rogerclarkmelbourne/STM32_Pill_Boards/BluepillF4/BluepillF4_3D_Top.png

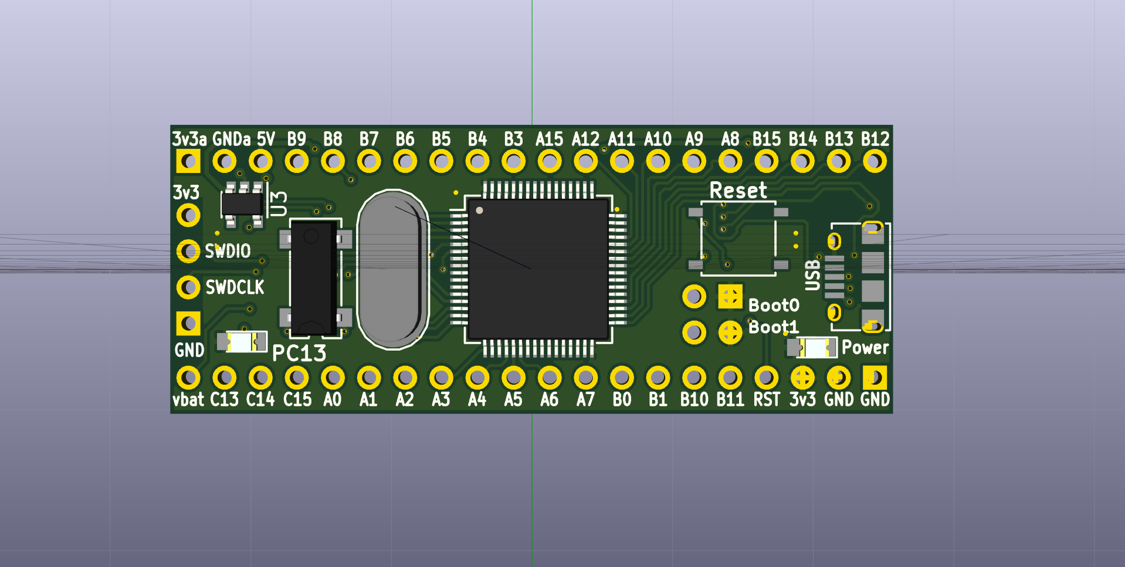
BluepillF4/BluepillF4_3D_Top.png
