rogerclarkmelbourne/STM32_Pill_Boards/BluepillF4/BluepillF4_3D_Bottom.png

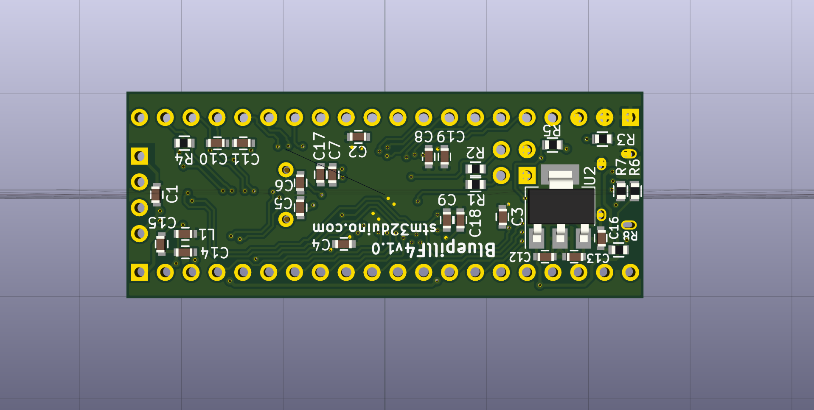
BluepillF4/BluepillF4_3D_Bottom.png
