rogerclarkmelbourne/STM32_Pill_Boards/README.md

# STM32_Pill_Boards

This repo contains a KiCad conversion of the STM32STAMP board and also two new BluePill F4 boards designed by @racemaniac and @Squonk42

My previous attemps have been deleted.
