rogerclarkmelbourne/STM32_Pill_Boards/STM32F4Stamp/README.md

# F405Pill
STM32F405RG development board based on the STM32STAMP board
