rogerclarkmelbourne/STM32_Pill_Boards/Squonk42/KiCAD/3D Models/U02-BFD3111B0-009/U02-BFD3111B0-009 Assembly with Plug.fcstd

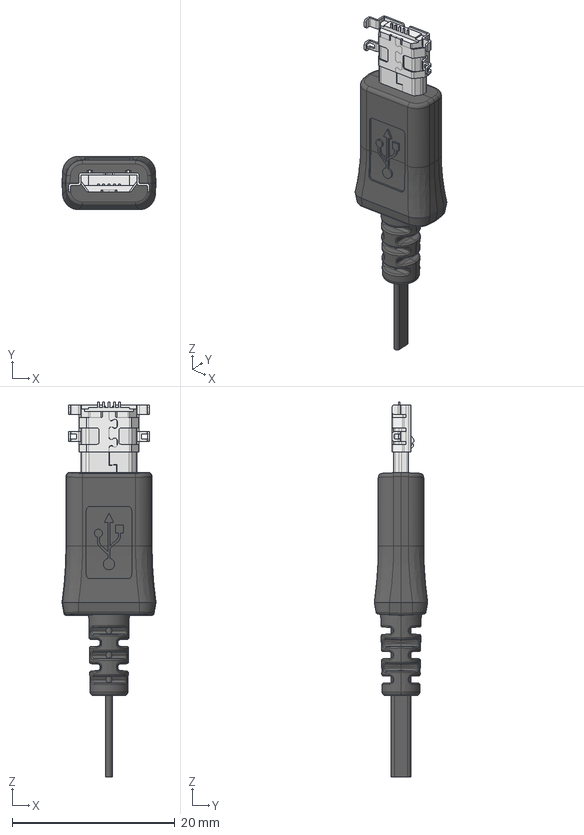
[picture p3: CAD file, 2018-01-29]
Squonk42/KiCAD/3D Models/U02-BFD3111B0-009/U02-BFD3111B0-009 Assembly with Plug.fcstd
11.6 x 6.57 x 46.2 mm
Micro_USB_Plug_Molding_¹w³]
Micro_USB_Plug_cable_¹w³]
Micro_USB_Plug_Connector_¹w³]
Micro_USB_Plug_Connector_¹w³]001
Micro_USB_Plug_Connector_¹w³]002
Micro_USB_Plug_Connector_¹w³]003
U02_BFD3111B0_009_Assembly_01
