rogerclarkmelbourne/STM32_Pill_Boards/Squonk42/KiCAD/3D Models/1616 RGB LED/1616 RGB LED Assembly.fcstd

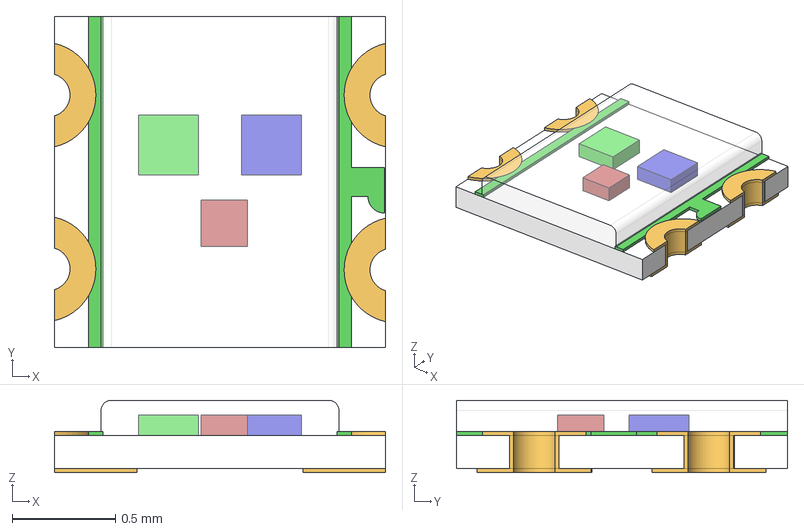
[picture p4: CAD file, 2018-01-02]
Squonk42/KiCAD/3D Models/1616 RGB LED/1616 RGB LED Assembly.fcstd
1.60 x 1.60 x 0.35 mm
_616_RGB_LED_Body_01
_616_RGB_LED_Pad_01
_616_RGB_LED_Pad_002
_616_RGB_LED_Pad_003
_616_RGB_LED_Pad_004
_616_RGB_LED_Lens_01
_616_RGB_LED_Blue_01
_616_RGB_LED_Green_01
_616_RGB_LED_Red_01
_616_RGB_LED_Anode_01
_616_RGB_LED_Cathode_01
