rogerclarkmelbourne/STM32_Pill_Boards/Squonk42/KiCAD/3D Models/MicroSD Card/MicroSD Card Assembly.fcstd

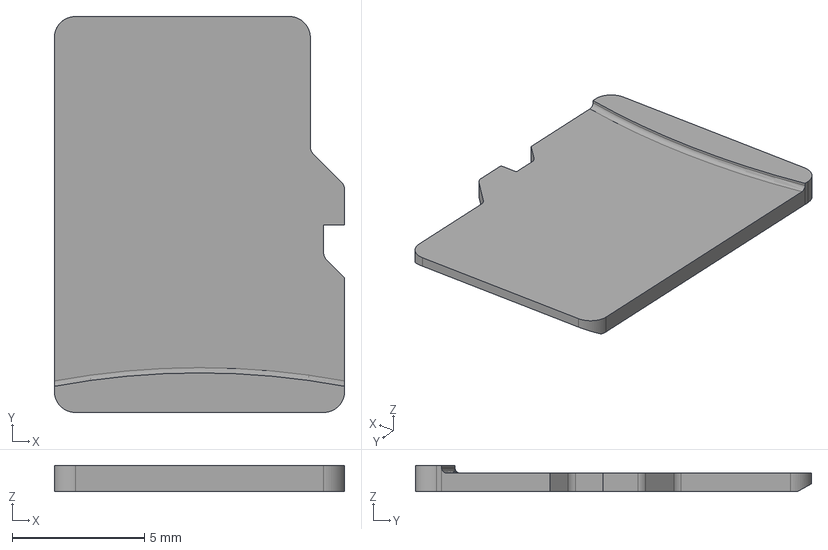
[picture p5: CAD file, 2018-01-02]
Squonk42/KiCAD/3D Models/MicroSD Card/MicroSD Card Assembly.fcstd
11.0 x 15.0 x 1.00 mm
Pin 1
Pin 2
Pin 3
Pin 5
Pin 7
Pin 8
Pin 4
Pin 6
