rogerclarkmelbourne/STM32_Pill_Boards/Squonk42/KiCAD/3D Models/FC-12M/FC-12M Assembly.fcstd

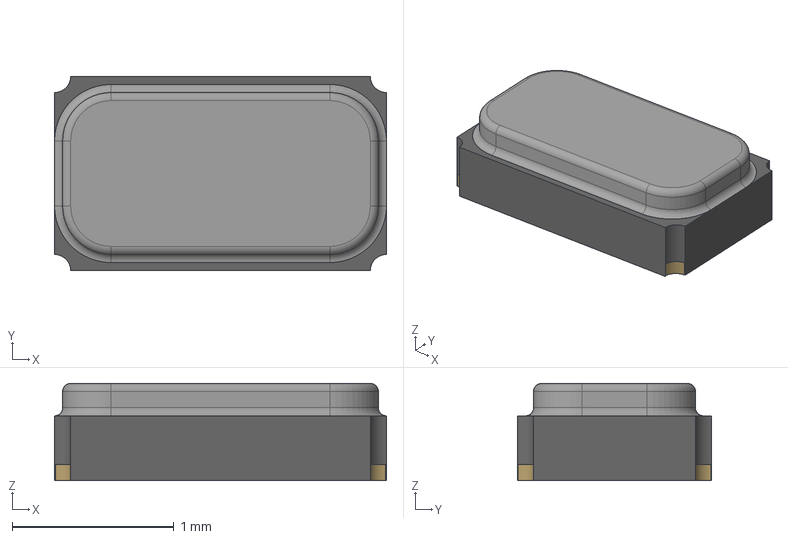
[picture p6: CAD file, 2018-01-02]
Squonk42/KiCAD/3D Models/FC-12M/FC-12M Assembly.fcstd
2.05 x 1.20 x 0.6 mm
FC_12M_Body_01
FC_12M_PAD_01
FC_12M_PAD_1_01
FC_12M_PAD_2_01
FC_12M_Cover_01
