rogerclarkmelbourne/STM32_Pill_Boards/Squonk42/KiCAD/3D Models/U02-BFD3111B0-009/U02-BFD3111B0-009 Assembly.fcstd

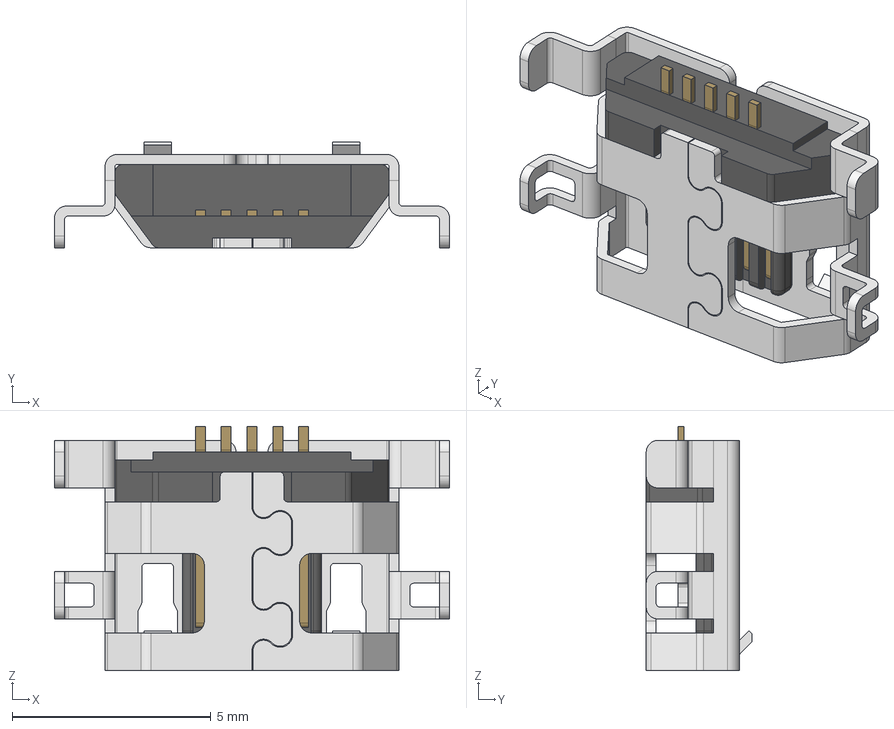
[picture p7: CAD file, 2018-01-02]
Squonk42/KiCAD/3D Models/U02-BFD3111B0-009/U02-BFD3111B0-009 Assembly.fcstd
9.95 x 2.66 x 6.15 mm
U02_BFD3111B0_009_Shell_01
U02_BFD3111B0_009_Body_01
U02_BFD3111B0_009_Pin_01
U02_BFD3111B0_009_Pin_002
U02_BFD3111B0_009_Pin_003
U02_BFD3111B0_009_Pin_004
U02_BFD3111B0_009_Pin_005
