rogerclarkmelbourne/STM32_Pill_Boards/Squonk42/KiCAD/3D Models/MR07C-06200/MR07C-06200 Assembly.fcstd

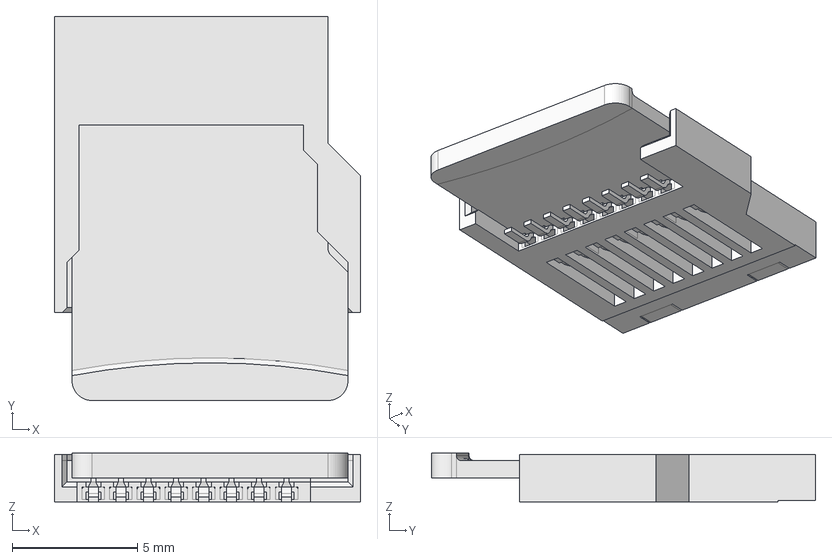
[picture p8: CAD file, 2018-01-02]
Squonk42/KiCAD/3D Models/MR07C-06200/MR07C-06200 Assembly.fcstd
12.2 x 15.3 x 1.95 mm
