rogerclarkmelbourne/STM32_Pill_Boards/Squonk42/KiCAD/3D Models/1616 RGB LED/1616 RGB LED Anode.fcstd

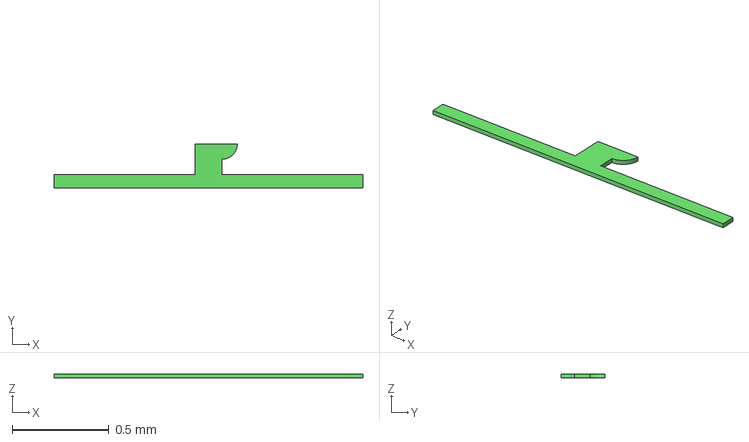
[picture p9: CAD file, 2018-01-02]
Squonk42/KiCAD/3D Models/1616 RGB LED/1616 RGB LED Anode.fcstd
1.60 x 0.23 x 0.02 mm
