rogerclarkmelbourne/STM32_Pill_Boards/Squonk42/KiCAD/3D Models/FC-12M/FC-12M Body.fcstd

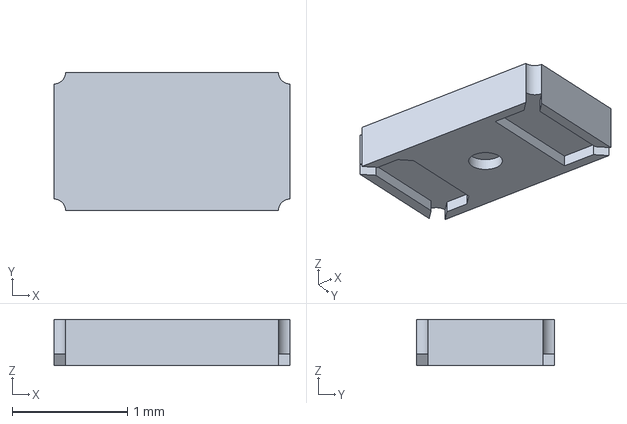
[picture p10: CAD file, 2018-01-02]
Squonk42/KiCAD/3D Models/FC-12M/FC-12M Body.fcstd
2.05 x 1.20 x 0.4 mm
