rogerclarkmelbourne/STM32_Pill_Boards/Squonk42/KiCAD/3D Models/MicroSD Card/MicroSD Card Body.fcstd

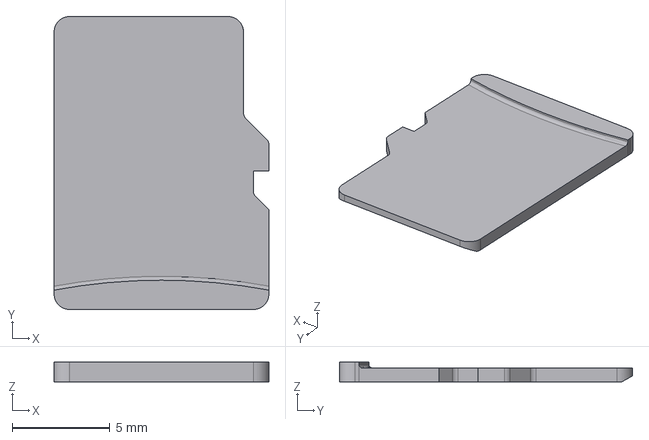
[picture p11: CAD file, 2018-01-02]
Squonk42/KiCAD/3D Models/MicroSD Card/MicroSD Card Body.fcstd
11.0 x 15.0 x 1.00 mm
