rogerclarkmelbourne/STM32_Pill_Boards/Squonk42/KiCAD/3D Models/1616 RGB LED/1616 RGB LED Red.fcstd

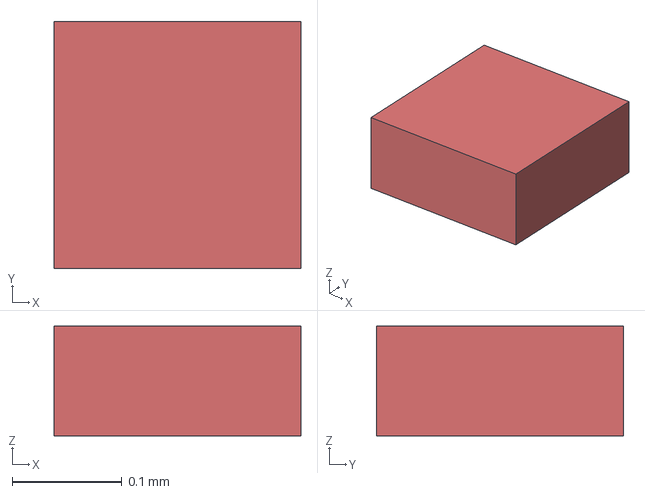
[picture p12: CAD file, 2018-01-02]
Squonk42/KiCAD/3D Models/1616 RGB LED/1616 RGB LED Red.fcstd
0.225 x 0.225 x 0.1 mm
