rogerclarkmelbourne/STM32_Pill_Boards/Squonk42/KiCAD/3D Models/FC-12M/FC-12M PAD.fcstd

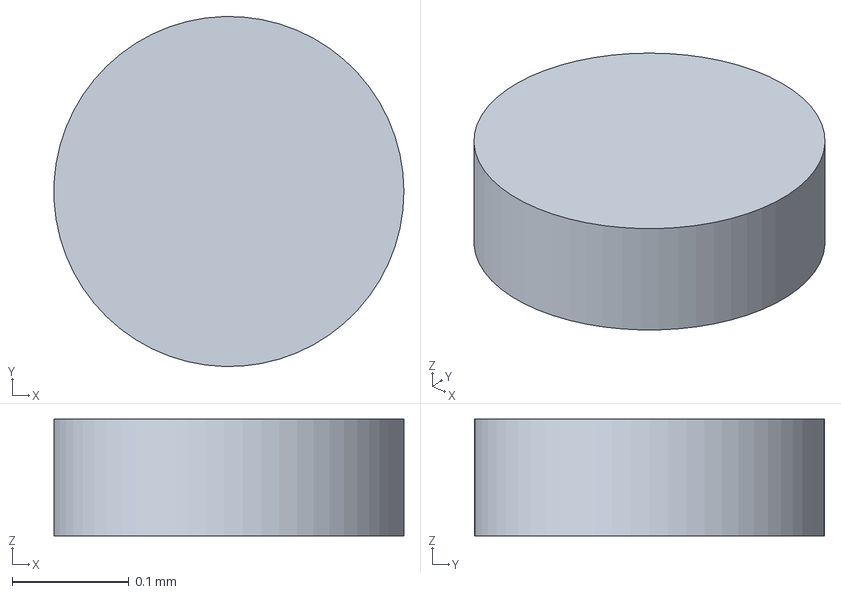
[picture p13: CAD file, 2018-01-02]
Squonk42/KiCAD/3D Models/FC-12M/FC-12M PAD.fcstd
0.3 x 0.3 x 0.1 mm
