rogerclarkmelbourne/STM32_Pill_Boards/Squonk42/KiCAD/3D Models/MicroSD Card/MicroSD Card Long Pin.fcstd

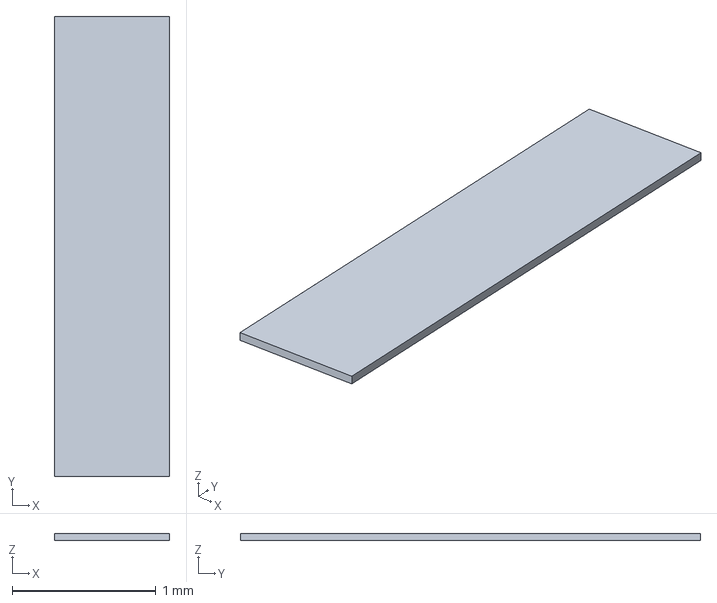
[picture p14: CAD file, 2018-01-02]
Squonk42/KiCAD/3D Models/MicroSD Card/MicroSD Card Long Pin.fcstd
0.8 x 3.20 x 0.05 mm
