rogerclarkmelbourne/STM32_Pill_Boards/Squonk42/KiCAD/3D Models/MR07C-06200/MR07C-06200 Pin.fcstd

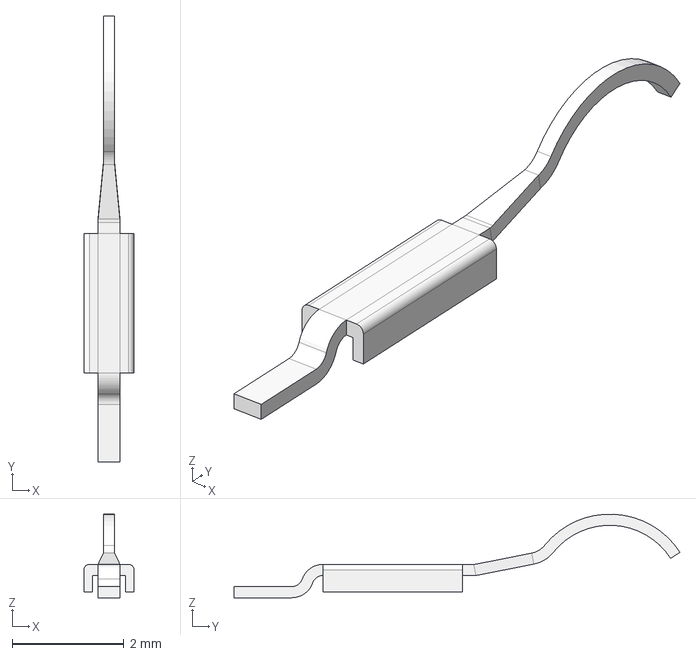
[picture p15: CAD file, 2018-01-02]
Squonk42/KiCAD/3D Models/MR07C-06200/MR07C-06200 Pin.fcstd
0.9 x 8.00 x 1.50 mm
