rogerclarkmelbourne/STM32_Pill_Boards/Squonk42/KiCAD/3D Models/FC-12M/FC-12M PAD 1.fcstd

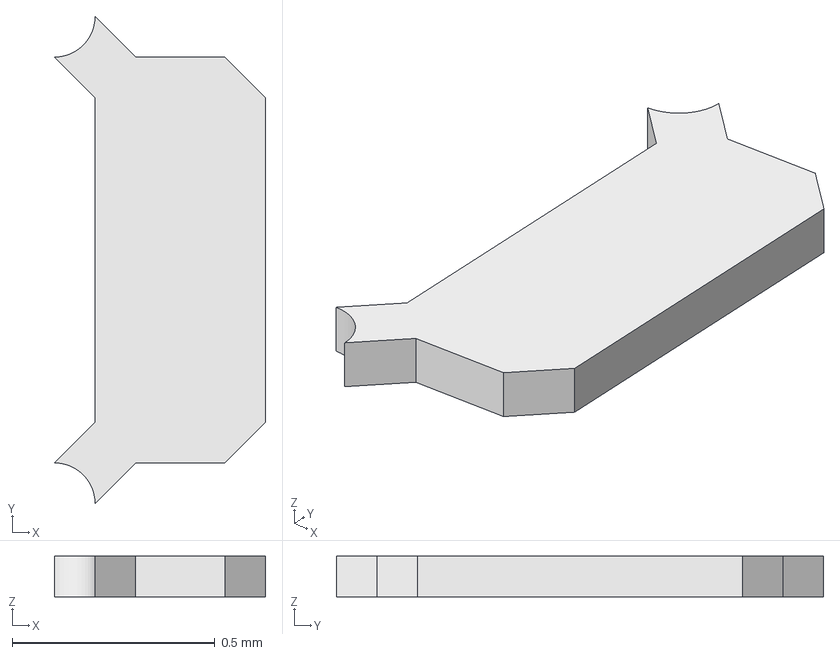
[picture p16: CAD file, 2018-01-02]
Squonk42/KiCAD/3D Models/FC-12M/FC-12M PAD 1.fcstd
0.52 x 1.20 x 0.1 mm
