rogerclarkmelbourne/STM32_Pill_Boards/Squonk42/KiCAD/3D Models/MR07C-06200/MR07C-06200 Ground Pin.fcstd

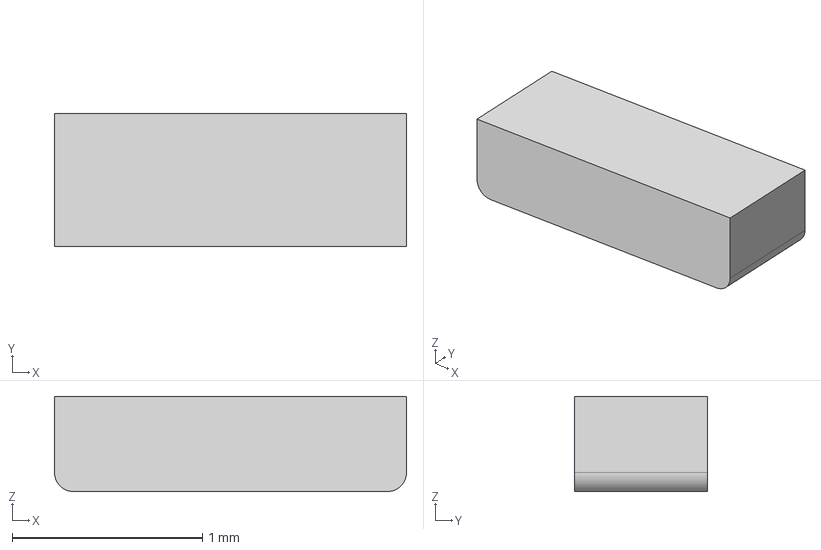
[picture p17: CAD file, 2018-01-02]
Squonk42/KiCAD/3D Models/MR07C-06200/MR07C-06200 Ground Pin.fcstd
1.85 x 0.7 x 0.5 mm
