rogerclarkmelbourne/STM32_Pill_Boards/Squonk42/KiCAD/3D Models/U02-BFD3111B0-009/U02-BFD3111B0-009 Body.fcstd

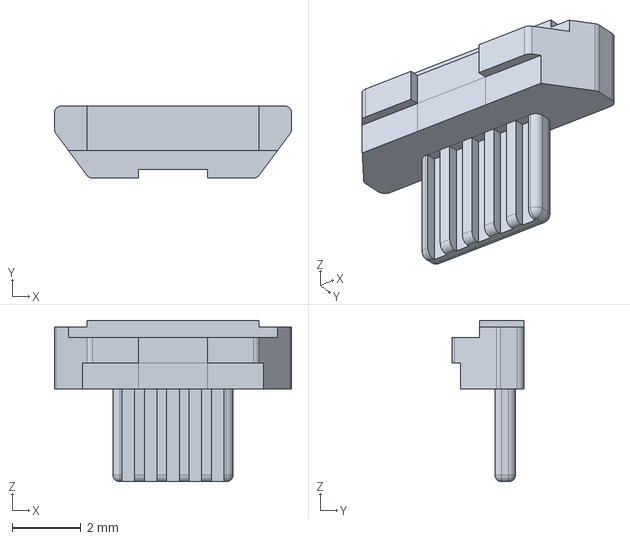
[picture p18: CAD file, 2018-01-02]
Squonk42/KiCAD/3D Models/U02-BFD3111B0-009/U02-BFD3111B0-009 Body.fcstd
6.90 x 2.10 x 4.70 mm
