rogerclarkmelbourne/STM32_Pill_Boards/Squonk42/KiCAD/3D Models/1616 RGB LED/1616 RGB LED Pad.fcstd

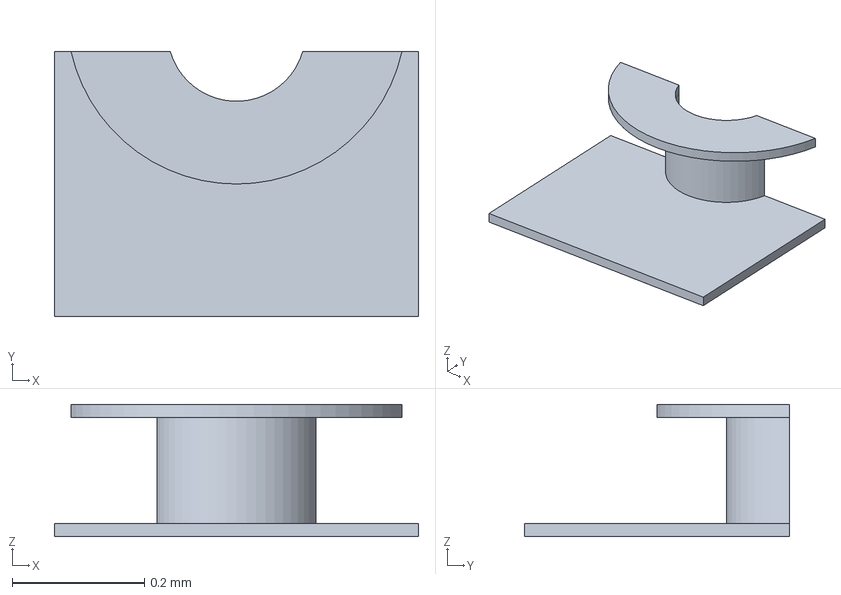
[picture p19: CAD file, 2018-01-02]
Squonk42/KiCAD/3D Models/1616 RGB LED/1616 RGB LED Pad.fcstd
0.55 x 0.4 x 0.2 mm
