rogerclarkmelbourne/STM32_Pill_Boards/Squonk42/KiCAD/3D Models/MicroSD Card/MicroSD Card Short Pin.fcstd

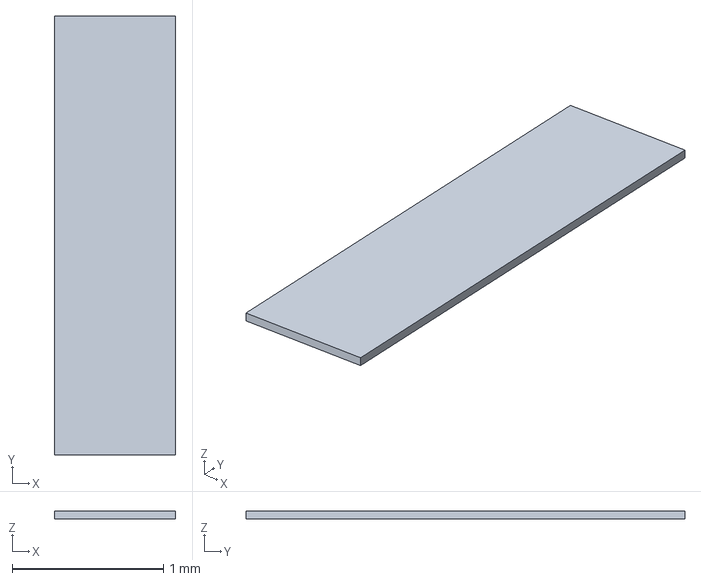
[picture p20: CAD file, 2018-01-02]
Squonk42/KiCAD/3D Models/MicroSD Card/MicroSD Card Short Pin.fcstd
0.8 x 2.90 x 0.05 mm
