rogerclarkmelbourne/STM32_Pill_Boards/Squonk42/KiCAD/3D Models/MR07C-06200/MR07C-06200 Body.fcstd

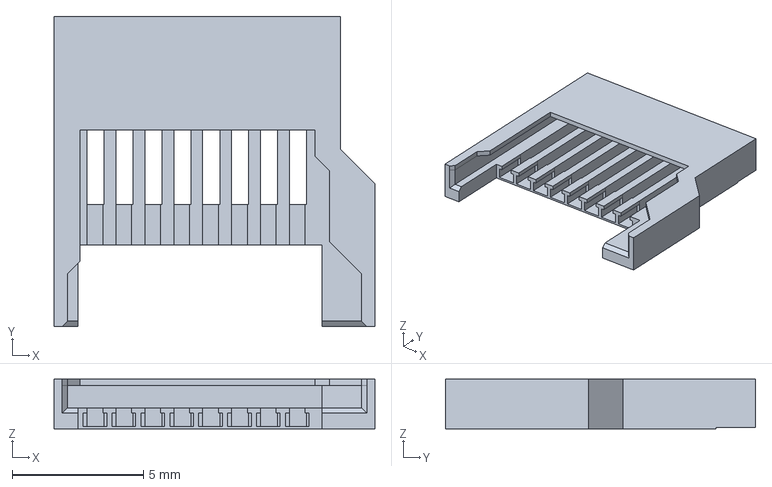
[picture p21: CAD file, 2018-01-02]
Squonk42/KiCAD/3D Models/MR07C-06200/MR07C-06200 Body.fcstd
12.2 x 11.8 x 1.90 mm
