rogerclarkmelbourne/STM32_Pill_Boards/Squonk42/KiCAD/3D Models/1616 RGB LED/1616 RGB LED Body.fcstd

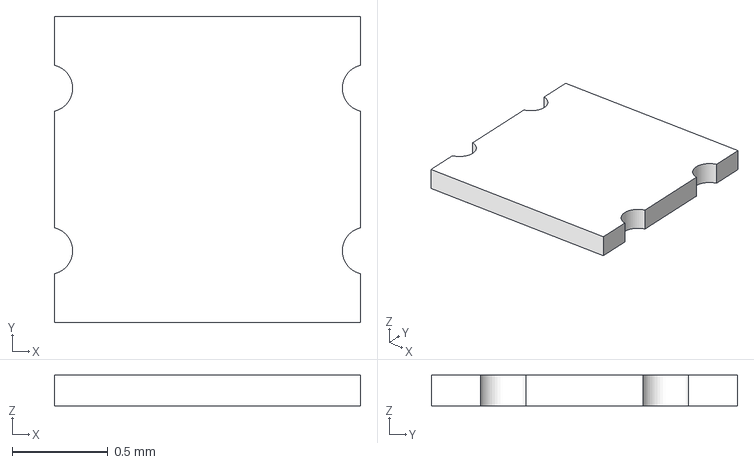
[picture p22: CAD file, 2018-01-02]
Squonk42/KiCAD/3D Models/1616 RGB LED/1616 RGB LED Body.fcstd
1.60 x 1.60 x 0.16 mm
