rogerclarkmelbourne/STM32_Pill_Boards/Squonk42/KiCAD/3D Models/FC-12M/FC-12M Cover.fcstd

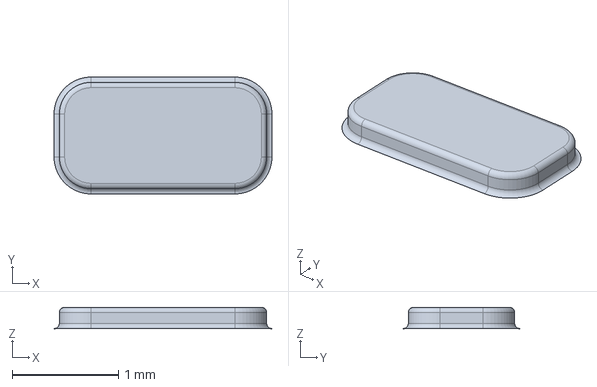
[picture p23: CAD file, 2018-01-02]
Squonk42/KiCAD/3D Models/FC-12M/FC-12M Cover.fcstd
2.05 x 1.10 x 0.2 mm
