rogerclarkmelbourne/STM32_Pill_Boards/Squonk42/KiCAD/3D Models/U02-BFD3111B0-009/U02-BFD3111B0-009 Pin.fcstd

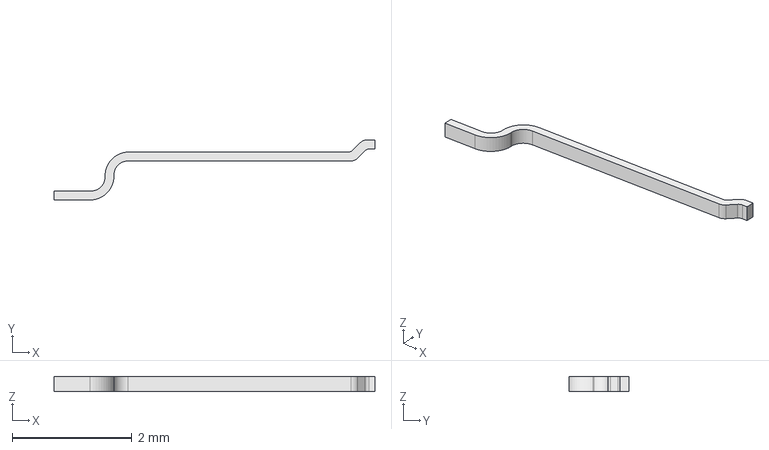
[picture p24: CAD file, 2018-01-02]
Squonk42/KiCAD/3D Models/U02-BFD3111B0-009/U02-BFD3111B0-009 Pin.fcstd
5.35 x 1.00 x 0.25 mm
