rogerclarkmelbourne/STM32_Pill_Boards/Squonk42/KiCAD/3D Models/U02-BFD3111B0-009/U02-BFD3111B0-009 Shell.fcstd

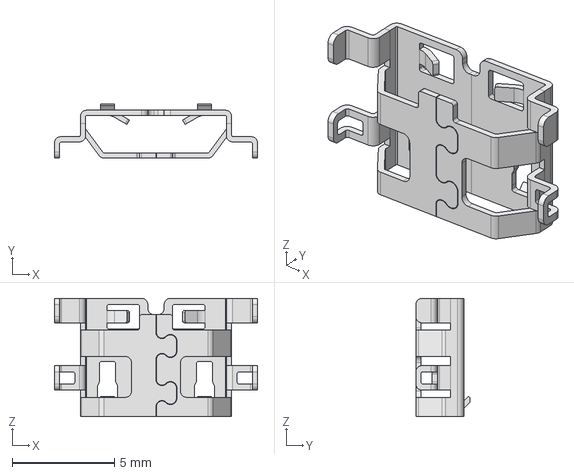
[picture p26: CAD file, 2018-01-02]
Squonk42/KiCAD/3D Models/U02-BFD3111B0-009/U02-BFD3111B0-009 Shell.fcstd
9.95 x 2.66 x 5.80 mm
