rogerclarkmelbourne/STM32_Pill_Boards/(list of files, cad)

Other CAD files:
Squonk42/KiCAD/3D Models/MR07C-06200/MR07C-06200 with SDCard.fcstd
Squonk42/KiCAD/3D Models/U02-BFD3111B0-009/Micro_USB_Plug.fcstd
Squonk42/KiCAD/3D Models/FC-12M/FC-12M PAD 2.fcstd
Squonk42/KiCAD/3D Models/1616 RGB LED/1616 RGB LED Blue.fcstd
