rogerclarkmelbourne/STM32_Pill_Boards/(threads)

Thread 7 (2021-04-22):

Can I remove this repo?

rogerclarkmelbourne, 2021-04-22:
@Squonk42

Do you have a copy of the files, or have them hosted elsewher on Github ?

I am not active with the STM32 at the moment, and I am cleaning my Github account to remove redundant repo's, so I would like to remove this repo

Thanks

Roger

Michel-FK, 2021-04-22:
Hi Roger,

I have a copy of the repo here: https://github.com/Squonk42/STM32_Pill_Boards

But it is generally a bad idea to remove repos that are referenced from outside, since there is no way to redirect them.

Cheers,
Michel

rogerclarkmelbourne, 2021-04-22:
OK.

No worries

In that case I will not delete it

Thanks

Roger
