rogerclarkmelbourne/STM32_Pill_Boards/Squonk42/EagleCAD/PDF/BluePillF4.pdf

BOOT0/ | RESET

# USER

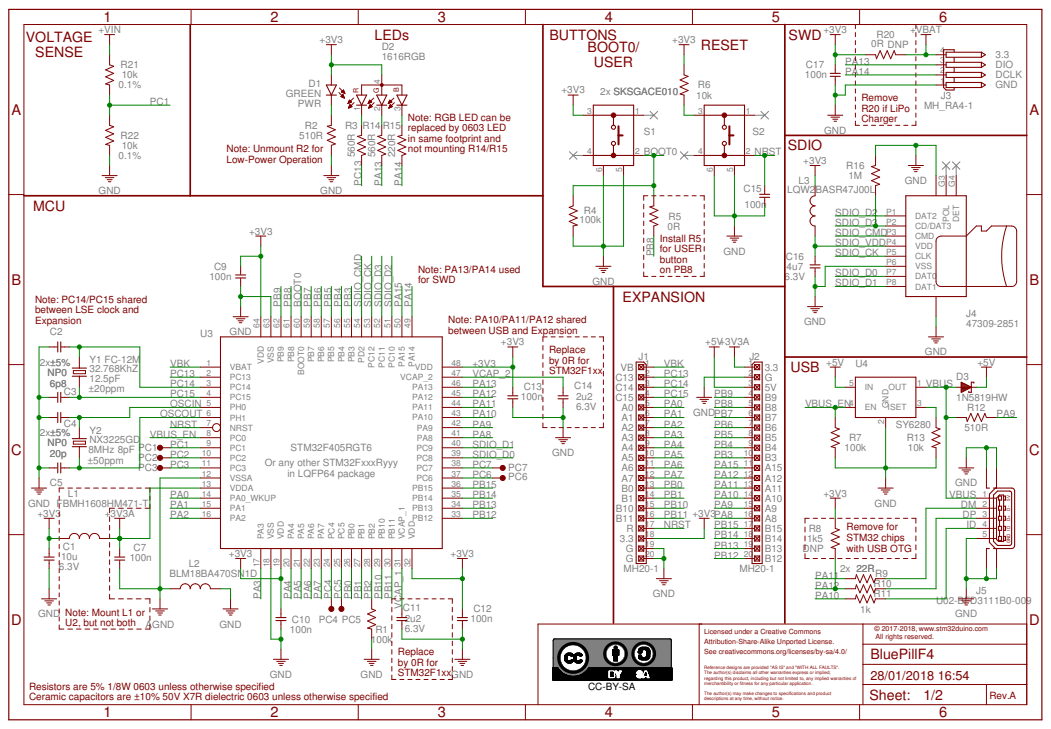
[picture p29: page 1]

+VIN 10k | LEDs +3V3 | BUTTONS +3V3 R6 +3V3 2x on PB8 | +3V3 +VBAT 100nGND

Remove R20 if LiPo Charger

Note: RGB LED can be
replaced by 0603 LED

between USB and Expansion

Remove for STM32 chips with USB OTG

Note: Mount L1 or U2, but not both
GND

Licensed under a Creative Commons Attribution-Share-Alike Unported License. See creativecommons.org/licenses/by-sa/4.0/ Reference designs are provided "AS IS" and "WITH ALL FAULTS". regarding this product, including but not limited to, any implied warranties of The author(s) may make changes to specifications and product The author(s) disclaims all other warranties express or implied, merchantibility or fitness for any particular application. descriptions at any time, without notice.

A

A

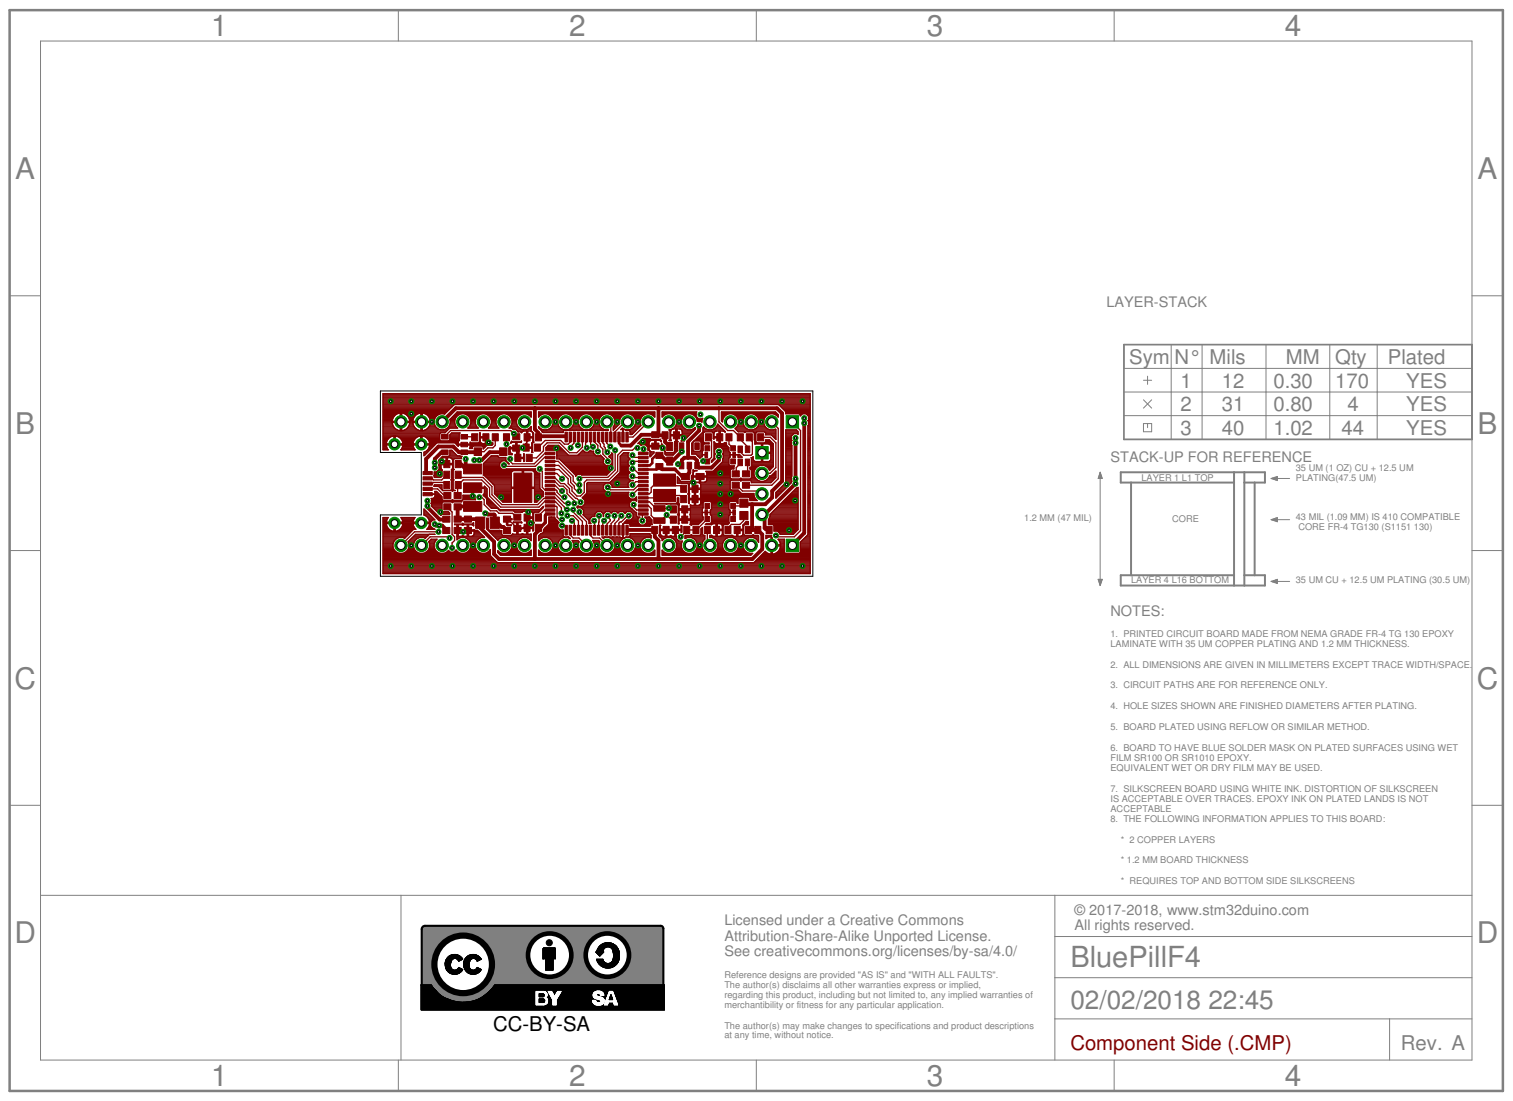
[picture p30: page 2]
LAYER 1 L1 TOP; LAYER 4 L16 BOTTOM; CORE; Rev. A; 1.2 MM (47 MIL); LAYER-STACK; Sym N° Mils; MM Qty Plated; YES

43 MIL (1.09 MM) IS 410 COMPATIBLE CORE FR-4 TG130 (S1151 130) STACK-UP FOR REFERENCE

PLATING(47.5 UM)

35 UM CU + 12.5 UM PLATING (30.5 UM)

NOTES: 2. ALL DIMENSIONS ARE GIVEN IN MILLIMETERS EXCEPT TRACE WIDTH/SPACE. 3. CIRCUIT PATHS ARE FOR REFERENCE ONLY.

1. PRINTED CIRCUIT BOARD MADE FROM NEMA GRADE FR-4 TG 130 EPOXY
LAMINATE WITH 35 UM COPPER PLATING AND 1.2 MM THICKNESS.

4. HOLE SIZES SHOWN ARE FINISHED DIAMETERS AFTER PLATING. 5. BOARD PLATED USING REFLOW OR SIMILAR METHOD. 6. BOARD TO HAVE BLUE SOLDER MASK ON PLATED SURFACES USING WET

FILM SR100 OR SR1010 EPOXY. EQUIVALENT WET OR DRY FILM MAY BE USED. 8. THE FOLLOWING INFORMATION APPLIES TO THIS BOARD: 7. SILKSCREEN BOARD USING WHITE INK. DISTORTION OF SILKSCREEN

IS ACCEPTABLE OVER TRACES. EPOXY INK ON PLATED LANDS IS NOT ACCEPTABLE

* 2 COPPER LAYERS
* 1.2 MM BOARD THICKNESS
* REQUIRES TOP AND BOTTOM SIDE SILKSCREENS
BluePillF4
Component Side (.CMP)

All rights reserved. www.stm32duino.com

Licensed under a Creative Commons Attribution-Share-Alike Unported License. See creativecommons.org/licenses/by-sa/4.0/ Reference designs are provided "AS IS" and "WITH ALL FAULTS". The author(s) disclaims all other warranties express or implied, regarding this product, including but not limited to, any implied warranties of merchantibility or fitness for any particular application. The author(s) may make changes to specifications and product descriptions at any time, without notice.

A

A

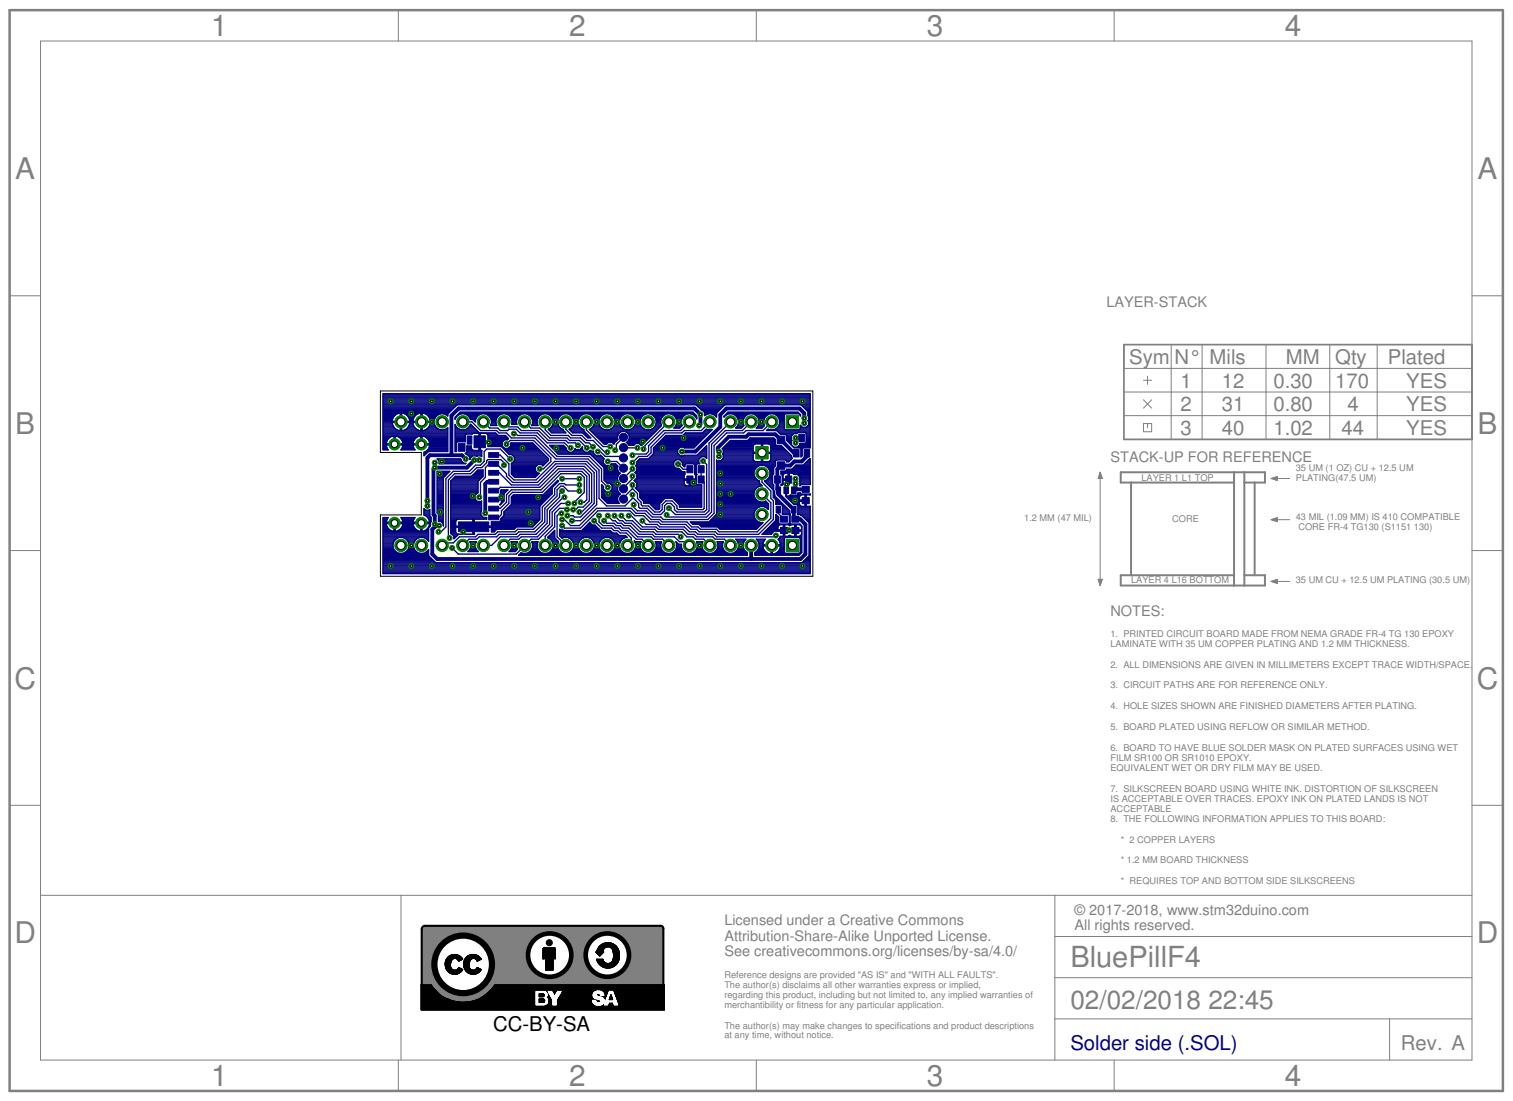
[picture p31: page 3]
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

PLATING(47.5 UM)

35 UM CU + 12.5 UM PLATING (30.5 UM)

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

1. PRINTED CIRCUIT BOARD MADE FROM NEMA GRADE FR-4 TG 130 EPOXY
LAMINATE WITH 35 UM COPPER PLATING AND 1.2 MM THICKNESS.

4. HOLE SIZES SHOWN ARE FINISHED DIAMETERS AFTER PLATING. 5. BOARD PLATED USING REFLOW OR SIMILAR METHOD. 6. BOARD TO HAVE BLUE SOLDER MASK ON PLATED SURFACES USING WET

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

IS ACCEPTABLE OVER TRACES. EPOXY INK ON PLATED LANDS IS NOT ACCEPTABLE

* 2 COPPER LAYERS
* 1.2 MM BOARD THICKNESS
* REQUIRES TOP AND BOTTOM SIDE SILKSCREENS
BluePillF4
Solder side (.SOL)

All rights reserved. www.stm32duino.com

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

A

A

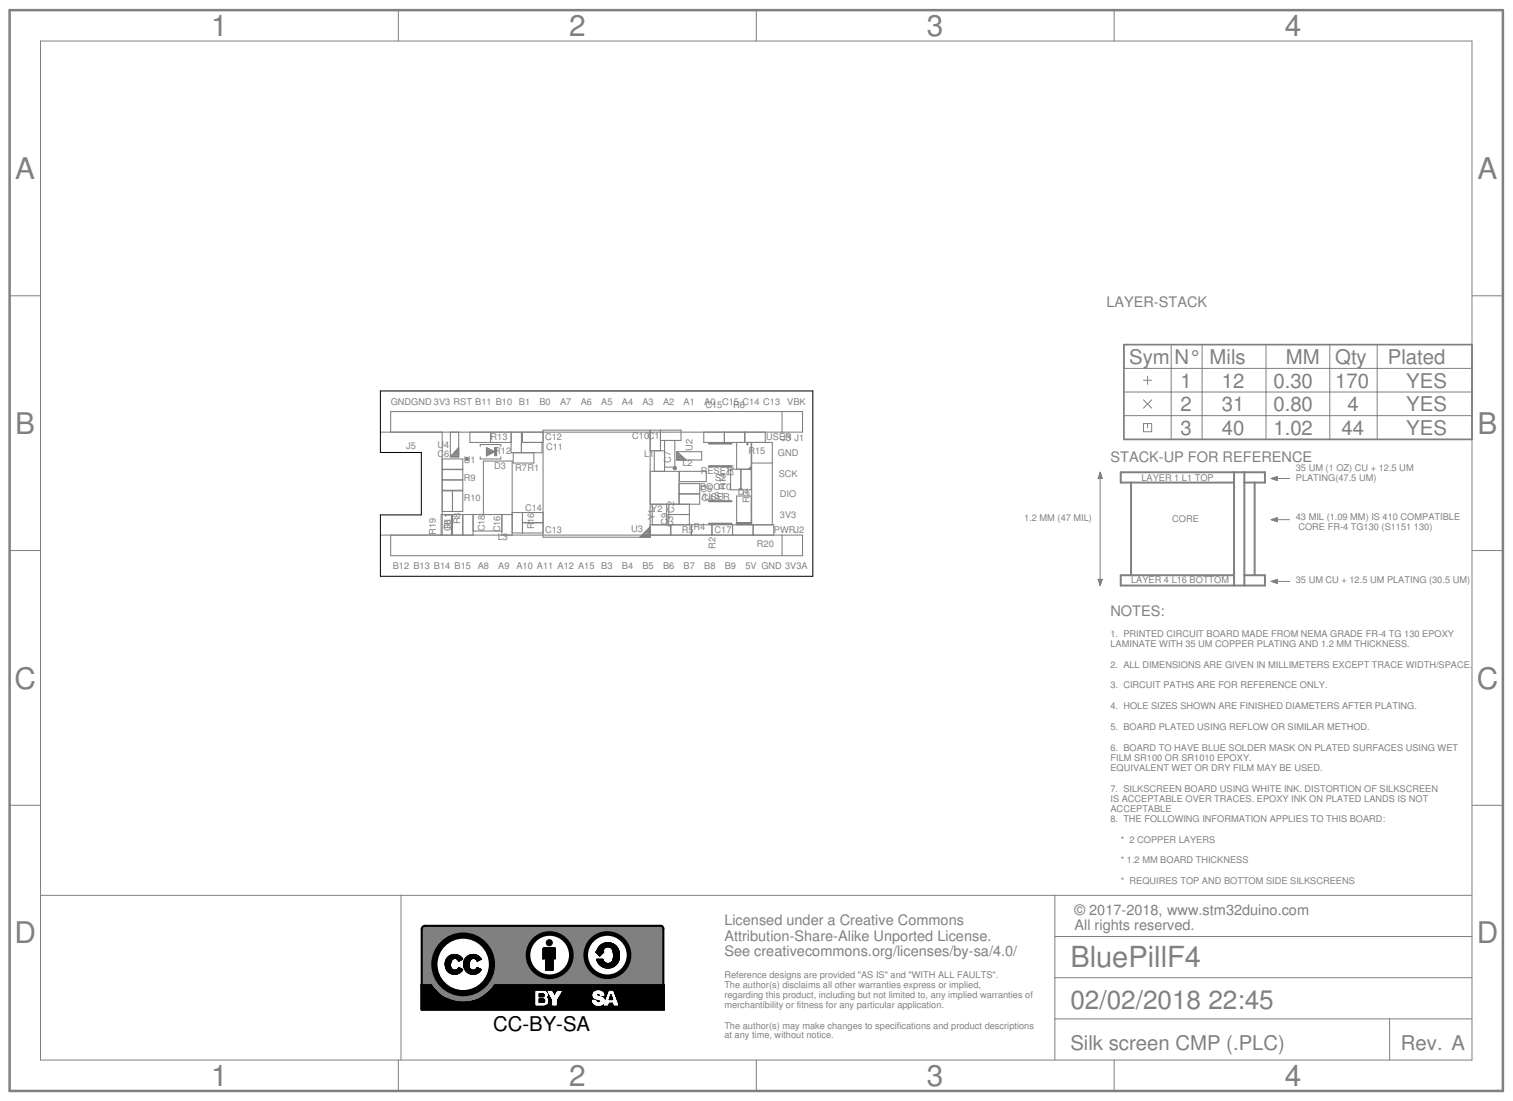
[picture p32: page 4]

Sym N° | | Mils | MM | Qty | Plated
1 | 12 | 0.30 | 170 | YES

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

PLATING(47.5 UM)

L3 R¹⁹

35 UM CU + 12.5 UM PLATING (30.5 UM)

1. PRINTED CIRCUIT BOARD MADE FROM NEMA GRADE FR-4 TG 130 EPOXY
LAMINATE WITH 35 UM COPPER PLATING AND 1.2 MM THICKNESS.

4. HOLE SIZES SHOWN ARE FINISHED DIAMETERS AFTER PLATING. 5. BOARD PLATED USING REFLOW OR SIMILAR METHOD. 6. BOARD TO HAVE BLUE SOLDER MASK ON PLATED SURFACES USING WET

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

IS ACCEPTABLE OVER TRACES. EPOXY INK ON PLATED LANDS IS NOT ACCEPTABLE

* 2 COPPER LAYERS
* 1.2 MM BOARD THICKNESS
* REQUIRES TOP AND BOTTOM SIDE SILKSCREENS
BluePillF4
Silk screen CMP (.PLC)

All rights reserved. www.stm32duino.com

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

A

A

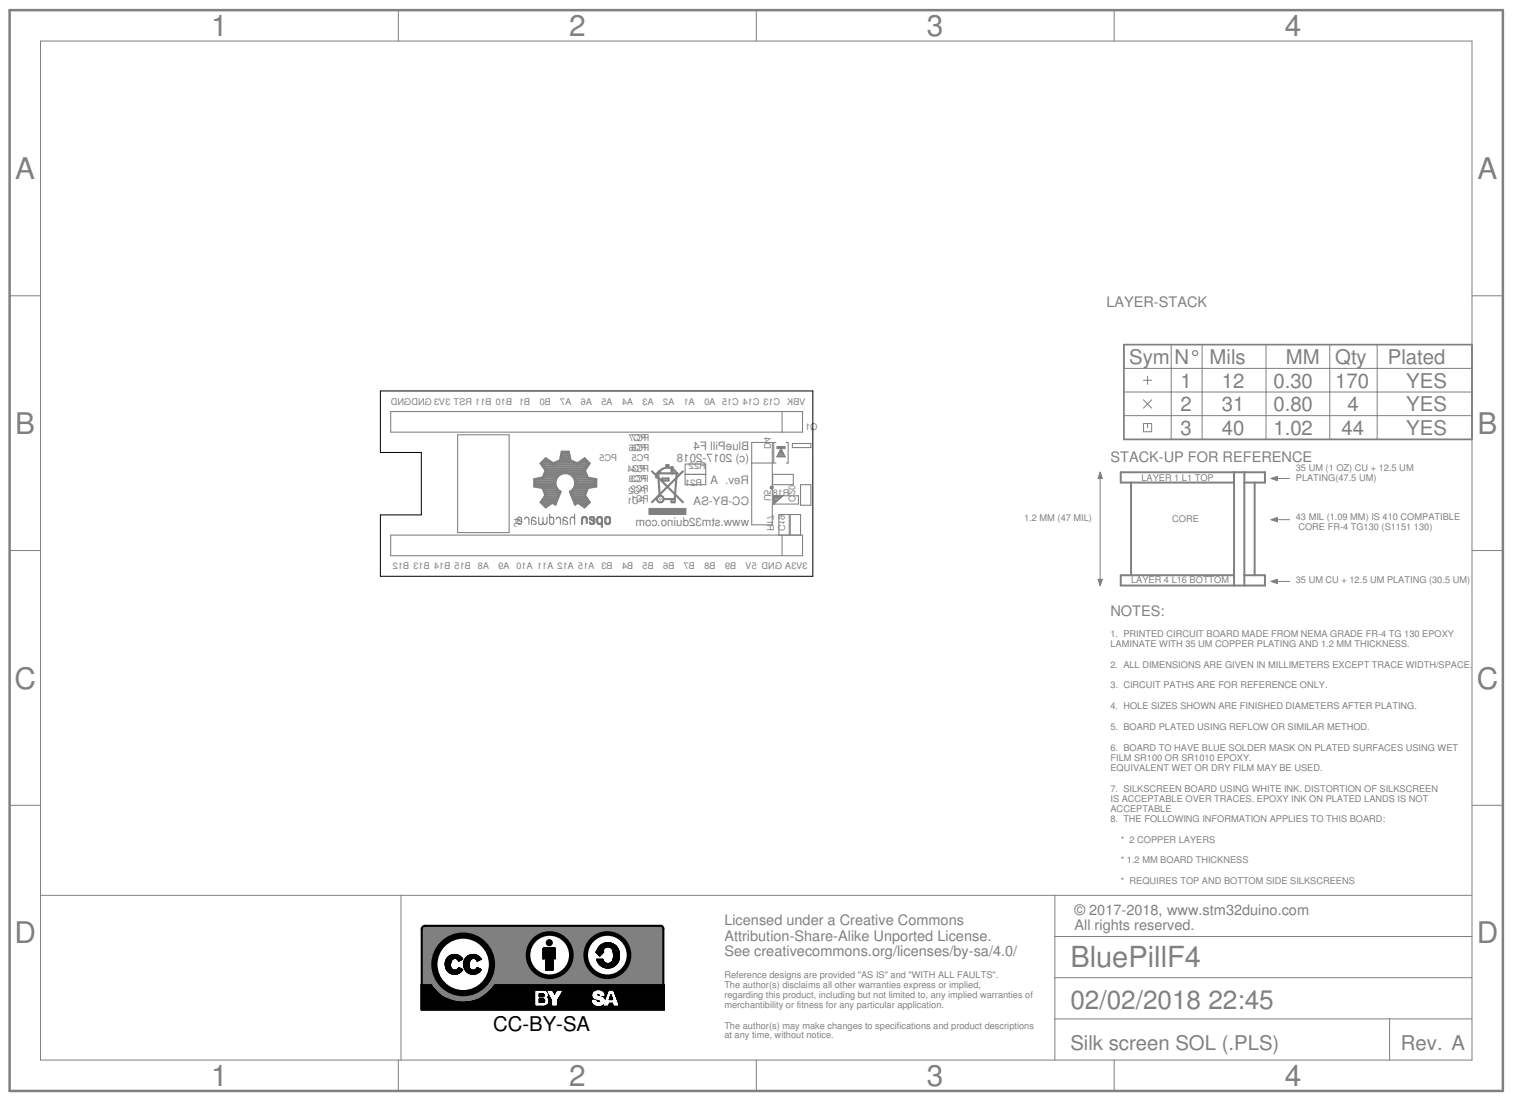
[picture p33: page 5]

Sym N° | | Mils | MM | Qty | Plated
1 | 12 | 0.30 | 170 | YES
2 | 31 | 0.80 | 4 | YES
3 | 40 | 1.02 | 44 | YES

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

PLATING(47.5 UM)

35 UM CU + 12.5 UM PLATING (30.5 UM)

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

1. PRINTED CIRCUIT BOARD MADE FROM NEMA GRADE FR-4 TG 130 EPOXY
LAMINATE WITH 35 UM COPPER PLATING AND 1.2 MM THICKNESS.

4. HOLE SIZES SHOWN ARE FINISHED DIAMETERS AFTER PLATING. 5. BOARD PLATED USING REFLOW OR SIMILAR METHOD. 6. BOARD TO HAVE BLUE SOLDER MASK ON PLATED SURFACES USING WET

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

IS ACCEPTABLE OVER TRACES. EPOXY INK ON PLATED LANDS IS NOT ACCEPTABLE

* 2 COPPER LAYERS
* 1.2 MM BOARD THICKNESS
* REQUIRES TOP AND BOTTOM SIDE SILKSCREENS
BluePillF4
Silk screen SOL (.PLS)

All rights reserved. www.stm32duino.com

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

A

A

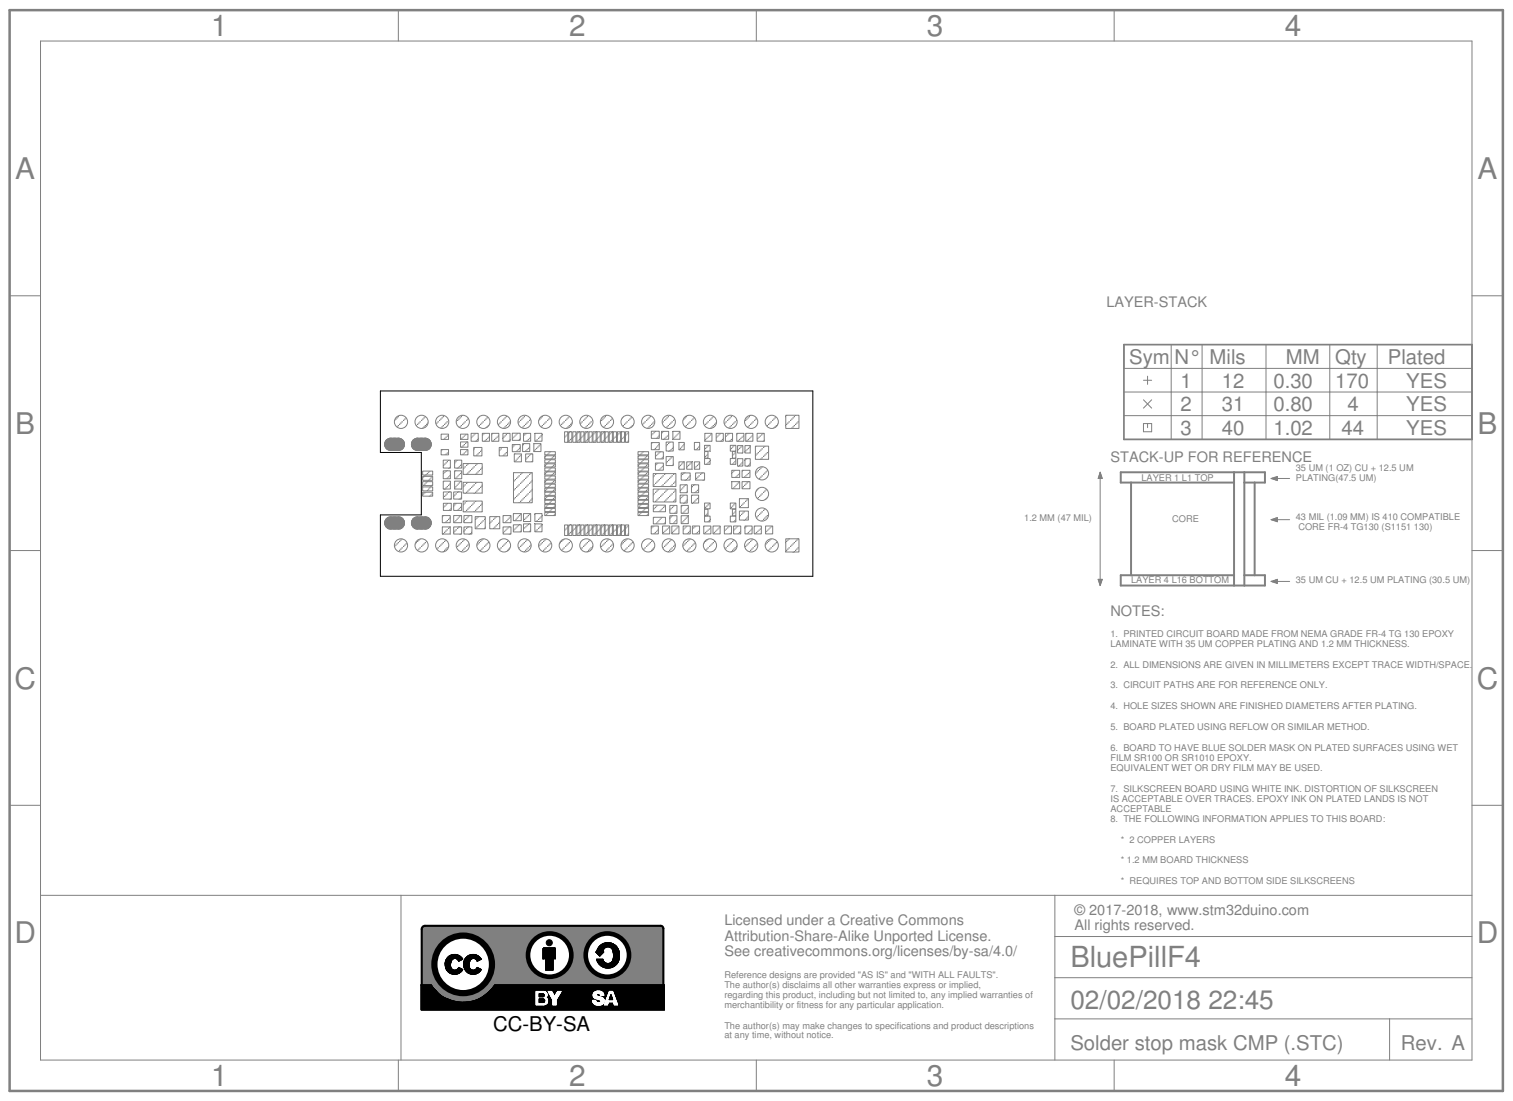
[picture p34: page 6]
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

PLATING(47.5 UM)

35 UM CU + 12.5 UM PLATING (30.5 UM)

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

1. PRINTED CIRCUIT BOARD MADE FROM NEMA GRADE FR-4 TG 130 EPOXY
LAMINATE WITH 35 UM COPPER PLATING AND 1.2 MM THICKNESS.

4. HOLE SIZES SHOWN ARE FINISHED DIAMETERS AFTER PLATING. 5. BOARD PLATED USING REFLOW OR SIMILAR METHOD. 6. BOARD TO HAVE BLUE SOLDER MASK ON PLATED SURFACES USING WET

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

IS ACCEPTABLE OVER TRACES. EPOXY INK ON PLATED LANDS IS NOT ACCEPTABLE

* 2 COPPER LAYERS
* 1.2 MM BOARD THICKNESS
* REQUIRES TOP AND BOTTOM SIDE SILKSCREENS
BluePillF4
Solder stop mask CMP (.STC)

All rights reserved. www.stm32duino.com

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

A

A

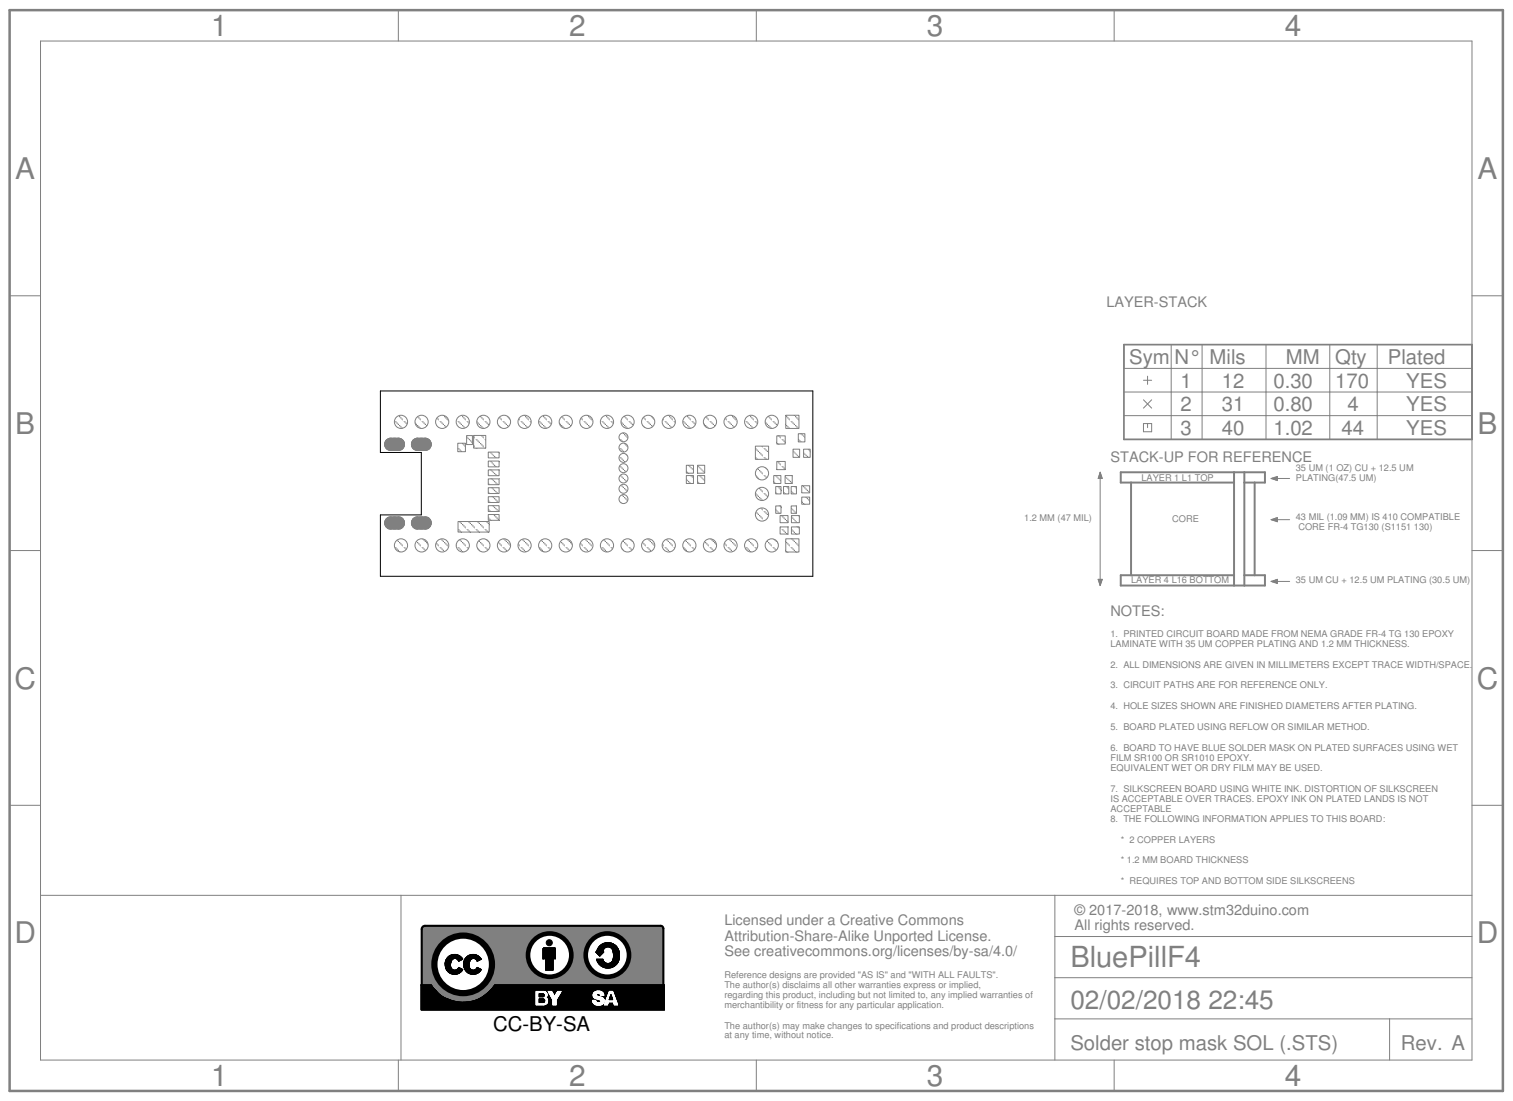
[picture p35: page 7]
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

PLATING(47.5 UM)

35 UM CU + 12.5 UM PLATING (30.5 UM)

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

1. PRINTED CIRCUIT BOARD MADE FROM NEMA GRADE FR-4 TG 130 EPOXY
LAMINATE WITH 35 UM COPPER PLATING AND 1.2 MM THICKNESS.

4. HOLE SIZES SHOWN ARE FINISHED DIAMETERS AFTER PLATING. 5. BOARD PLATED USING REFLOW OR SIMILAR METHOD. 6. BOARD TO HAVE BLUE SOLDER MASK ON PLATED SURFACES USING WET

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

IS ACCEPTABLE OVER TRACES. EPOXY INK ON PLATED LANDS IS NOT ACCEPTABLE

* 2 COPPER LAYERS
* 1.2 MM BOARD THICKNESS
* REQUIRES TOP AND BOTTOM SIDE SILKSCREENS
BluePillF4
Solder stop mask SOL (.STS)

All rights reserved. www.stm32duino.com

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

A

A

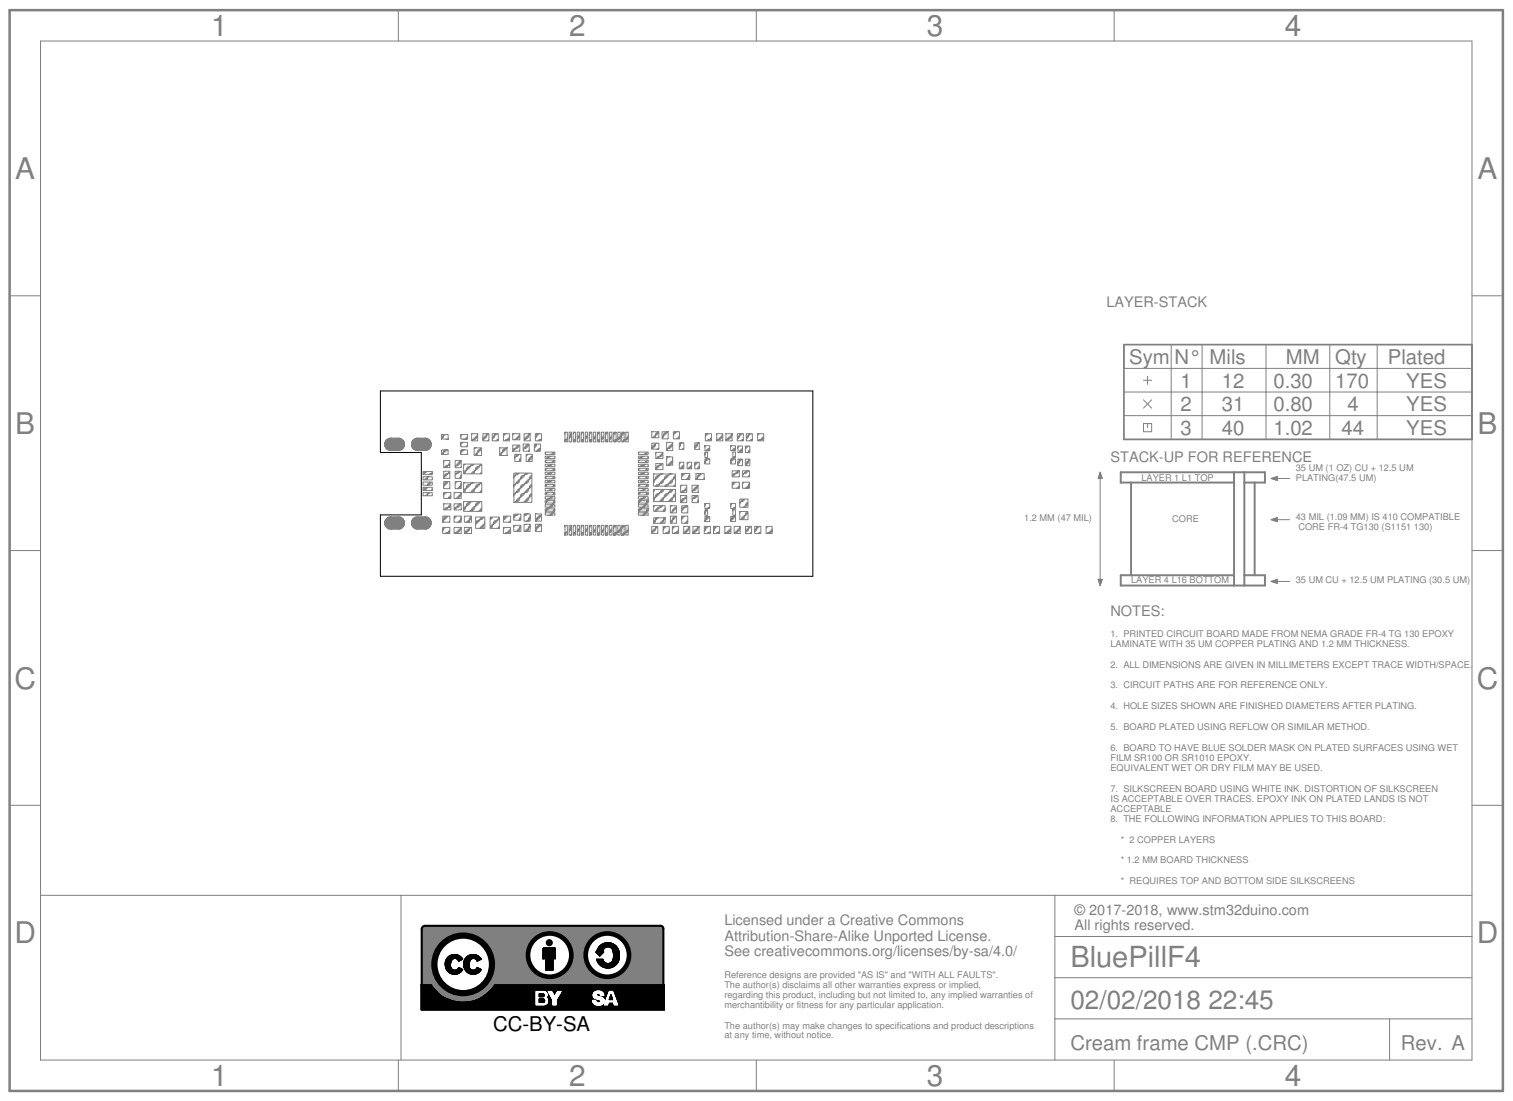
[picture p36: page 8]
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

PLATING(47.5 UM)

35 UM CU + 12.5 UM PLATING (30.5 UM)

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

1. PRINTED CIRCUIT BOARD MADE FROM NEMA GRADE FR-4 TG 130 EPOXY
LAMINATE WITH 35 UM COPPER PLATING AND 1.2 MM THICKNESS.

4. HOLE SIZES SHOWN ARE FINISHED DIAMETERS AFTER PLATING. 5. BOARD PLATED USING REFLOW OR SIMILAR METHOD. 6. BOARD TO HAVE BLUE SOLDER MASK ON PLATED SURFACES USING WET

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

IS ACCEPTABLE OVER TRACES. EPOXY INK ON PLATED LANDS IS NOT ACCEPTABLE

* 2 COPPER LAYERS
* 1.2 MM BOARD THICKNESS
* REQUIRES TOP AND BOTTOM SIDE SILKSCREENS
BluePillF4
Cream frame CMP (.CRC)

All rights reserved. www.stm32duino.com

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

A

A

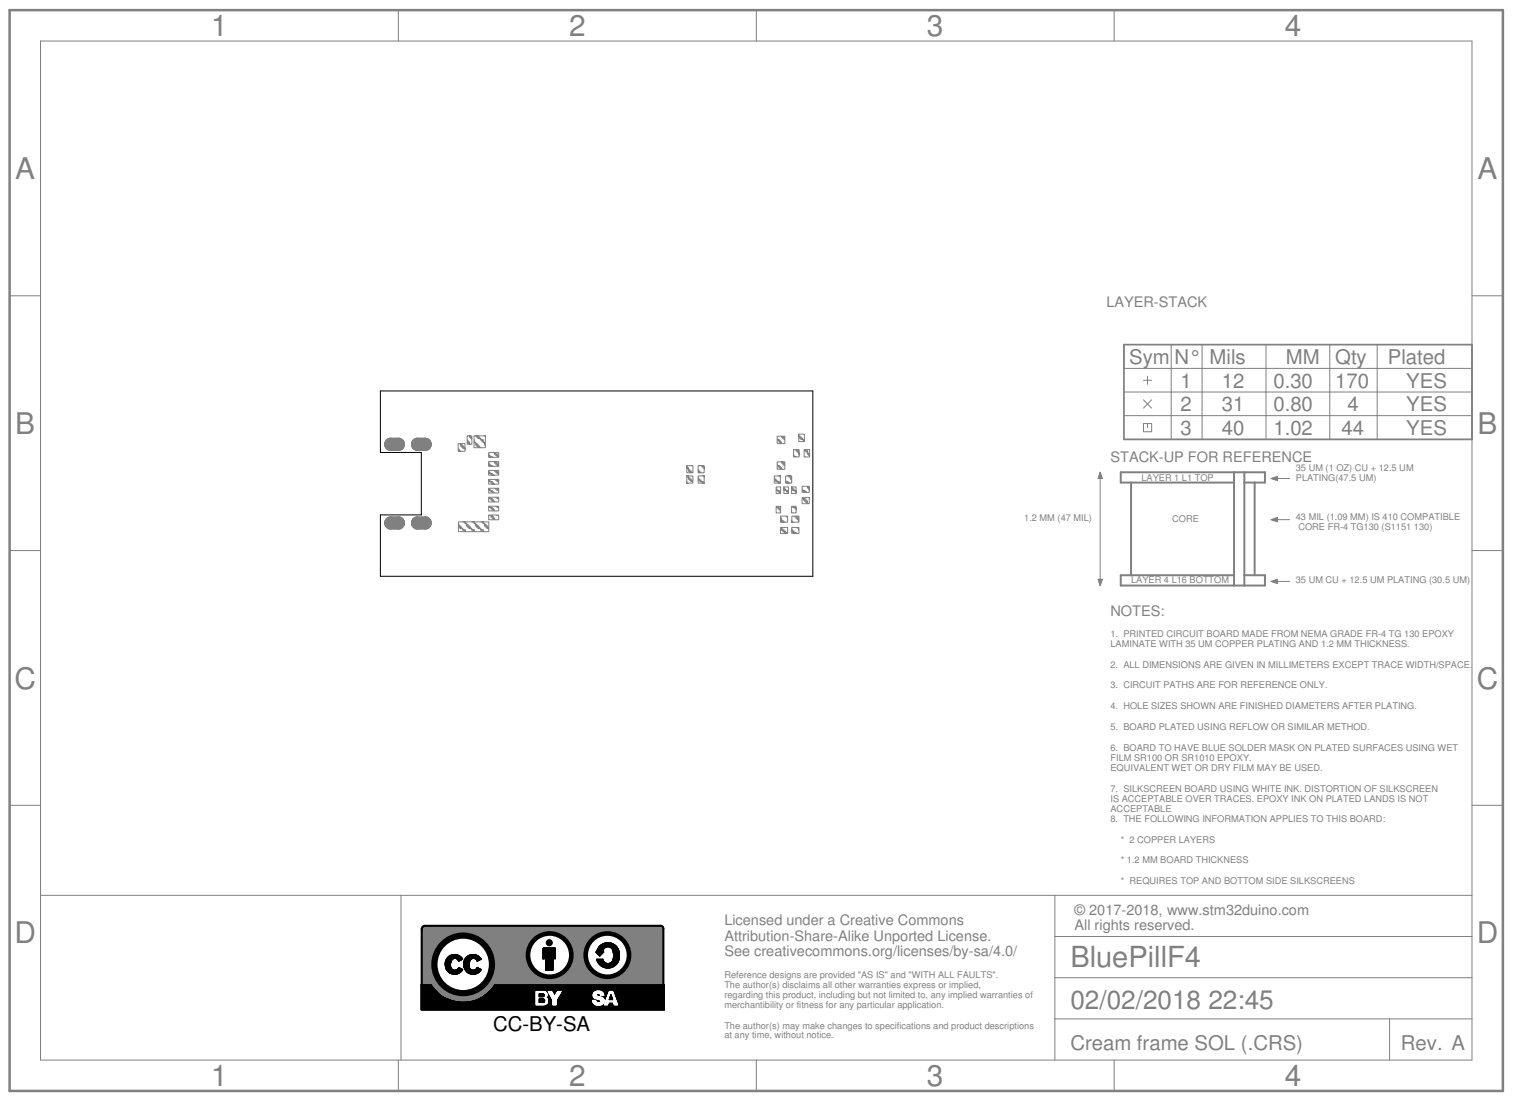
[picture p37: page 9]
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

PLATING(47.5 UM)

35 UM CU + 12.5 UM PLATING (30.5 UM)

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

1. PRINTED CIRCUIT BOARD MADE FROM NEMA GRADE FR-4 TG 130 EPOXY
LAMINATE WITH 35 UM COPPER PLATING AND 1.2 MM THICKNESS.

4. HOLE SIZES SHOWN ARE FINISHED DIAMETERS AFTER PLATING. 5. BOARD PLATED USING REFLOW OR SIMILAR METHOD. 6. BOARD TO HAVE BLUE SOLDER MASK ON PLATED SURFACES USING WET

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

IS ACCEPTABLE OVER TRACES. EPOXY INK ON PLATED LANDS IS NOT ACCEPTABLE

* 2 COPPER LAYERS
* 1.2 MM BOARD THICKNESS
* REQUIRES TOP AND BOTTOM SIDE SILKSCREENS
BluePillF4
Cream frame SOL (.CRS)

All rights reserved. www.stm32duino.com

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

A

A

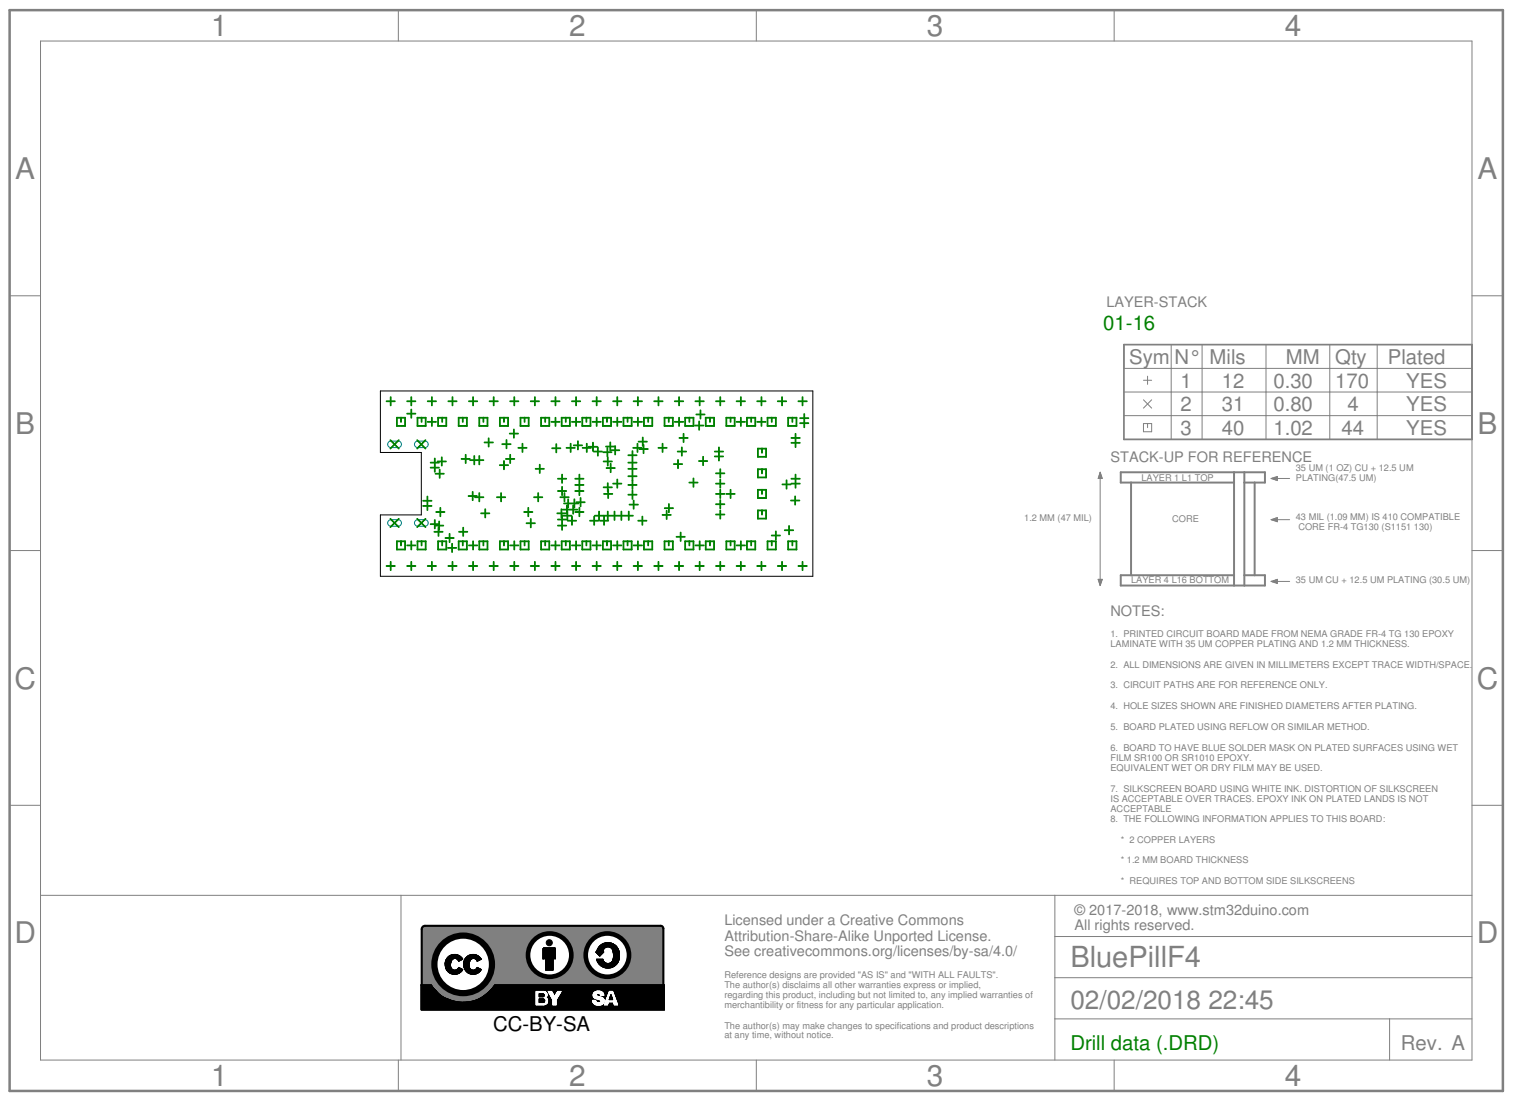
[picture p38: page 10]
LAYER 1 L1 TOP; LAYER 4 L16 BOTTOM; CORE; Rev. A; 1.2 MM (47 MIL); LAYER-STACK 01-16

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

PLATING(47.5 UM)

35 UM CU + 12.5 UM PLATING (30.5 UM)

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

1. PRINTED CIRCUIT BOARD MADE FROM NEMA GRADE FR-4 TG 130 EPOXY
LAMINATE WITH 35 UM COPPER PLATING AND 1.2 MM THICKNESS.

4. HOLE SIZES SHOWN ARE FINISHED DIAMETERS AFTER PLATING. 5. BOARD PLATED USING REFLOW OR SIMILAR METHOD. 6. BOARD TO HAVE BLUE SOLDER MASK ON PLATED SURFACES USING WET

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

IS ACCEPTABLE OVER TRACES. EPOXY INK ON PLATED LANDS IS NOT ACCEPTABLE

* 2 COPPER LAYERS
* 1.2 MM BOARD THICKNESS
* REQUIRES TOP AND BOTTOM SIDE SILKSCREENS
BluePillF4
Drill data (.DRD)

All rights reserved. www.stm32duino.com

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

A

A

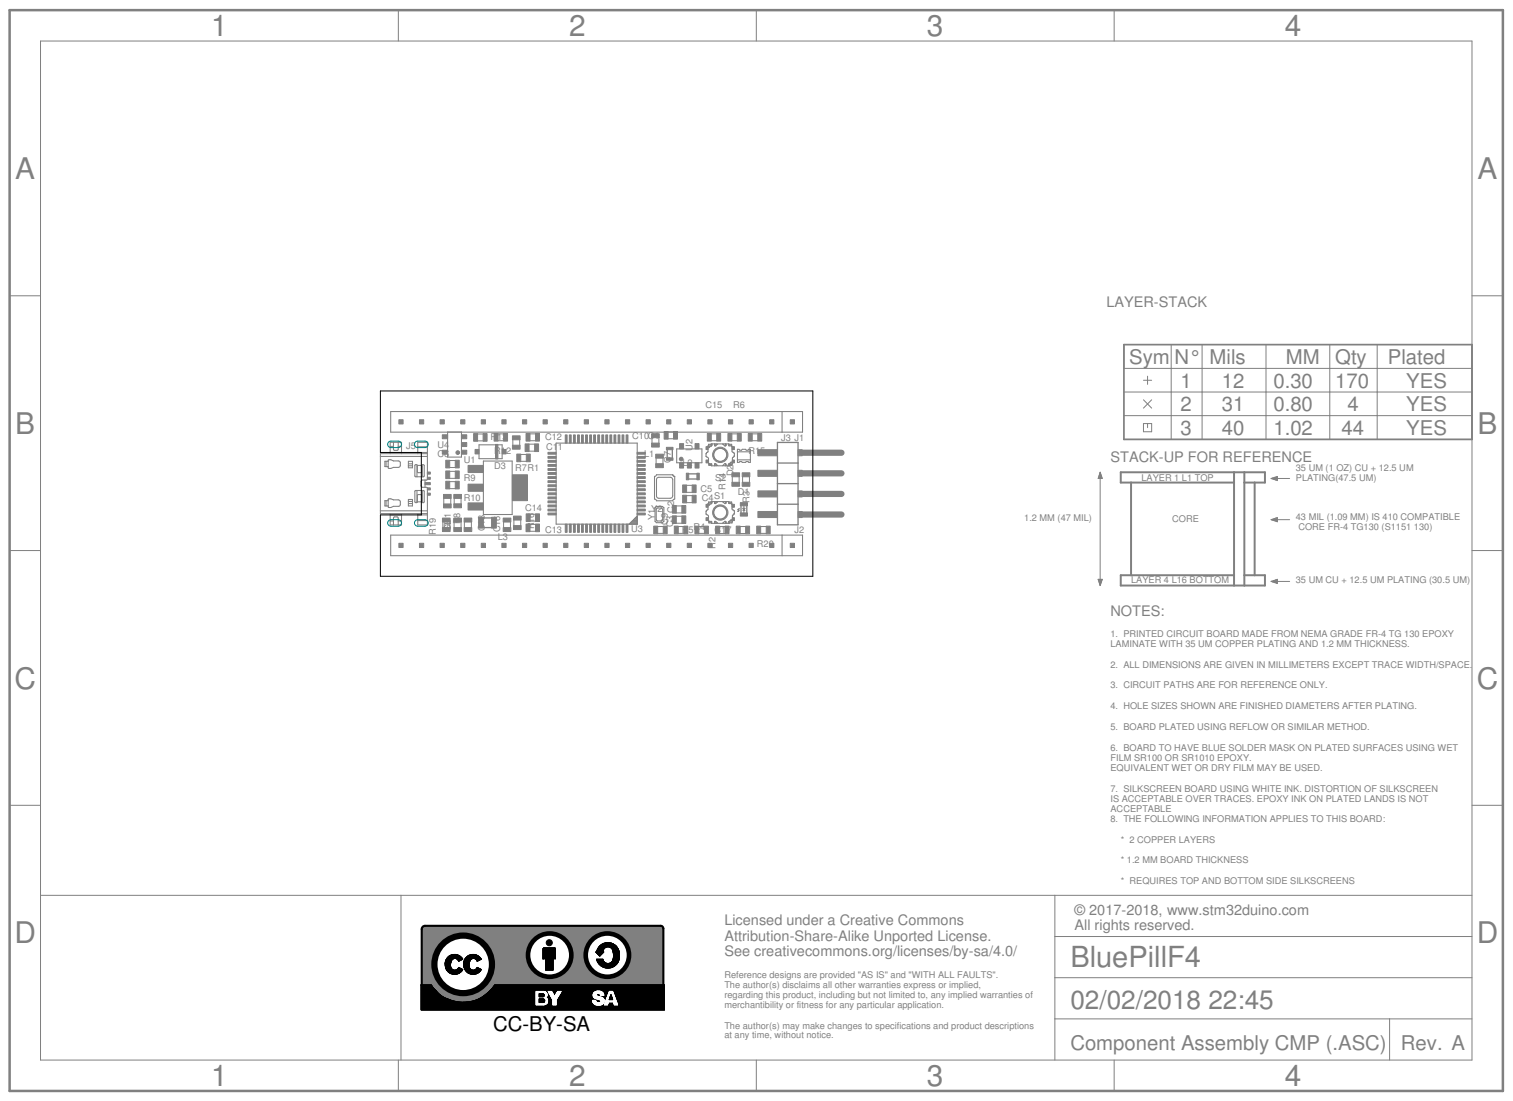
[picture p39: page 11]
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

PLATING(47.5 UM)

35 UM CU + 12.5 UM PLATING (30.5 UM)

1. PRINTED CIRCUIT BOARD MADE FROM NEMA GRADE FR-4 TG 130 EPOXY
LAMINATE WITH 35 UM COPPER PLATING AND 1.2 MM THICKNESS.

4. HOLE SIZES SHOWN ARE FINISHED DIAMETERS AFTER PLATING. 5. BOARD PLATED USING REFLOW OR SIMILAR METHOD. 6. BOARD TO HAVE BLUE SOLDER MASK ON PLATED SURFACES USING WET

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

IS ACCEPTABLE OVER TRACES. EPOXY INK ON PLATED LANDS IS NOT ACCEPTABLE

* 2 COPPER LAYERS
* 1.2 MM BOARD THICKNESS
* REQUIRES TOP AND BOTTOM SIDE SILKSCREENS
BluePillF4
Component Assembly CMP (.ASC)

All rights reserved. www.stm32duino.com

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

A

A

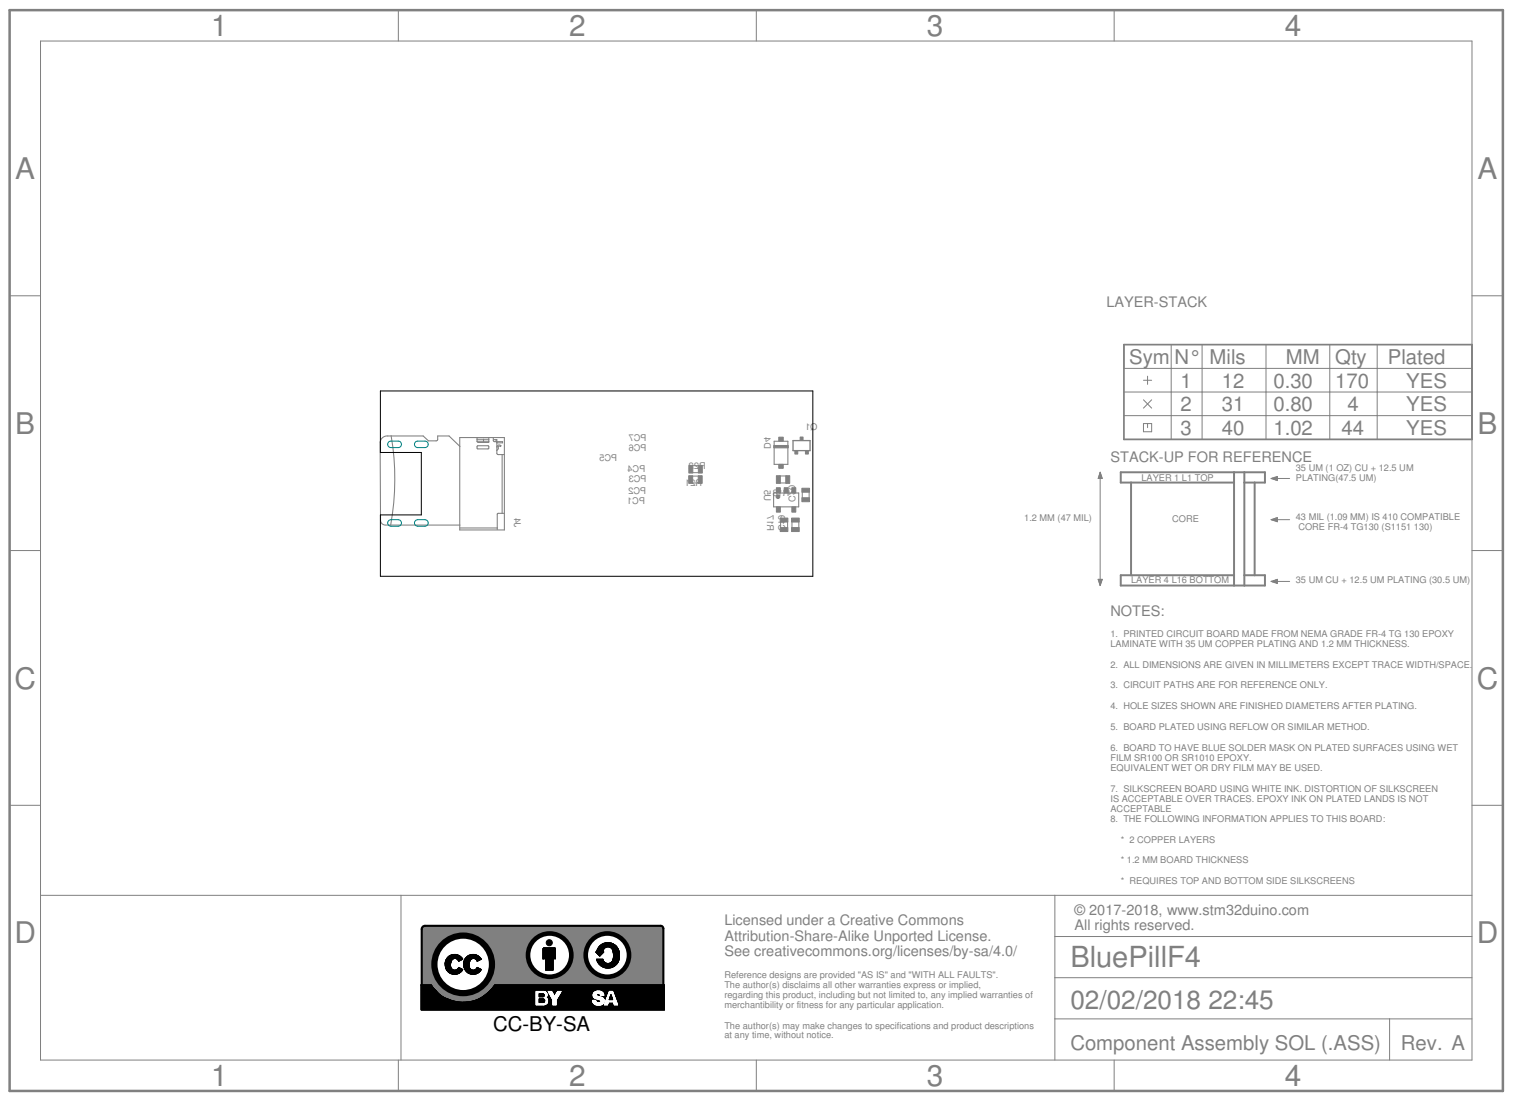
[picture p40: page 12]
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

PLATING(47.5 UM)

35 UM CU + 12.5 UM PLATING (30.5 UM)

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

1. PRINTED CIRCUIT BOARD MADE FROM NEMA GRADE FR-4 TG 130 EPOXY
LAMINATE WITH 35 UM COPPER PLATING AND 1.2 MM THICKNESS.

4. HOLE SIZES SHOWN ARE FINISHED DIAMETERS AFTER PLATING. 5. BOARD PLATED USING REFLOW OR SIMILAR METHOD. 6. BOARD TO HAVE BLUE SOLDER MASK ON PLATED SURFACES USING WET

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

IS ACCEPTABLE OVER TRACES. EPOXY INK ON PLATED LANDS IS NOT ACCEPTABLE

* 2 COPPER LAYERS
* 1.2 MM BOARD THICKNESS
* REQUIRES TOP AND BOTTOM SIDE SILKSCREENS
BluePillF4
Component Assembly SOL (.ASS)

All rights reserved. www.stm32duino.com

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

A

A

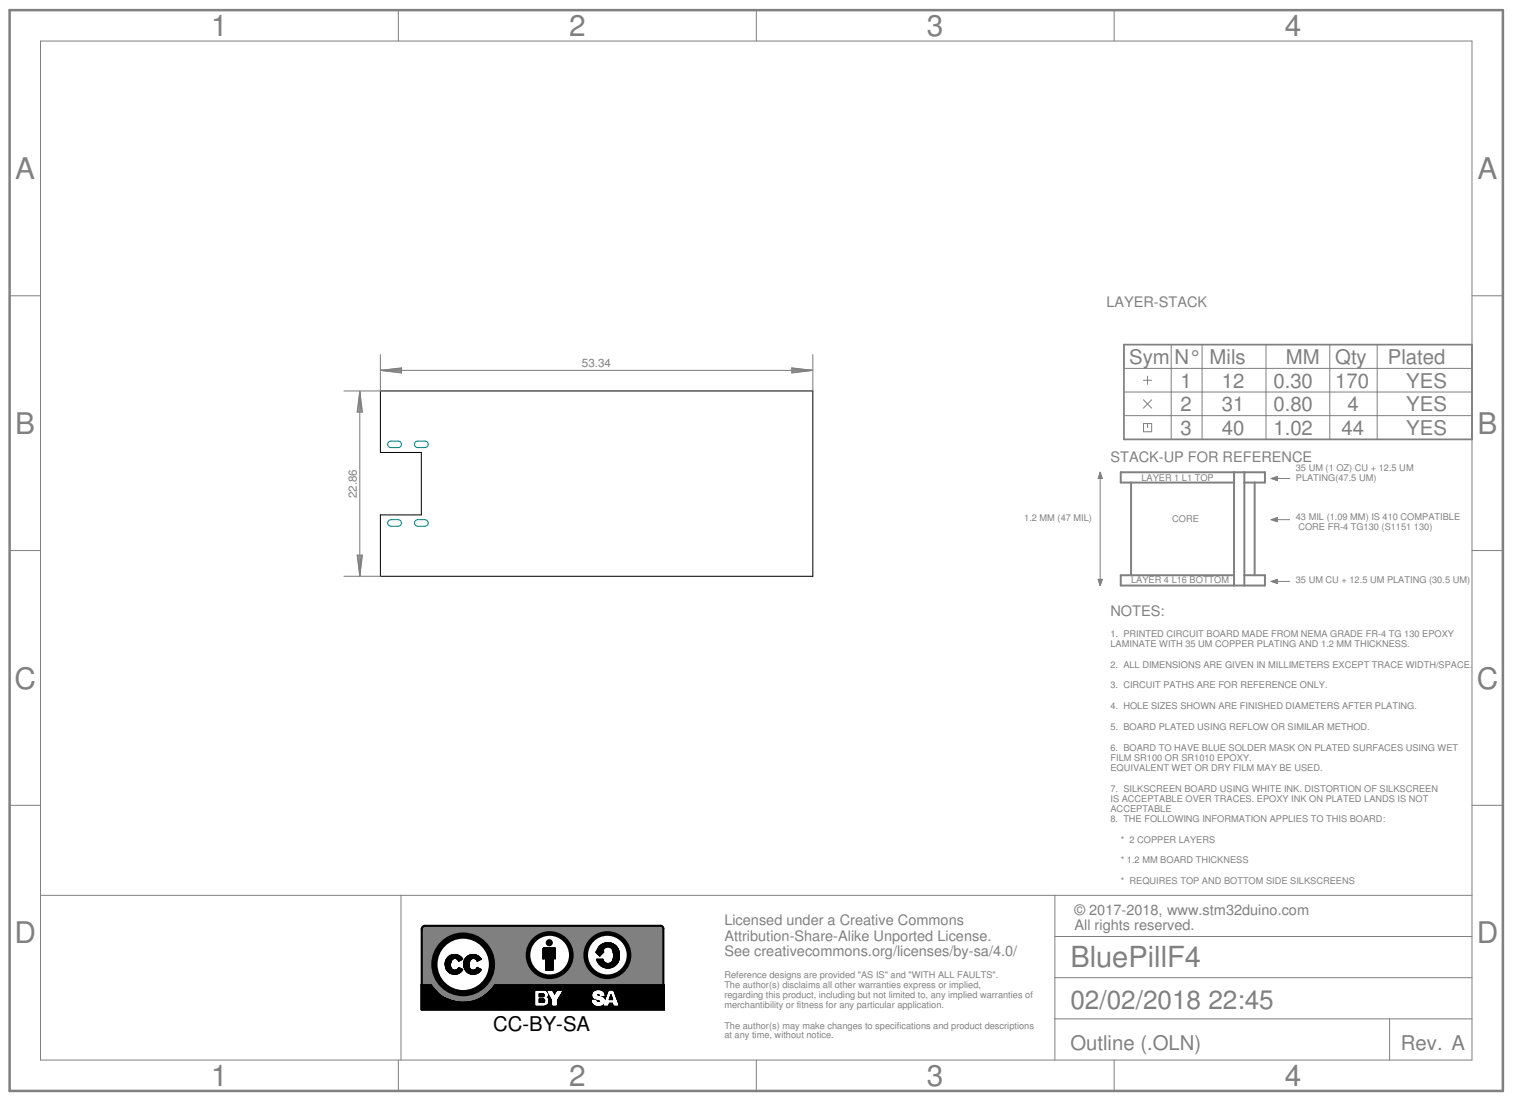
[picture p41: page 13]
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

PLATING(47.5 UM)

35 UM CU + 12.5 UM PLATING (30.5 UM)

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

1. PRINTED CIRCUIT BOARD MADE FROM NEMA GRADE FR-4 TG 130 EPOXY
LAMINATE WITH 35 UM COPPER PLATING AND 1.2 MM THICKNESS.

4. HOLE SIZES SHOWN ARE FINISHED DIAMETERS AFTER PLATING. 5. BOARD PLATED USING REFLOW OR SIMILAR METHOD. 6. BOARD TO HAVE BLUE SOLDER MASK ON PLATED SURFACES USING WET

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

IS ACCEPTABLE OVER TRACES. EPOXY INK ON PLATED LANDS IS NOT ACCEPTABLE

* 2 COPPER LAYERS
* 1.2 MM BOARD THICKNESS
* REQUIRES TOP AND BOTTOM SIDE SILKSCREENS
BluePillF4
Outline (.OLN)

All rights reserved. www.stm32duino.com

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

A

A

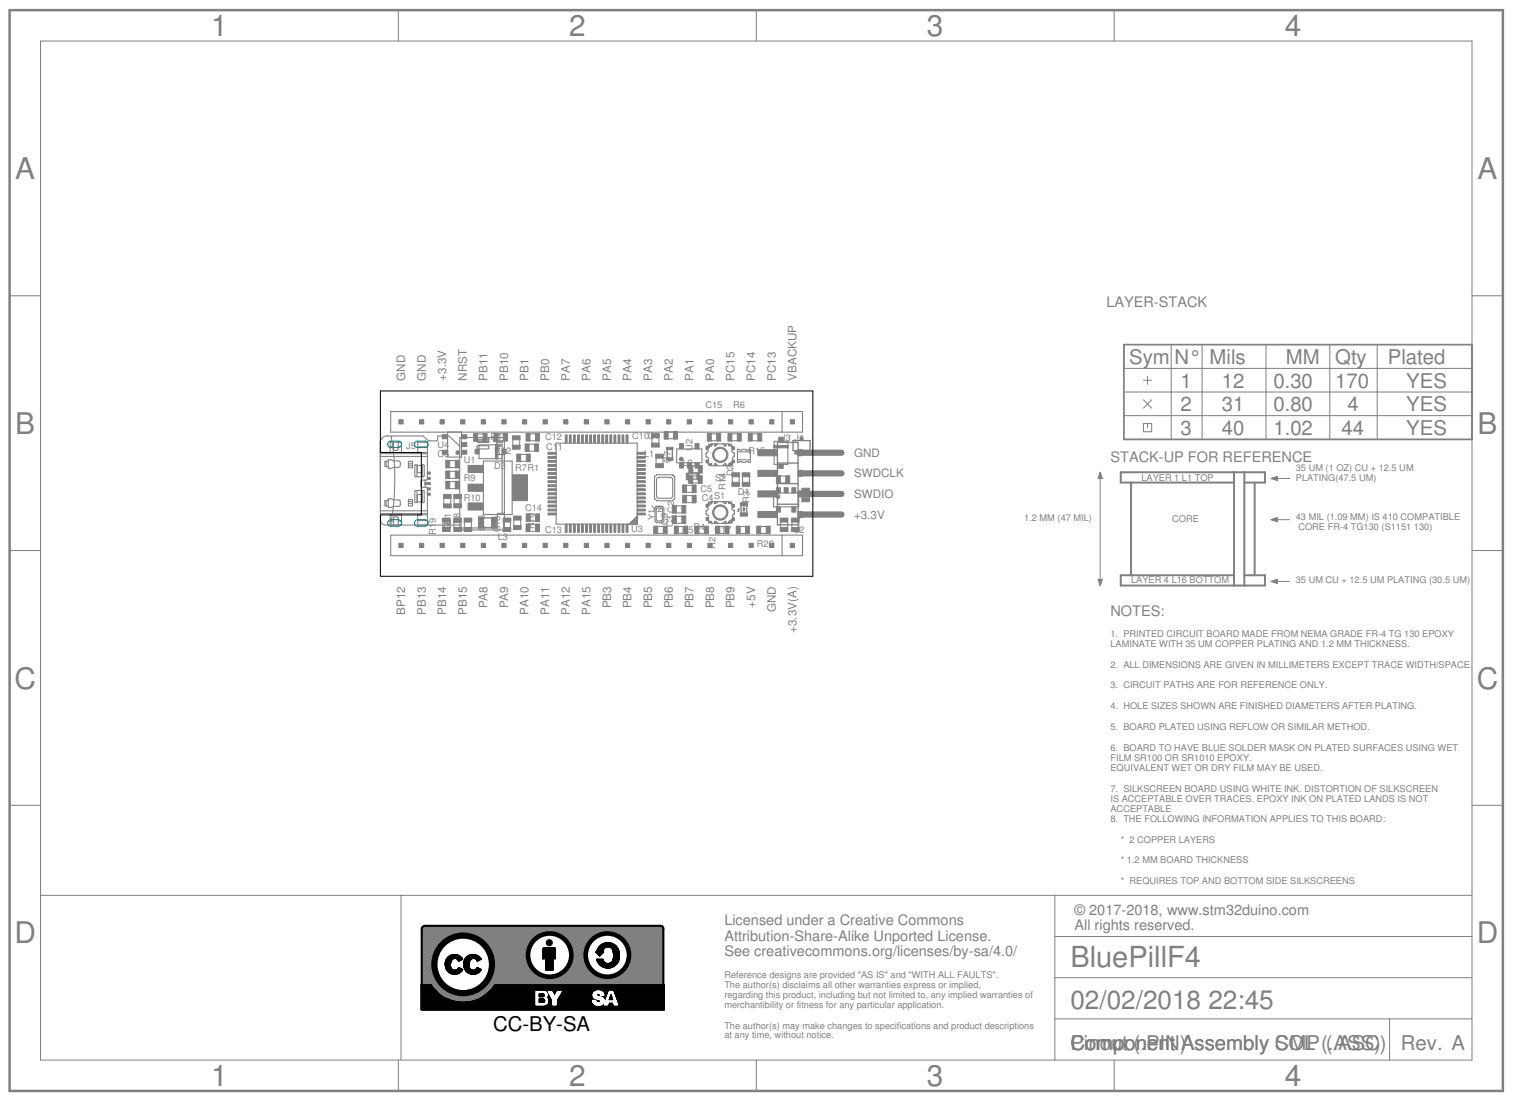
[picture p42: page 14]
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

PLATING(47.5 UM)

35 UM CU + 12.5 UM PLATING (30.5 UM)

1. PRINTED CIRCUIT BOARD MADE FROM NEMA GRADE FR-4 TG 130 EPOXY
LAMINATE WITH 35 UM COPPER PLATING AND 1.2 MM THICKNESS.

4. HOLE SIZES SHOWN ARE FINISHED DIAMETERS AFTER PLATING. 5. BOARD PLATED USING REFLOW OR SIMILAR METHOD. 6. BOARD TO HAVE BLUE SOLDER MASK ON PLATED SURFACES USING WET

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

IS ACCEPTABLE OVER TRACES. EPOXY INK ON PLATED LANDS IS NOT ACCEPTABLE

* 2 COPPER LAYERS
* 1.2 MM BOARD THICKNESS
* REQUIRES TOP AND BOTTOM SIDE SILKSCREENS
BluePillF4
Component Assembly SCOMLP((..AASSSC))

All rights reserved. www.stm32duino.com

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
