rogerclarkmelbourne/STM32_Pill_Boards/BluepillF4/BluepillF4_Schematics.pdf

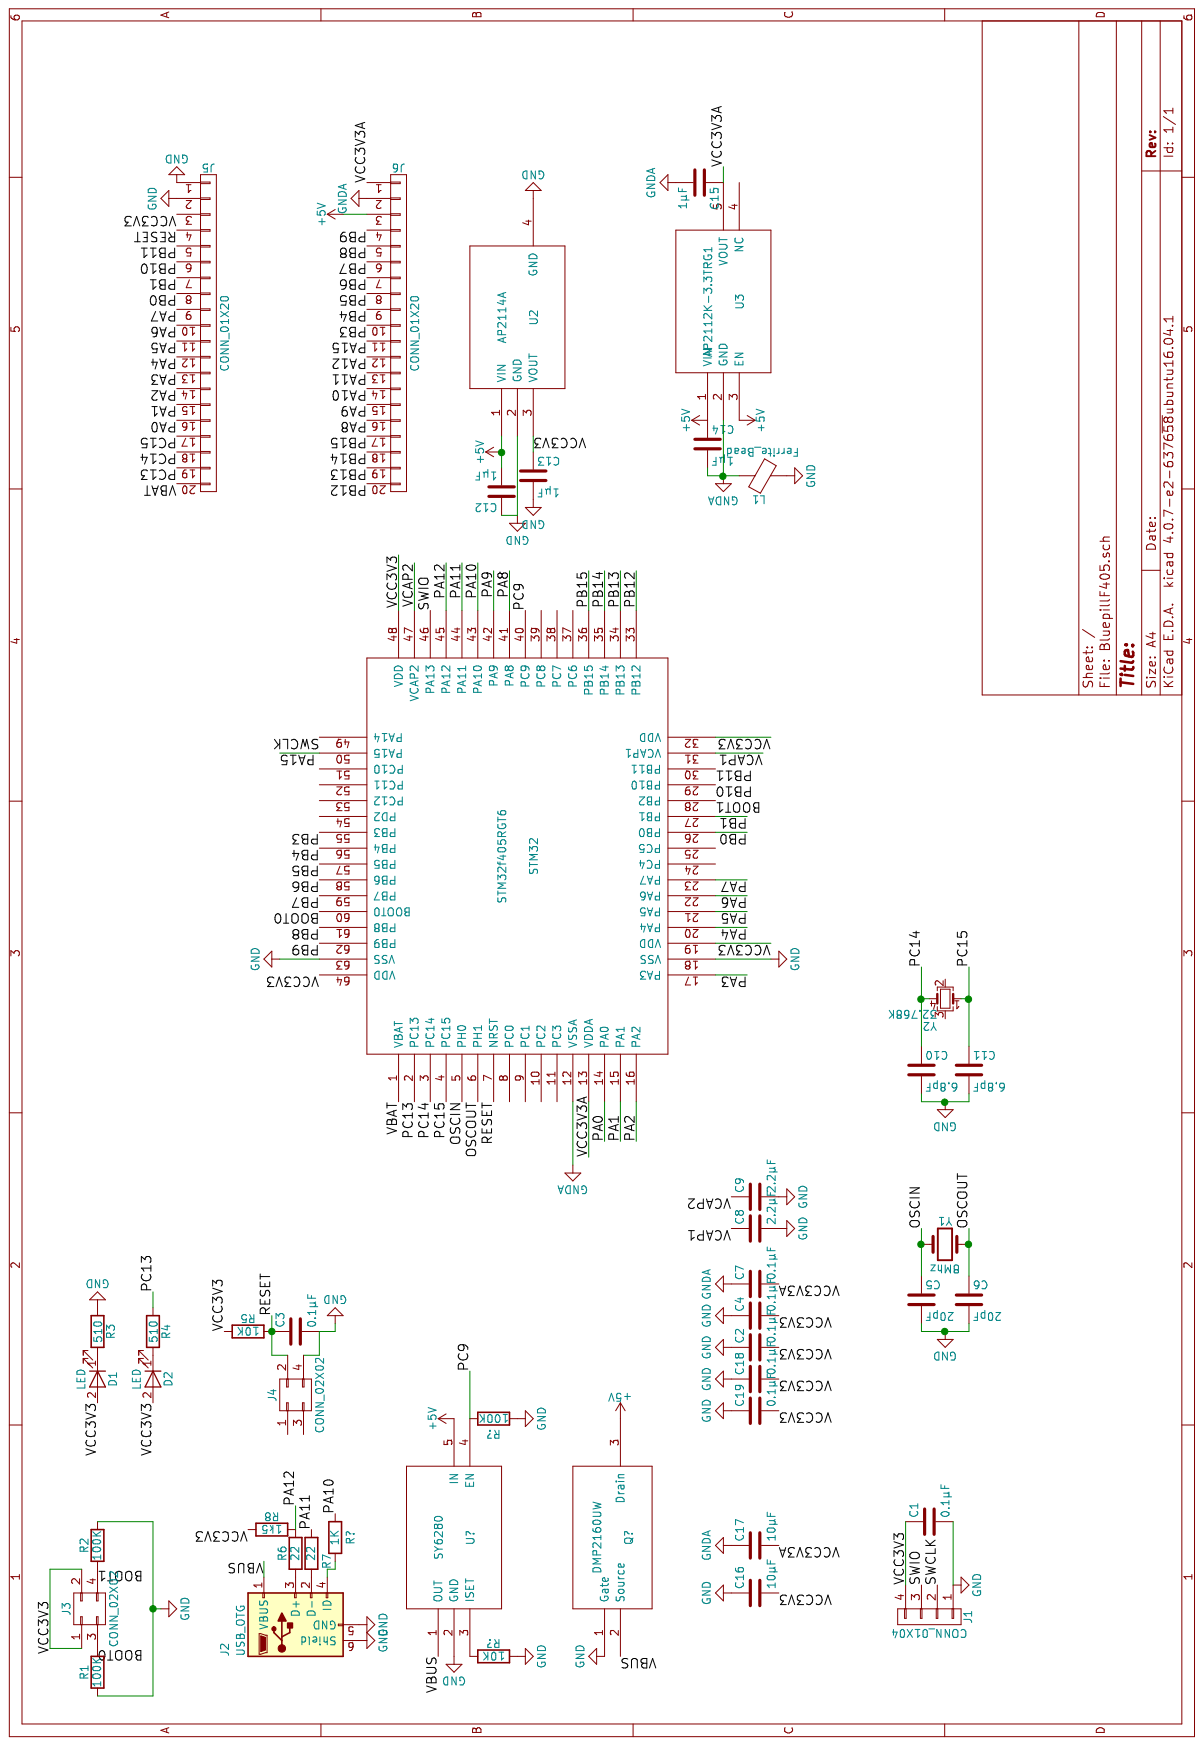
[picture p43: page 1]
