rogerclarkmelbourne/STM32_Pill_Boards/STM32F4Stamp/Print F405Pill-brd.pdf

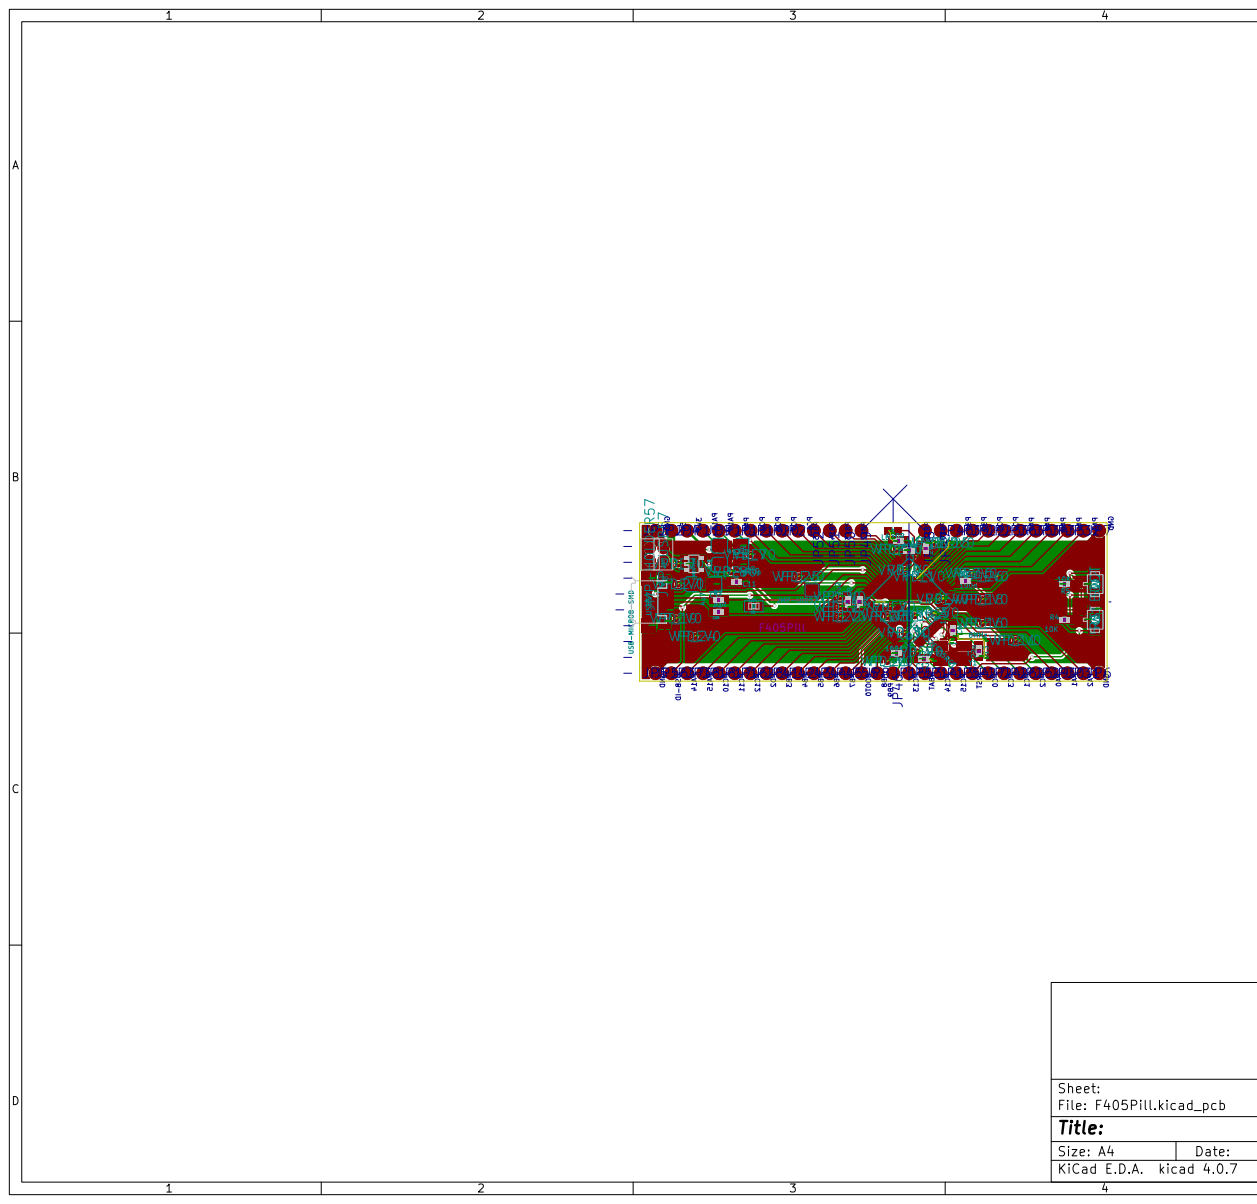
[picture p44: page 1]
