rogerclarkmelbourne/STM32_Pill_Boards/Squonk42/KiCAD/STM32 F4 Assembly Bottom.pdf

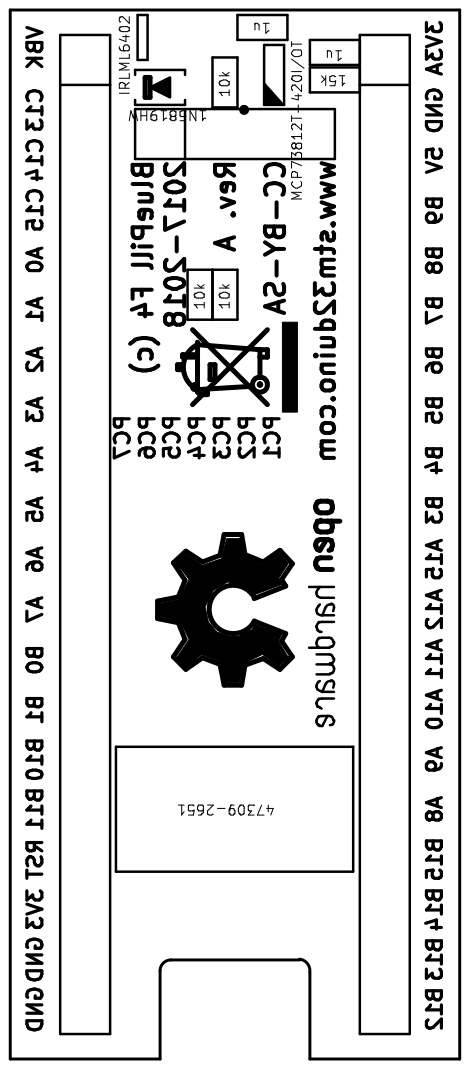
[picture p45: page 1]
