rogerclarkmelbourne/STM32_Pill_Boards/Squonk42/KiCAD/STM32 F4 Assembly Top.pdf

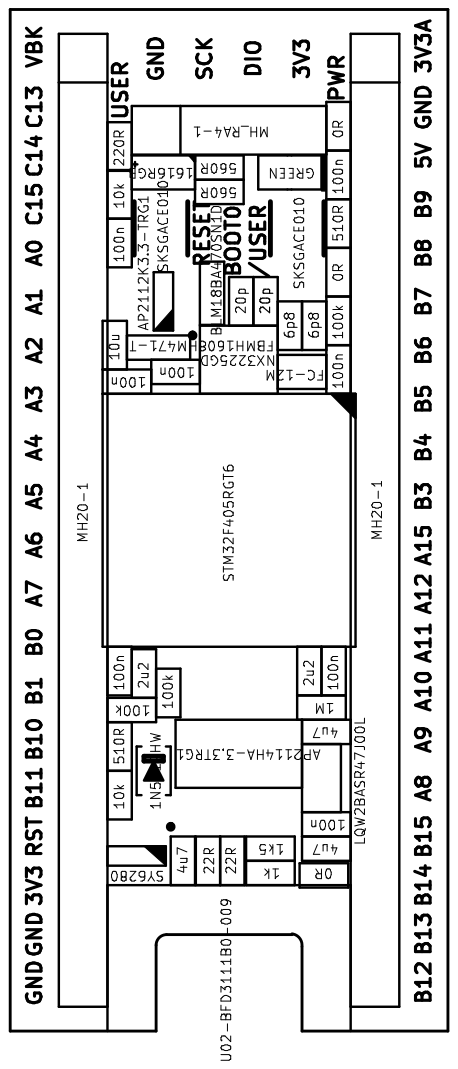
[picture p46: page 1]
