rogerclarkmelbourne/STM32_Pill_Boards/Squonk42/KiCAD/BluePill F4 Schematic.pdf

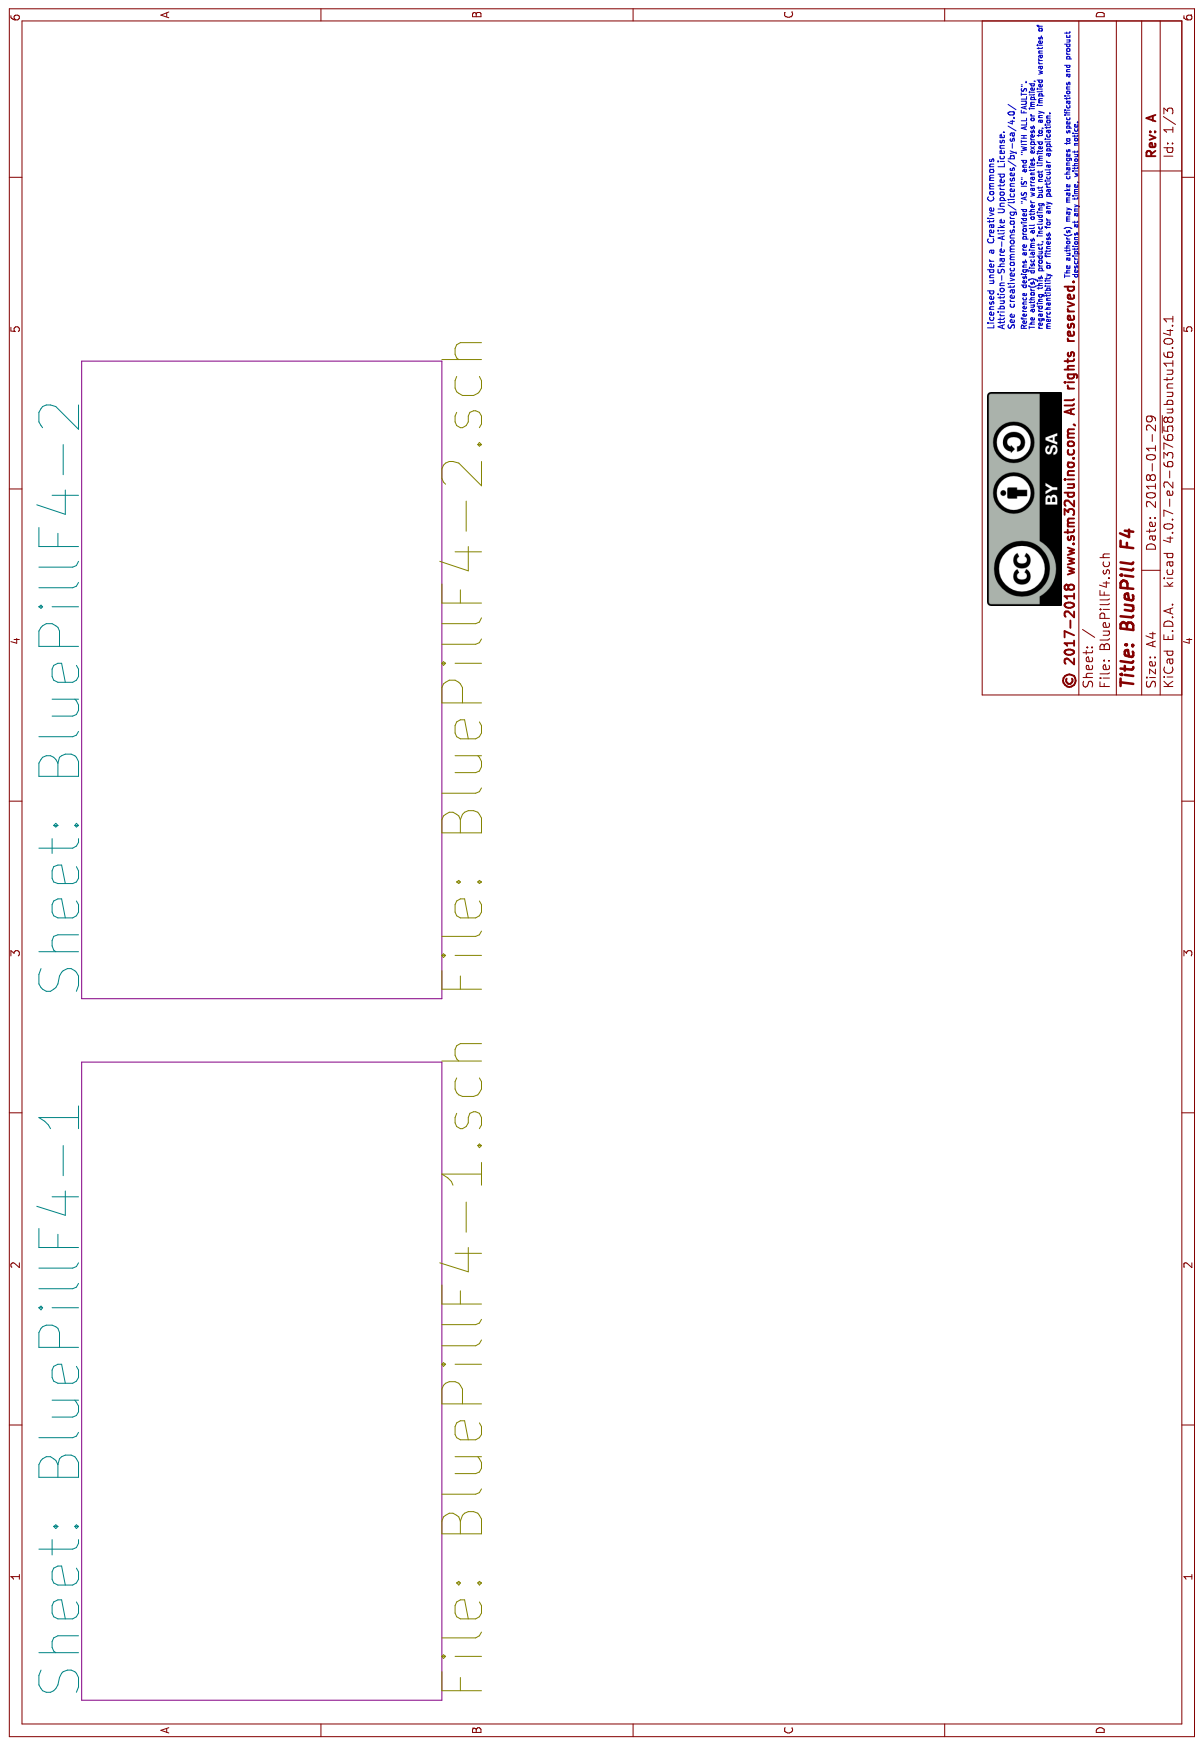
[picture p47: page 1]

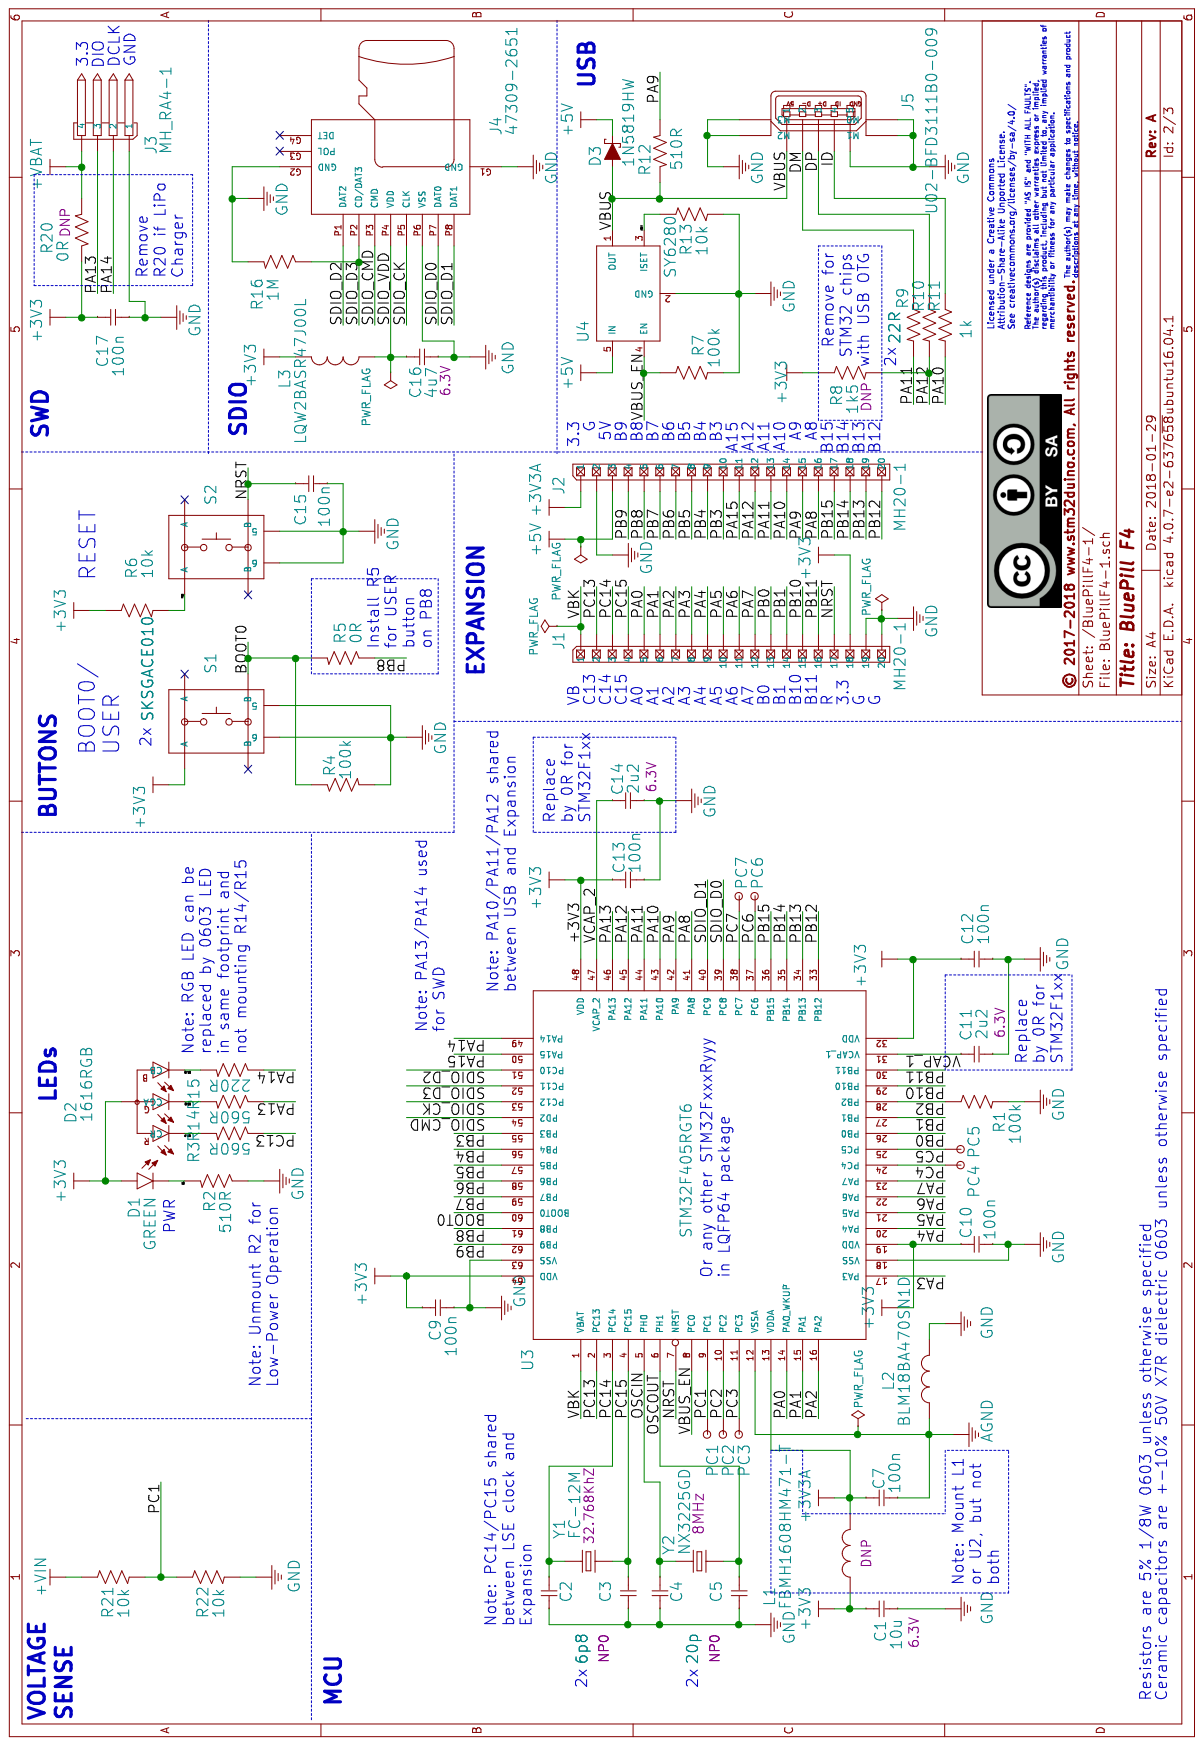
[picture p48: page 2]

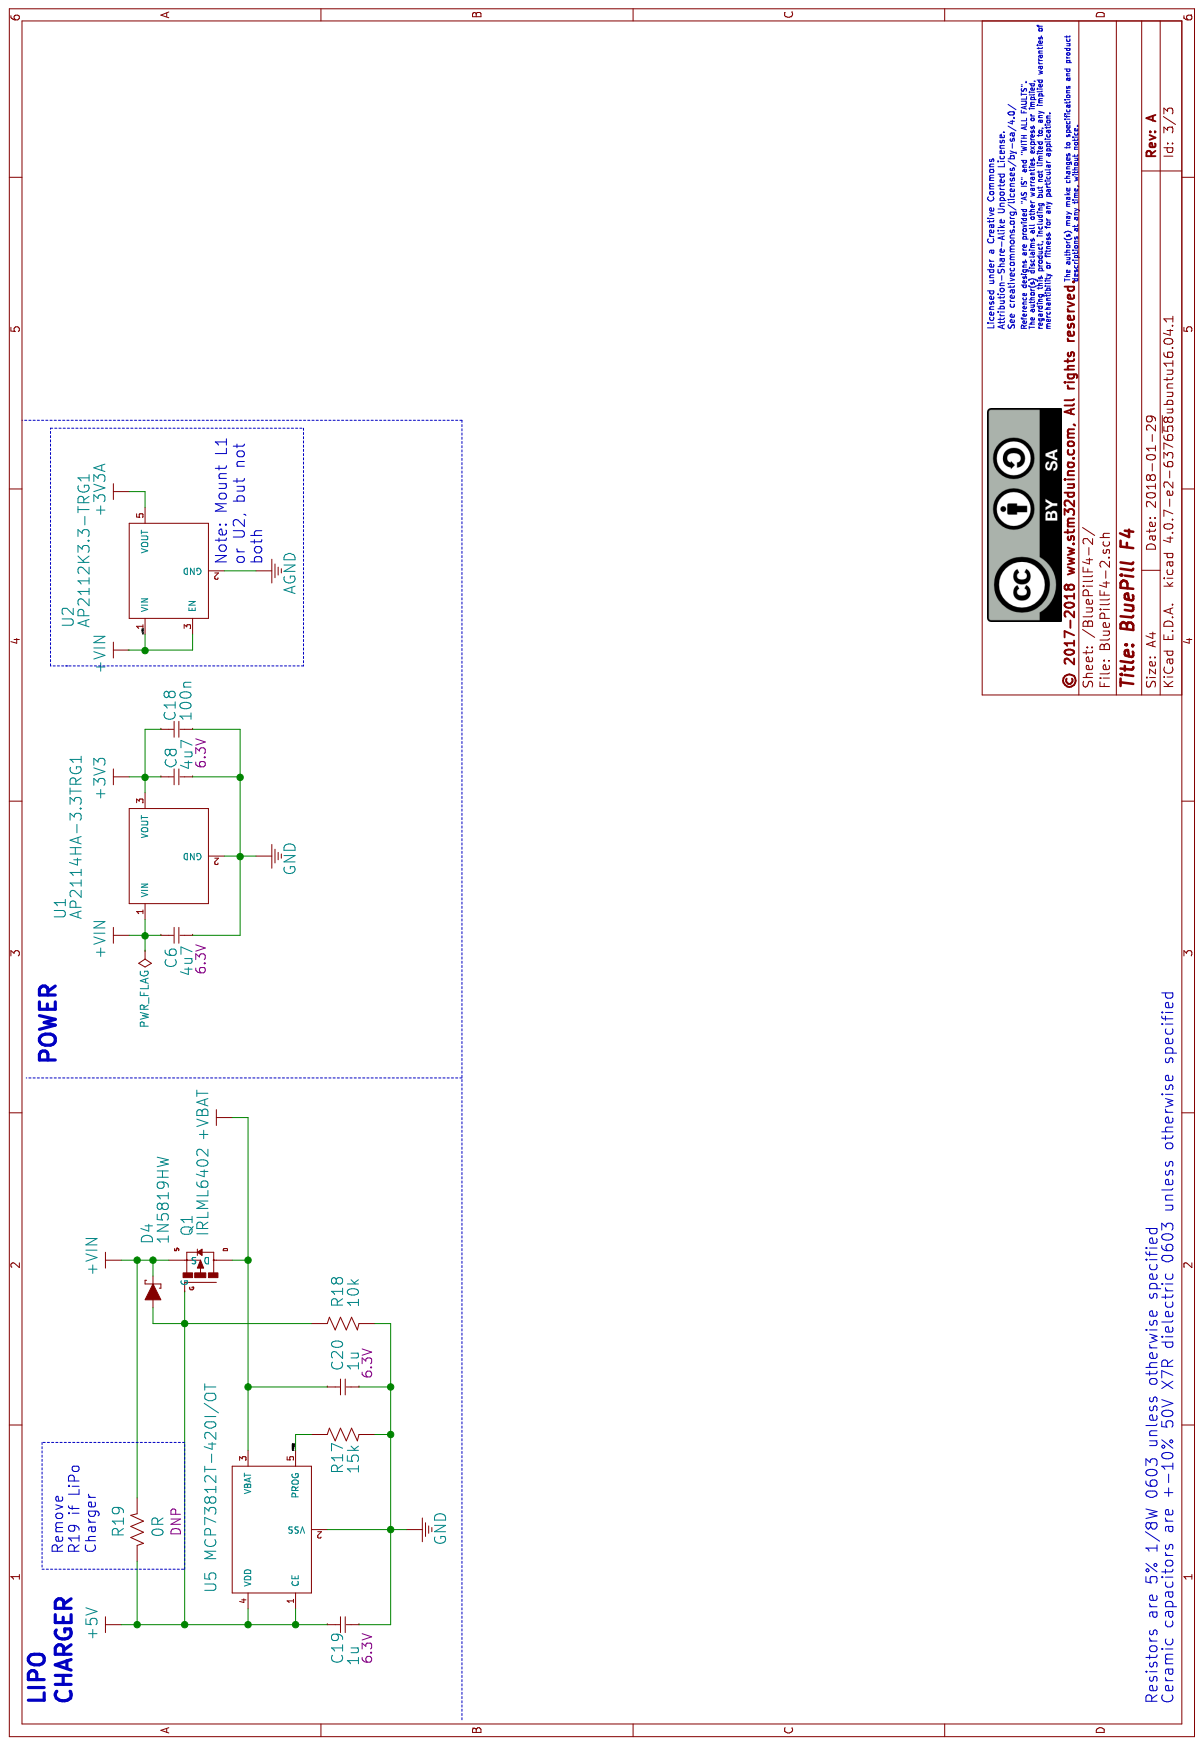
[picture p49: page 3]
