rogerclarkmelbourne/STM32_Pill_Boards/BluepillF4/BluepillF4_PCB_Bottom.pdf

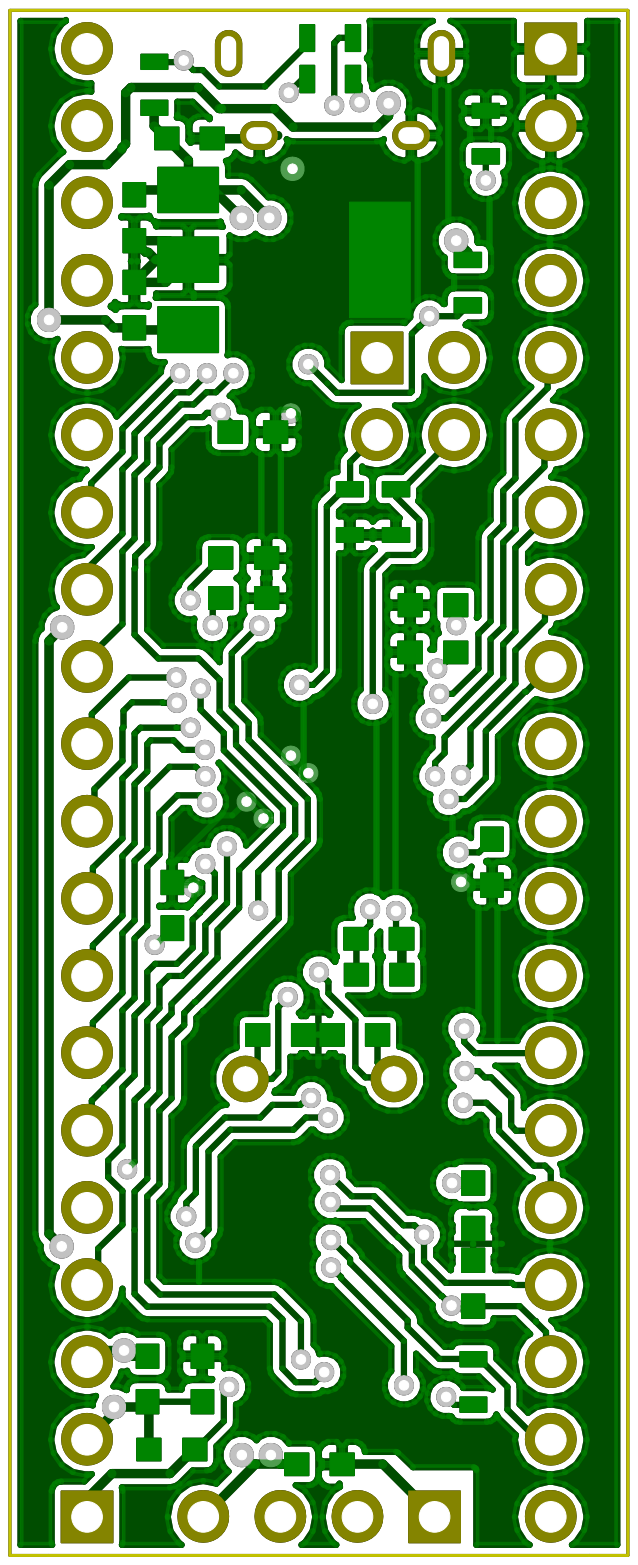
[picture p50: page 1]
