rogerclarkmelbourne/STM32_Pill_Boards/BluepillF4/BluepillF4_PCB_Top.pdf

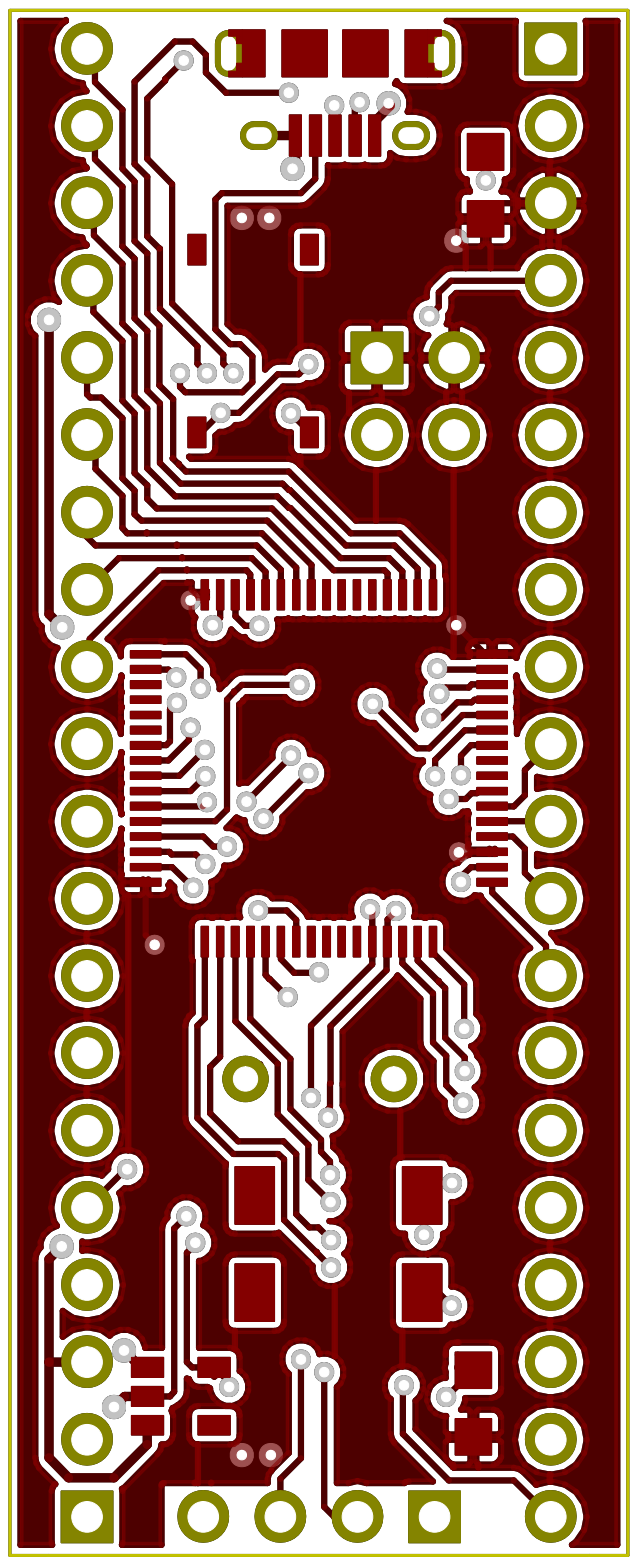
[picture p51: page 1]
