rogerclarkmelbourne/STM32_Pill_Boards/STM32F4Stamp/F405Pill.pdf

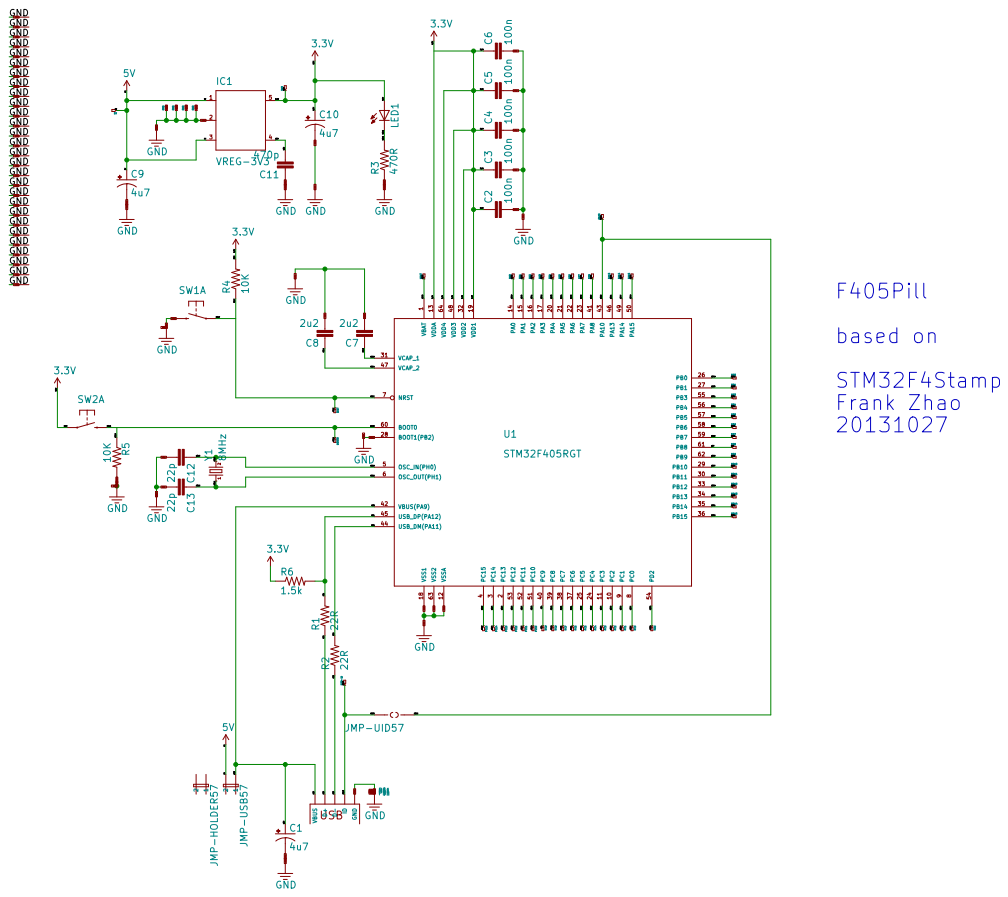
[picture p52: page 1]
