rogerclarkmelbourne/STM32_Pill_Boards/Squonk42/KiCAD/BluePillF4.kicad_pcb

## KiCad design Squonk42/KiCAD/BluePillF4.kicad_pcb (2018-09-01)

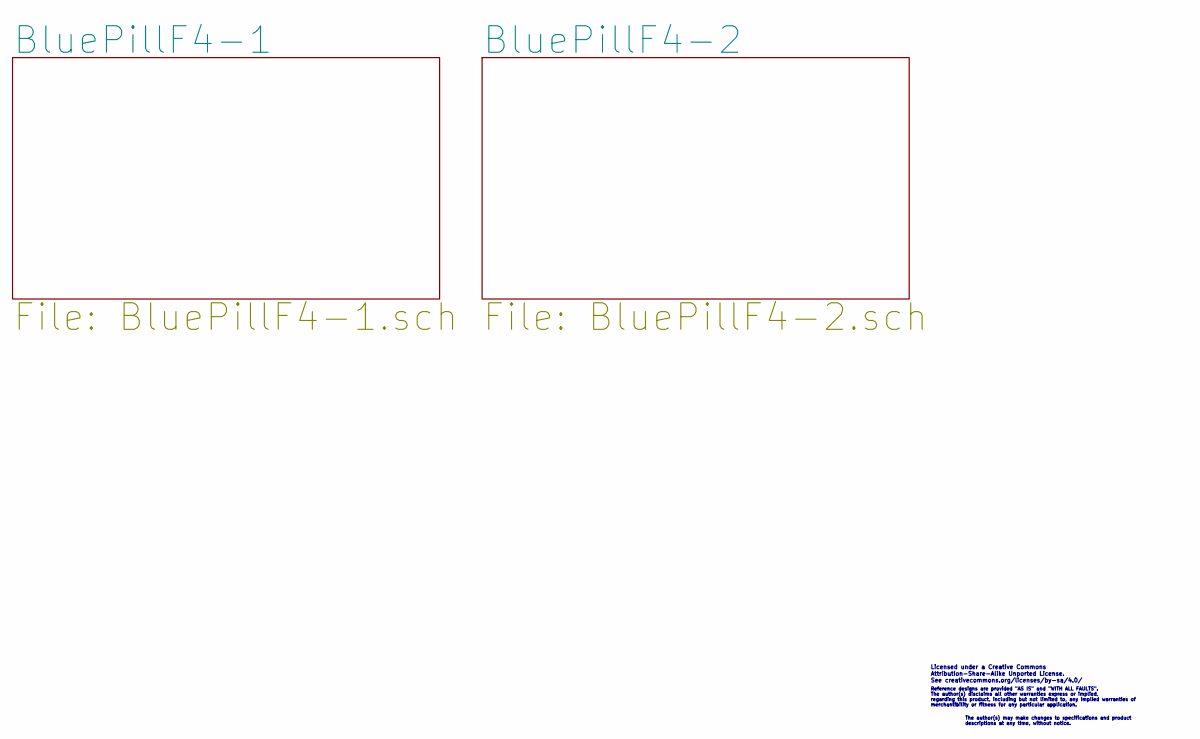
[picture p53: schematic BluePillF4.sch, BluePill F4]

Notes on the sheet:
Licensed under a Creative Commons Attribution-Share-Alike Unported License. See creativecommons.org/licenses/by-sa/4.0/
Reference designs are provided "AS IS" and "WITH ALL FAULTS".
The author(s) disclaims all other warranties express or implied,
regarding this product, including but not limited to, any implied warranties of
merchantibility or fitness for any particular application.
The author(s) may make changes to specifications and product
descriptions at any time, without notice.

Schematic: BluePillF4-1.sch, BluePill F4

Parts:
C1: 10u; C0603; PARTNO C0603_10u_X7R_10%_CER_6V3
C2, C3: 6p8; C0603; PARTNO C0603_6p8_NP0_5%_CER_50V
C4, C5: 20p; C0603; PARTNO C0603_20p_NP0_5%_CER_50V
C7, C9, C10, C12, C13, C15, C17: 100n; C0603; PARTNO C0603_100n_X7R_10%_CER_50V
C11, C14: 2u2; C0603; PARTNO C0603_2u2_X7R_10%_CER_6V3
C16: 4u7; C0603; PARTNO C0603_4u7_X7R_10%_CER_6V3
D1: GREEN; LED0603; PARTNO LED0603-GREEN
D2: 1616RGB; PARTNO LED1616-RGB
D3: 1N5819HW; SOD-123; PARTNO 1N5819HW
J1, J2: MH20-1; MH20-1-0.1; PARTNO MH20-1-0.1
J3: MH_RA4-1; MH_RA4-1-0.1; PARTNO MH_RA4-1-0.1
J4: 47309-2651; PARTNO 47309-2651
J5: U02-BFD3111B0-009; PARTNO U02-BFD3111B0-009
L1: FBMH1608HM471-T; FB0603; PARTNO FBMH1608HM471-T
L2: BLM18BA470SN1D; FB0603; PARTNO BLM18BA470SN1D
L3: LQW2BASR47J00L; FB0805; PARTNO LQW2BASR47J00L
PC1, PC2, PC3, PC4, PC5, PC6, PC7: TEST_PAD
R1, R4, R7: 100k; R0603; PARTNO R0603_100k_5%_125mW
R2, R12: 510R; R0603; PARTNO R0603_510R_5%_125mW
R3, R14: 560R; R0603; PARTNO R0603_510R_5%_125mW
R5, R20: 0R; R0603; PARTNO R0603_510R_5%_125mW
R8: 1k5; R0603; PARTNO R0603_1k5_5%_125mW
R9, R10: 22R; R0603; PARTNO R0603_22R_5%_125mW
R11: 1k; R0603; PARTNO R0603_1k_5%_125mW
R13: 10k; R0603; PARTNO R0603_10k_5%_125mW
R15: 220R; R0603; PARTNO R0603_510R_5%_125mW
R16: 1M; R0603; PARTNO R0603_1M_5%_125mW
R21, R22: 10k; R0603; PARTNO R0603_10k_1%_125mW
S1, S2: SKSGACE010; PARTNO SKSGACE010
U3: STM32F405RGT6; LQFP64; PARTNO STM32F405RGT6
U4: SY6280; SOT23-5; PARTNO SY6280AAC
Y1: FC-12M; PARTNO FC-12M 32.7680KA-A3
Y2: NX3225GD; CRYSTAL_32X25_2P; PARTNO NX3225GD-8MHZ-STD-CRA-3

Connections:
+3V3: C1.1, C9.2, C10.2, C12.1, C13.1, C17.2, D1.2, D2.4, J1.18, L1.1, L3.2, R8.1, R20.1, S1.3, U3.19 (VDD), U3.32 (VDD), U3.48 (VDD), U3.64 (VDD); also elsewhere on the board
+3V3A: C7.2, J2.1, L1.2, U3.13 (VDDA); also elsewhere on the board
+5V: D3.C, J2.3, U4.5; also elsewhere on the board
+VBAT: J3.4, R20.2; also elsewhere on the board
+VIN: R21.1; also elsewhere on the board
/BluePillF4-1/BOOT0: R4.1, R5.2, S1.2, U3.60 (BOOT0)
/BluePillF4-1/D1: D1.1, R2.2
/BluePillF4-1/D2_B: D2.3, R15.2
/BluePillF4-1/D2_G: D2.2, R14.2
/BluePillF4-1/D2_R: D2.1, R3.2
/BluePillF4-1/DM: J5.2, R9.1
/BluePillF4-1/DP: J5.3, R10.1
/BluePillF4-1/ID: J5.4, R11.1
/BluePillF4-1/ISET: R13.1, U4.3
/BluePillF4-1/NRST: C15.2, J1.17, S2.2, U3.7 (NRST)
/BluePillF4-1/OSCIN: C4.1, U3.5 (PH0), Y2.2
/BluePillF4-1/OSCOUT: C5.1, U3.6 (PH1), Y2.1
/BluePillF4-1/PA0: J1.5, U3.14 (PA0_WKUP)
/BluePillF4-1/PA1: J1.6, U3.15 (PA1)
/BluePillF4-1/PA2: J1.7, U3.16 (PA2)
/BluePillF4-1/PA3: J1.8, U3.17 (PA3)
/BluePillF4-1/PA4: J1.9, U3.20 (PA4)
/BluePillF4-1/PA5: J1.10, U3.21 (PA5)
/BluePillF4-1/PA6: J1.11, U3.22 (PA6)
/BluePillF4-1/PA7: J1.12, U3.23 (PA7)
/BluePillF4-1/PA8: J2.16, U3.41 (PA8)
/BluePillF4-1/PA9: J2.15, R12.2, U3.42 (PA9)
/BluePillF4-1/PA10: J2.14, R11.2, U3.43 (PA10)
/BluePillF4-1/PA11: J2.13, R9.2, U3.44 (PA11)
/BluePillF4-1/PA12: J2.12, R8.2, R10.2, U3.45 (PA12)
/BluePillF4-1/PA13: J3.3, R14.1, U3.46 (PA13)
/BluePillF4-1/PA14: J3.2, R15.1, U3.49 (PA14)
/BluePillF4-1/PA15: J2.11, U3.50 (PA15)
/BluePillF4-1/PB0: J1.13, U3.26 (PB0)
/BluePillF4-1/PB1: J1.14, U3.27 (PB1)
/BluePillF4-1/PB2: R1.1, U3.28 (PB2)
/BluePillF4-1/PB3: J2.10, U3.55 (PB3)
/BluePillF4-1/PB4: J2.9, U3.56 (PB4)
/BluePillF4-1/PB5: J2.8, U3.57 (PB5)
/BluePillF4-1/PB6: J2.7, U3.58 (PB6)
/BluePillF4-1/PB7: J2.6, U3.59 (PB7)
/BluePillF4-1/PB8: J2.5, R5.1, U3.61 (PB8)
/BluePillF4-1/PB9: J2.4, U3.62 (PB9)
/BluePillF4-1/PB10: J1.15, U3.29 (PB10)
/BluePillF4-1/PB11: J1.16, U3.30 (PB11)
/BluePillF4-1/PB12: J2.20, U3.33 (PB12)
/BluePillF4-1/PB13: J2.19, U3.34 (PB13)
/BluePillF4-1/PB14: J2.18, U3.35 (PB14)
/BluePillF4-1/PB15: J2.17, U3.36 (PB15)
/BluePillF4-1/PC1: PC1.1, R21.2, R22.1, U3.9 (PC1)
/BluePillF4-1/PC2: PC2.1, U3.10 (PC2)
/BluePillF4-1/PC3: PC3.1, U3.11 (PC3)
/BluePillF4-1/PC4: PC4.1, U3.24 (PC4)
/BluePillF4-1/PC5: PC5.1, U3.25 (PC5)
/BluePillF4-1/PC6: PC6.1, U3.37 (PC6)
/BluePillF4-1/PC7: PC7.1, U3.38 (PC7)
/BluePillF4-1/PC13: J1.2, R3.1, U3.2 (PC13)
/BluePillF4-1/PC14: C2.1, J1.3, U3.3 (PC14), Y1.1
/BluePillF4-1/PC15: C3.1, J1.4, U3.4 (PC15), Y1.2
/BluePillF4-1/R6: S2.3; also elsewhere on the board
/BluePillF4-1/SDIO_CK: J4.P5 (CLK), U3.53 (PC12)
/BluePillF4-1/SDIO_CMD: J4.P3 (CMD), U3.54 (PD2)
/BluePillF4-1/SDIO_D0: J4.P7 (DAT0), U3.39 (PC8)
/BluePillF4-1/SDIO_D1: J4.P8 (DAT1), U3.40 (PC9)
/BluePillF4-1/SDIO_D2: J4.P1 (DAT2), U3.51 (PC10)
/BluePillF4-1/SDIO_D3: J4.P2 (CD/DAT3), R16.1, U3.52 (PC11)
/BluePillF4-1/SDIO_VDD: C16.2, J4.P4 (VDD), L3.1
/BluePillF4-1/VBK: J1.1, U3.1 (VBAT)
/BluePillF4-1/VBUS: D3.A, J5.1, R12.1, U4.1
/BluePillF4-1/VBUS_EN: R7.1, U3.8 (PC0), U4.4
/BluePillF4-1/VCAP_1: C11.2, U3.31 (VCAP_1)
/BluePillF4-1/VCAP_2: C14.2, U3.47 (VCAP_2)
AGND: C7.1, L2.1, U3.12 (VSSA); also elsewhere on the board

Notes on the sheet:
Reference designs are provided "AS IS" and "WITH ALL FAULTS".
regarding this product, including but not limited to, any implied warranties of
The author(s) may make changes to specifications and product
The author(s) disclaims all other warranties express or implied,
merchantibility or fitness for any particular application.
descriptions at any time, without notice.
Ceramic capacitors are +-10% 50V X7R dielectric 0603 unless otherwise specified
Resistors are 5% 1/8W 0603 unless otherwise specified
Remove for STM32 chips with USB OTG
Replace by 0R for STM32F1xx
RESET
BOOT0/ USER
SWD
USB
LEDs
Install R5 for USER button on PB8
PWR
SDIO
BUTTONS
EXPANSION
MCU
Note: PC14/PC15 shared between LSE clock and Expansion
Note: PA10/PA11/PA12 shared between USB and Expansion
Note: PA13/PA14 used for SWD
DIO
DCLK
3.3
GND
C13
C14
C15
B10
B11
A15
A12
A11
A10
B15
B14
B13
B12
Or any other STM32FxxxRyyy in LQFP64 package
Note: Mount L1 or U2, but not both
Licensed under a Creative Commons Attribution-Share-Alike Unported License. See creativecommons.org/licenses/by-sa/4.0/
Note: RGB LED can be replaced by 0603 LED in same footprint and not mounting R14/R15
Note: Unmount R2 for Low-Power Operation
Remove R20 if LiPo Charger
VOLTAGE SENSE

Schematic: BluePillF4-2.sch, BluePill F4

Parts:
C6, C8: 4u7; C0603; PARTNO C0603_4u7_X7R_10%_CER_6V3
C18: 100n; C0603; PARTNO C0603_100n_X7R_10%_CER_50V
C19, C20: 1u; C0603; PARTNO C0603_1u_X7R_10%_CER_6V3
D4: 1N5819HW; SOD-123; PARTNO 1N5819HW
Q1: IRLML6402; SOT323
R17: 15k; R0603; PARTNO R0603_15k_5%_125mW
R18: 10k; R0603; PARTNO R0603_10k_5%_125mW
R19: 0R; R0603; PARTNO R0603_510R_5%_125mW
U1: AP2114HA-3.3TRG1; SOT223; PARTNO AP2114HA3.3-TRG1
U2: AP2112K3.3-TRG1; SOT23-5; PARTNO AP2112K3.3-TRG1
U5: MCP73812T-420I/OT; SOT23-5

Connections:
+3V3: C8.1, C18.2, U1.3 (VOUT); also elsewhere on the board
+3V3A: U2.5 (VOUT); also elsewhere on the board
+5V: C19.1, D4.A, Q1.1, R18.1, R19.1, U5.1, U5.4; also elsewhere on the board
+VBAT: C20.1, Q1.3, U5.3; also elsewhere on the board
+VIN: C6.1, D4.C, Q1.2, R19.2, U1.1 (VIN), U2.1 (VIN), U2.3 (EN); also elsewhere on the board
/BluePillF4-2/PROG: R17.1, U5.5
AGND: U2.2 (GND); also elsewhere on the board

Notes on the sheet:
Licensed under a Creative Commons Attribution-Share-Alike Unported License. See creativecommons.org/licenses/by-sa/4.0/
Reference designs are provided "AS IS" and "WITH ALL FAULTS".
The author(s) disclaims all other warranties express or implied,
regarding this product, including but not limited to, any implied warranties of
merchantibility or fitness for any particular application.
The author(s) may make changes to specifications and product
descriptions at any time, without notice.
LIPO CHARGER
Resistors are 5% 1/8W 0603 unless otherwise specified
Ceramic capacitors are +-10% 50V X7R dielectric 0603 unless otherwise specified
Remove R19 if LiPo Charger
POWER
Note: Mount L1 or U2, but not both

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
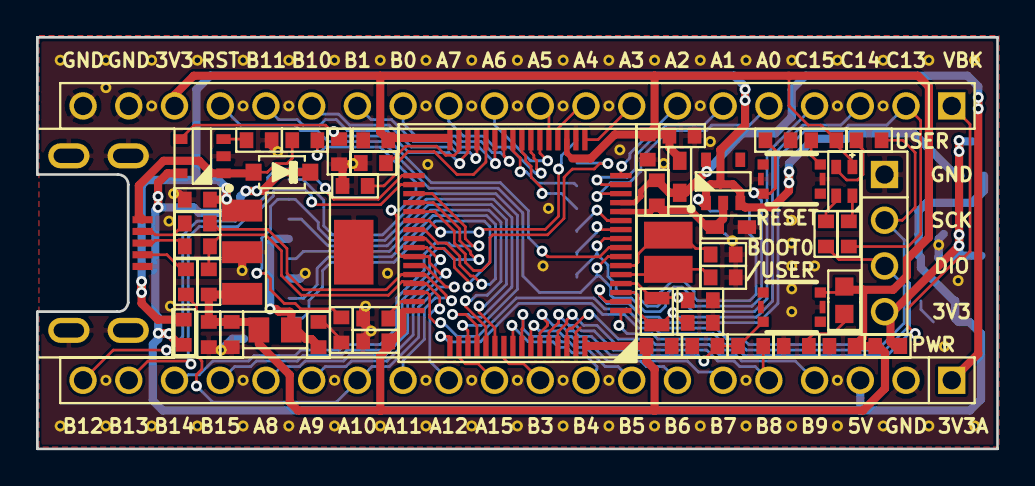
[picture p54: board BluePillF4.kicad_pcb from above]

Board: 2 copper layers, 53.3 x 22.9 mm, 74 parts (0 on the bottom side), 75 nets.

Other parts of the board:
PC0: TEST_PAD
R6: 10k; R0603
U$4: OPEN_HARDWARE_LOGO
U$6: RECYCLE_BIN_LOGO

Their connections:
+3V3: R6.1; also elsewhere on the board
/BluePillF4-1/R6: R6.2; also elsewhere on the board
