rogerclarkmelbourne/STM32_Pill_Boards/BluepillF4/BluepillF405.kicad_pcb

## KiCad design BluepillF4/BluepillF405.kicad_pcb (2017-10-19)

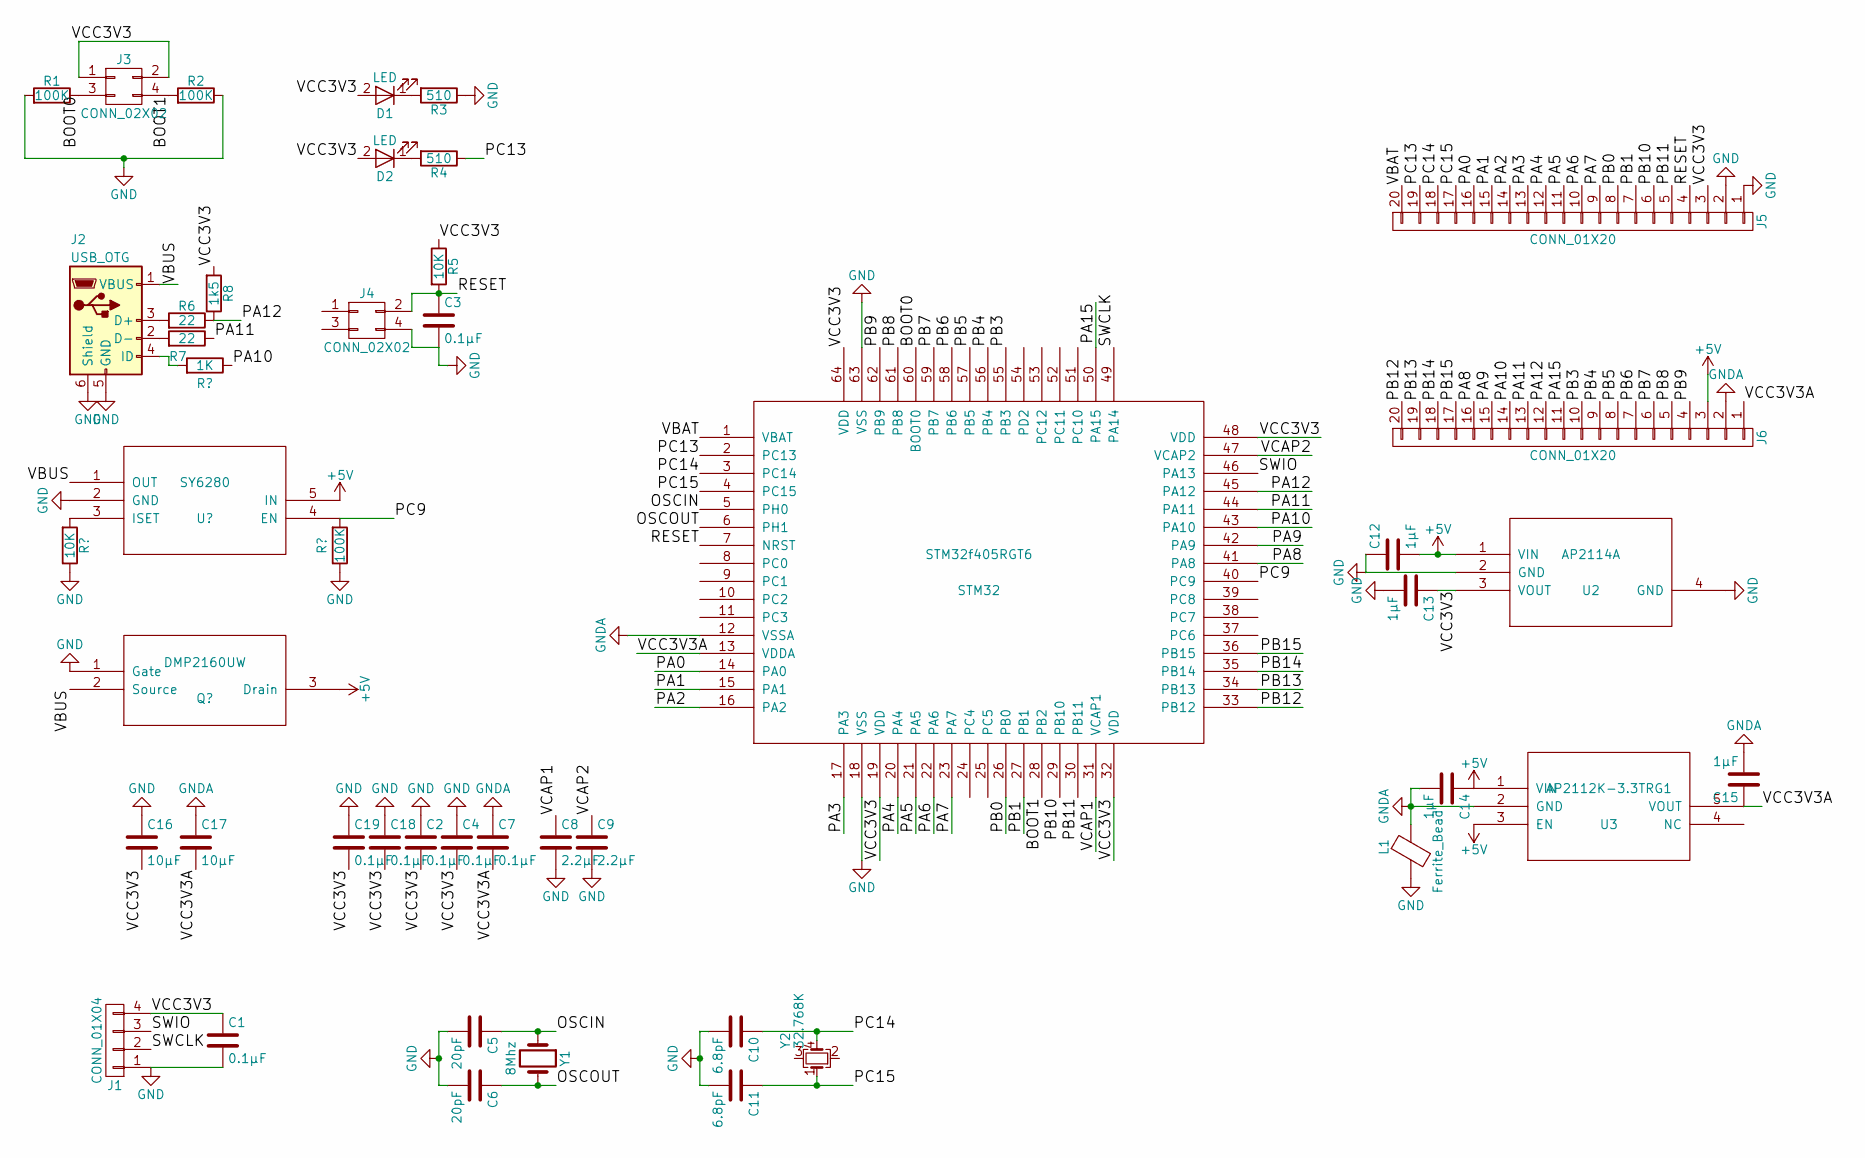
[picture p55: schematic BluepillF405.sch]

Parts:
C1, C2, C3, C4, C7, C18, C19: 0.1µF; C_0603
C5, C6: 20pF; C_0603
C8, C9: 2.2µF; C_0603
C10, C11: 6.8pF; C_0603
C12, C13, C14, C15: 1µF; C_0603
C16, C17: 10µF; C_0603
D1, D2: LED; LED_0805
J1: CONN_01X04; Pin_Header_Straight_1x04_Pitch2.54mm
J2: USB_OTG; USB_Micro 10118194-0001LF
J3: CONN_02X02; Pin_Header_Straight_2x02_Pitch2.54mm
J4: CONN_02X02; RS-187R05
J5, J6: CONN_01X20; Pin_Header_Straight_1x20_Pitch2.54mm
L1: Ferrite_Bead; C_0603
R1, R2: 100K; R_0603
R3, R4: 510; R_0603
R5: 10K; R_0603
R6, R7: 22; R_0603
R8: 1k5; R_0603
STM32: STM32f405RGT6; LQFP-64_10x10mm_Pitch0.5mm
U2: AP2114A; SOT-223
U3: AP2112K-3.3TRG1; SOT-23-5
Y1: 8Mhz; Crystal_HC49-U_Vertical
Y2: 32.768K; Crystal_SMD_SeikoEpson_MC306-4pin_8.0x3.2mm

Connections:
/BOOT0: J3.3, R1.1, STM32.60 (BOOT0)
/BOOT1: J3.4, R2.2, STM32.28 (PB2)
/OSCIN: C5.1, STM32.5 (PH0), Y1.1
/OSCOUT: C6.1, STM32.6 (PH1), Y1.2
/PA0: J5.16, STM32.14 (PA0)
/PA1: J5.15, STM32.15 (PA1)
/PA2: J5.14, STM32.16 (PA2)
/PA3: J5.13, STM32.17 (PA3)
/PA4: J5.12, STM32.20 (PA4)
/PA5: J5.11, STM32.21 (PA5)
/PA6: J5.10, STM32.22 (PA6)
/PA7: J5.9, STM32.23 (PA7)
/PA8: J6.16, STM32.41 (PA8)
/PA9: J6.15, STM32.42 (PA9)
/PA10: J2.4 (ID), J6.14, STM32.43 (PA10)
/PA11: J6.13, R7.1, STM32.44 (PA11)
/PA12: J6.12, R6.1, R8.1, STM32.45 (PA12)
/PA15: J6.11, STM32.50 (PA15)
/PB0: J5.8, STM32.26 (PB0)
/PB1: J5.7, STM32.27 (PB1)
/PB3: J6.10, STM32.55 (PB3)
/PB4: J6.9, STM32.56 (PB4)
/PB5: J6.8, STM32.57 (PB5)
/PB6: J6.7, STM32.58 (PB6)
/PB7: J6.6, STM32.59 (PB7)
/PB8: J6.5, STM32.61 (PB8)
/PB9: J6.4, STM32.62 (PB9)
/PB10: J5.6, STM32.29 (PB10)
/PB11: J5.5, STM32.30 (PB11)
/PB12: J6.20, STM32.33 (PB12)
/PB13: J6.19, STM32.34 (PB13)
/PB14: J6.18, STM32.35 (PB14)
/PB15: J6.17, STM32.36 (PB15)
/PC13: J5.19, R4.1, STM32.2 (PC13)
/PC14: C10.1, J5.18, STM32.3 (PC14), Y2.4
/PC15: C11.1, J5.17, STM32.4 (PC15), Y2.1
/RESET: C3.1, J4.2, J5.4, R5.2, STM32.7 (NRST)
/SWCLK: J1.2, STM32.49 (PA14)
/SWIO: J1.3, STM32.46 (PA13)
/VBAT: J5.20, STM32.1 (VBAT)
/VCAP1: C8.1, STM32.31 (VCAP1)
/VCAP2: C9.1, STM32.47 (VCAP2)
/VCC3V3: C1.1, C2.2, C4.2, C13.1, C16.2, C18.2, C19.2, D1.2 (A), D2.2 (A), J1.4, J3.1, J3.2, J5.3, R5.1, R8.2, STM32.19 (VDD), STM32.32 (VDD), STM32.48 (VDD), STM32.64 (VDD), U2.3 (VOUT)
/VCC3V3A: C7.2, C15.1, C17.2, J6.1, STM32.13 (VDDA), U3.5 (VOUT)
GND: C1.2, C2.1, C3.2, C4.1, C5.2, C6.2, C8.2, C9.2, C10.2, C11.2, C12.1, C13.2, C16.1, C18.1, C19.1, J1.1, J2.5 (GND), J2.6 (Shield), J4.4, J5.1, J5.2, L1.2, R1.2, R2.1, R3.1, STM32.18 (VSS), STM32.63 (VSS), U2.2 (GND), U2.4 (GND)
GNDA: C7.1, C14.2, C15.2, C17.1, J6.2, L1.1, STM32.12 (VSSA), U3.2 (GND)
unnamed: D1.1 (K), R3.2
unnamed: D2.1 (K), R4.2
unnamed: J2.2 (D-), R7.2
unnamed: J2.3 (D+), R6.2

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
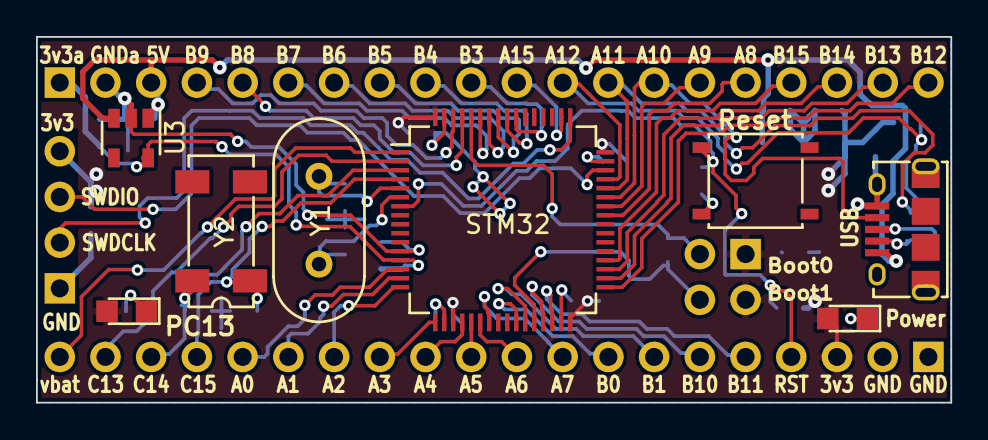
[picture p56: board BluepillF405.kicad_pcb from above]

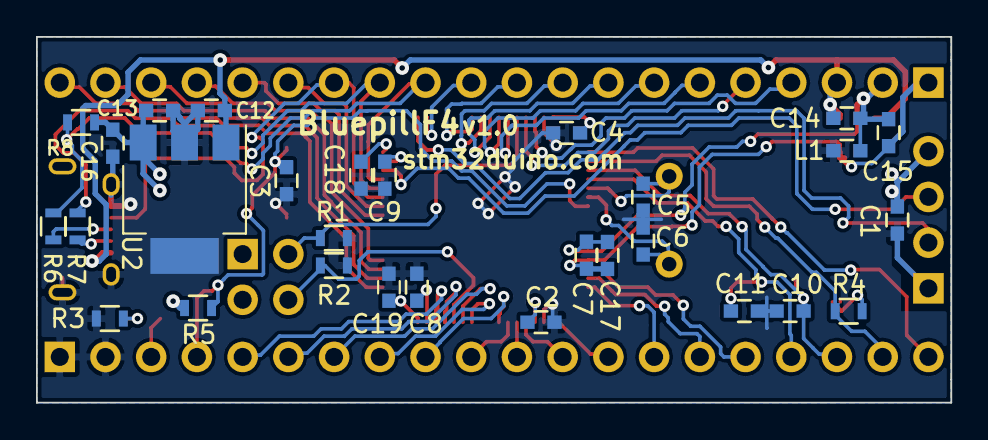
[picture p57: board BluepillF405.kicad_pcb from below]

Board: 2 copper layers, 50.8 x 20.3 mm, 41 parts (29 on the bottom side), 51 nets.
