rogerclarkmelbourne/STM32_Pill_Boards/STM32F4Stamp/modified_eagle_files/F405Pill.brd

## EAGLE design STM32F4Stamp/modified_eagle_files/F405Pill.brd (2017-09-29)

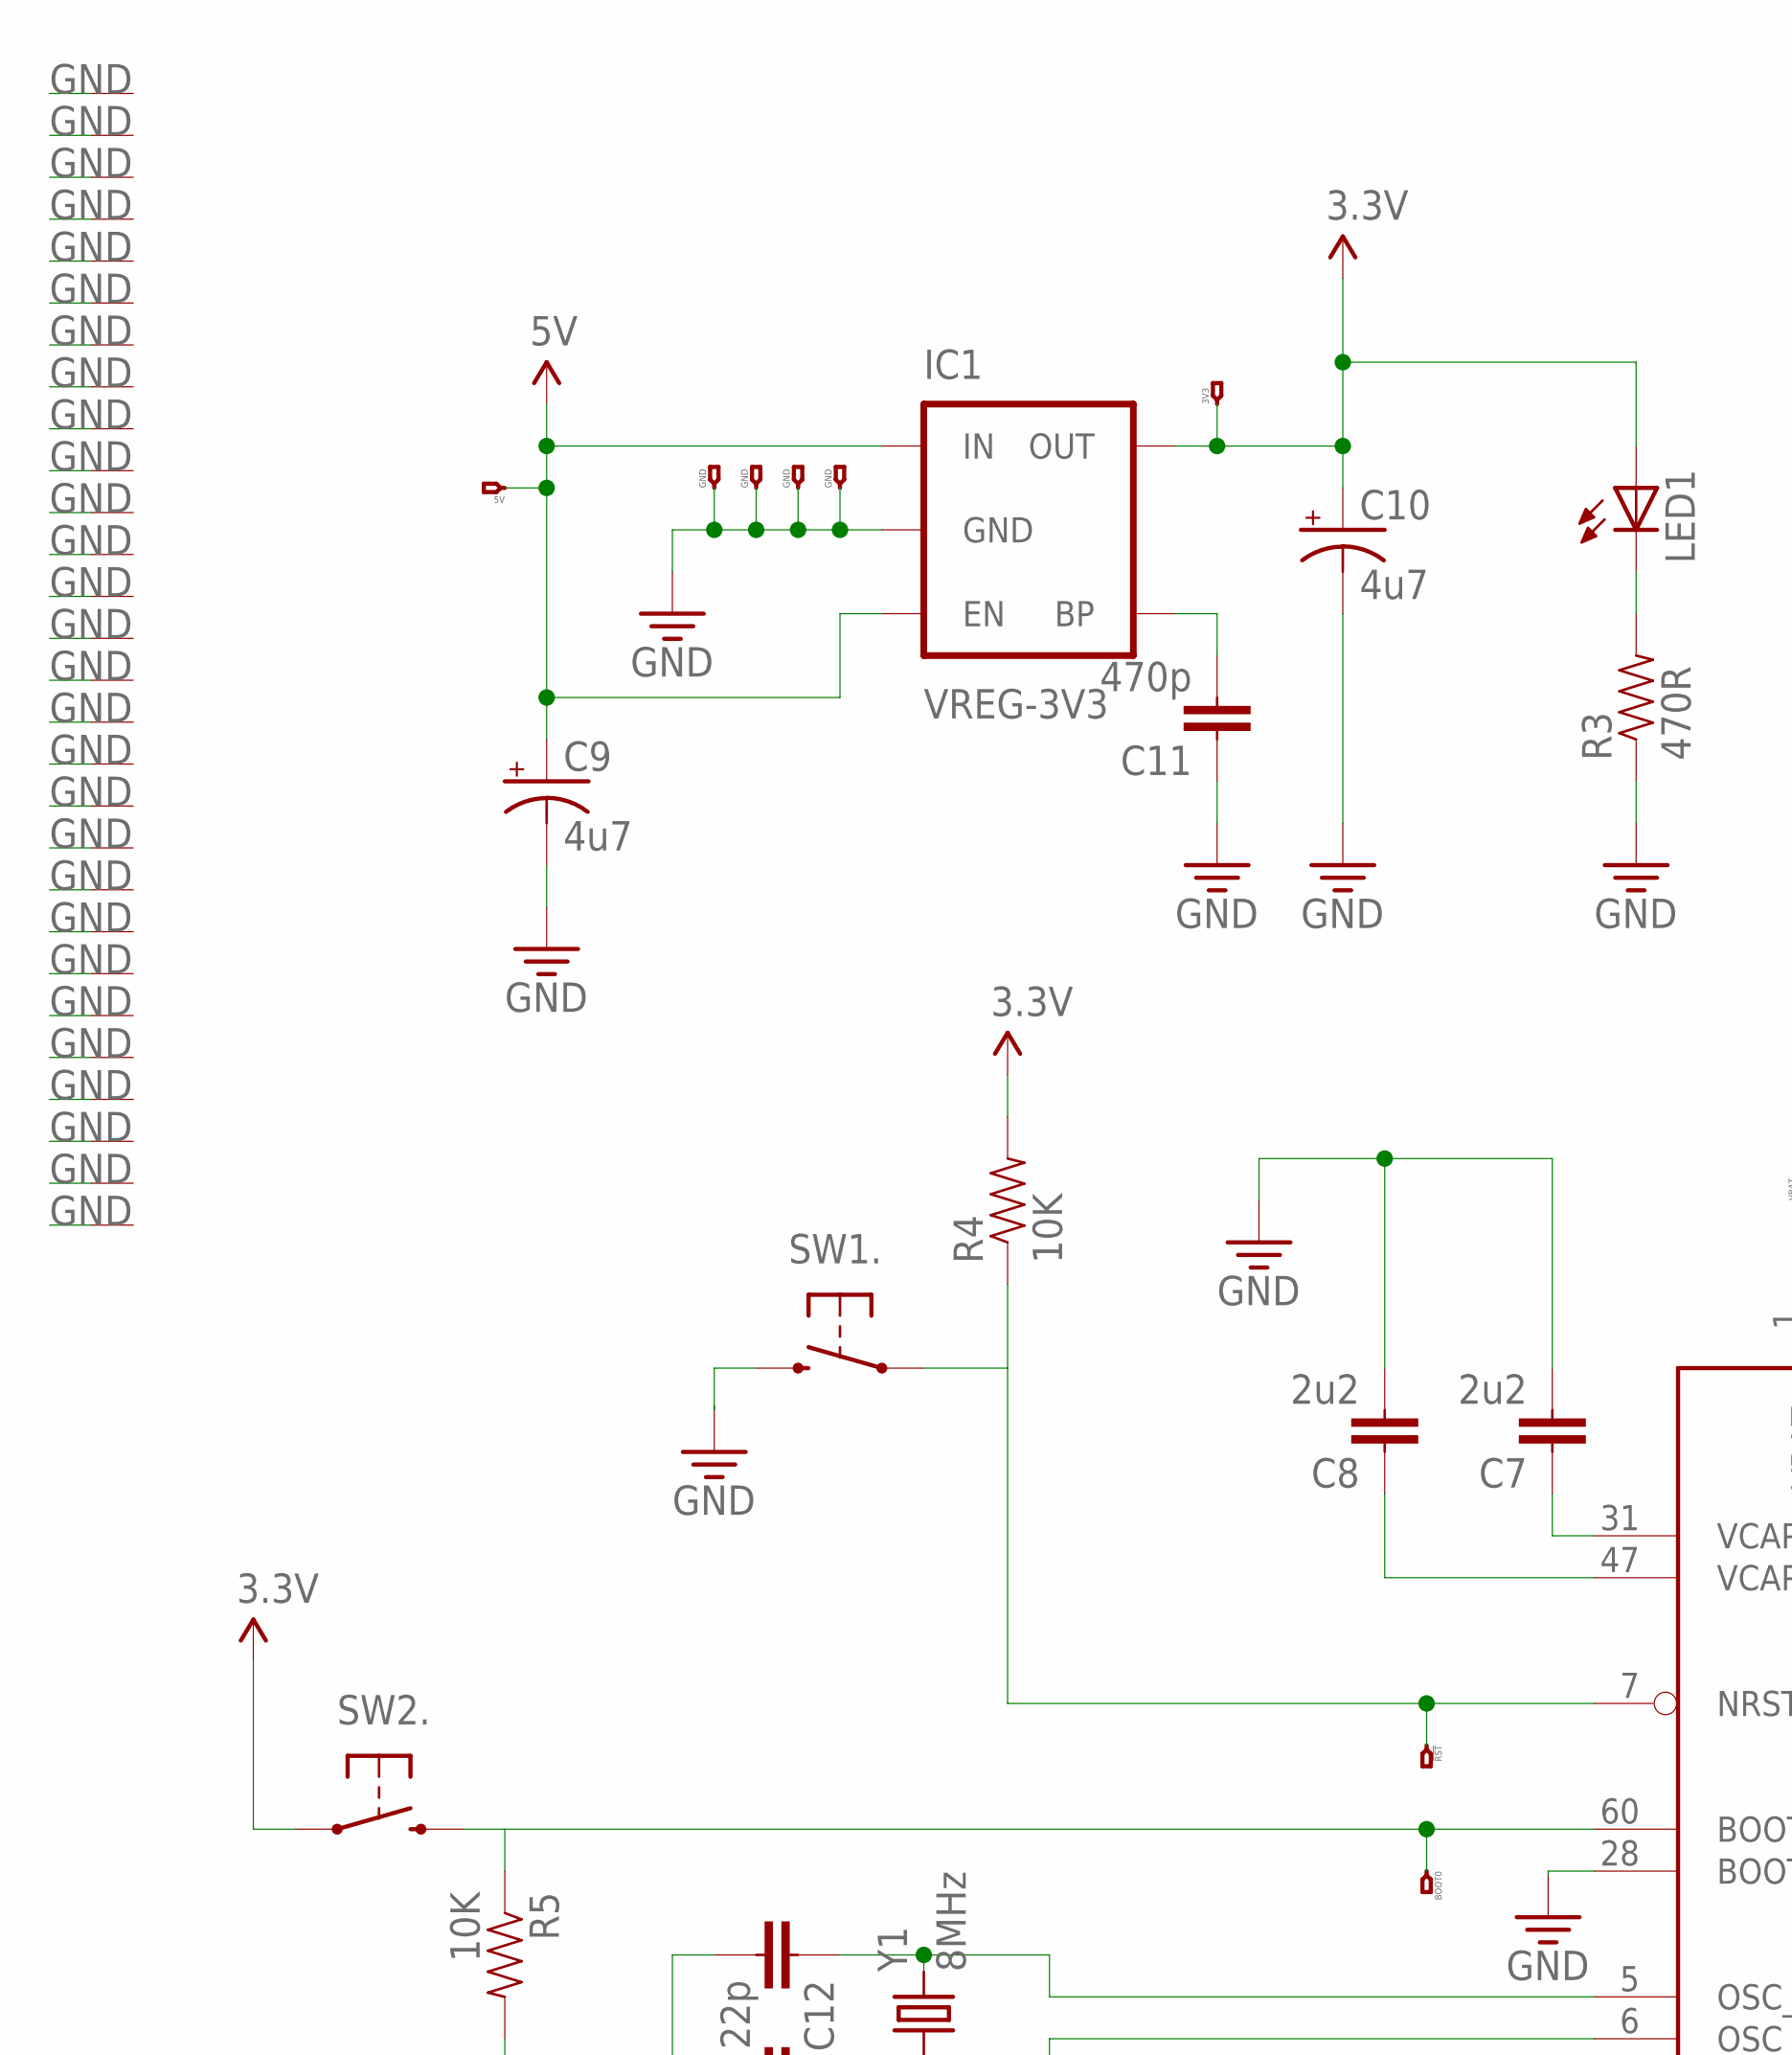
[picture p63: schematic F405Pill.sch, part in row 1, column 1]

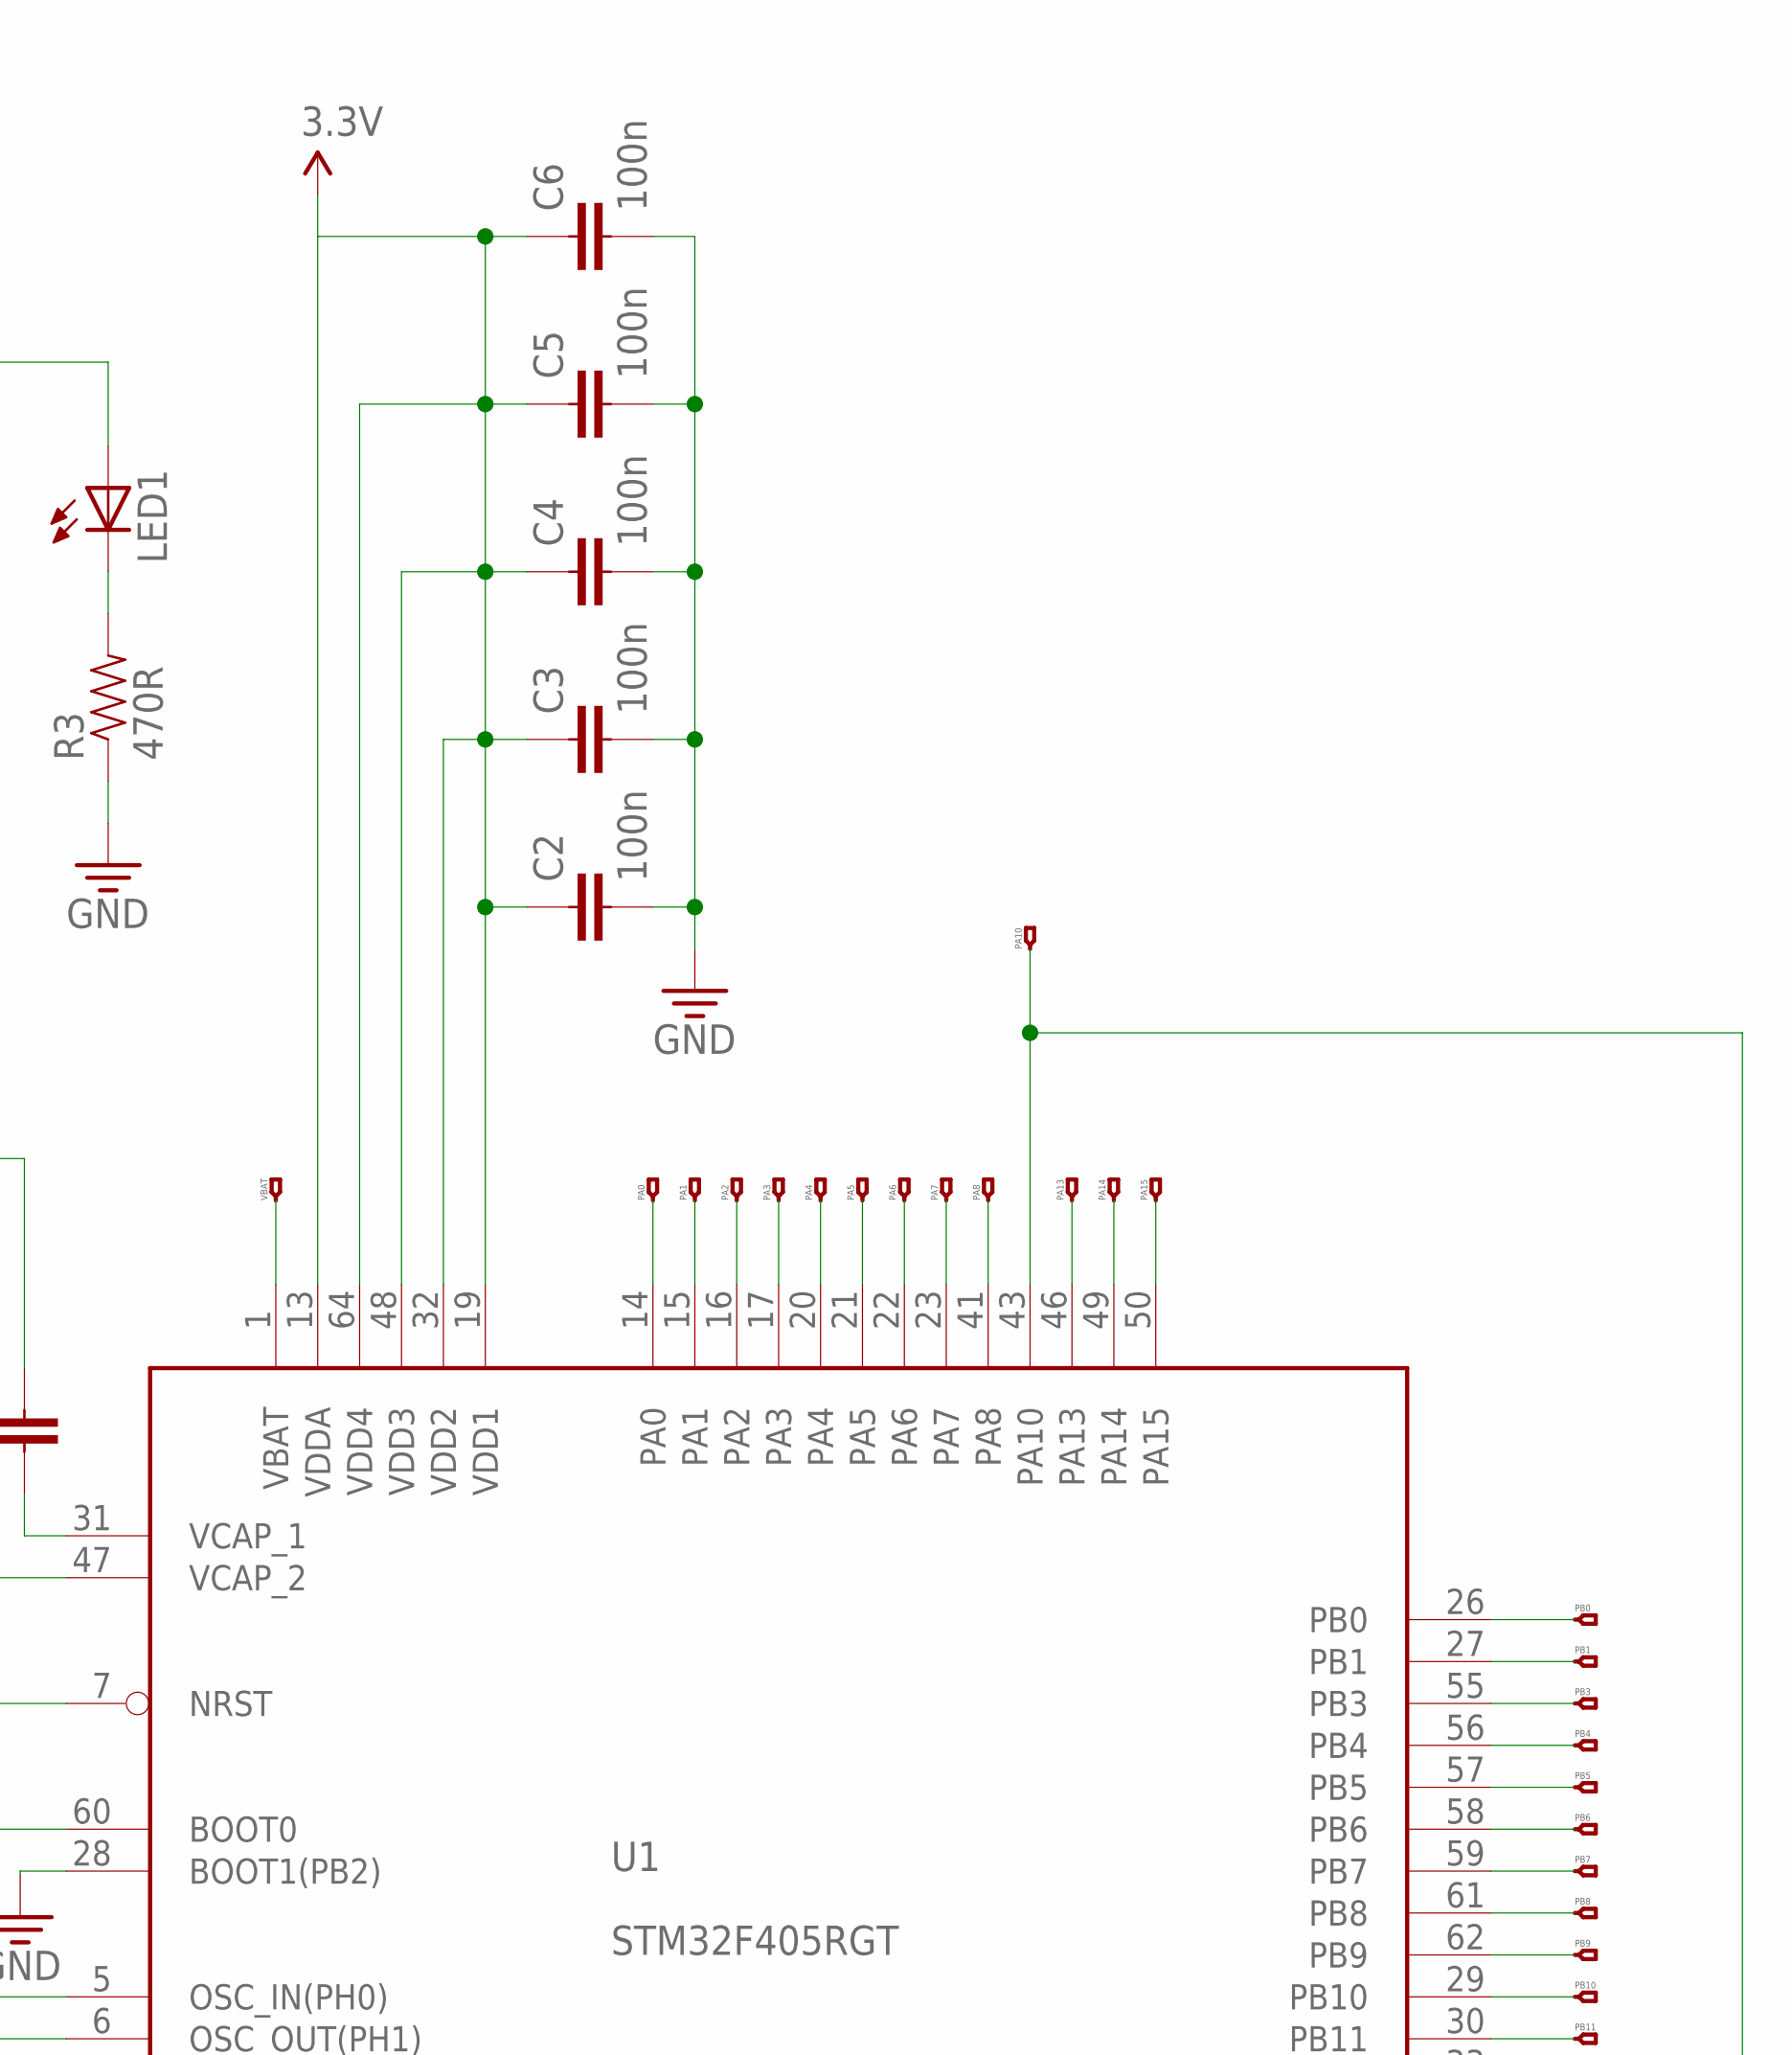
[picture p64: schematic F405Pill.sch, part in row 1, column 2]

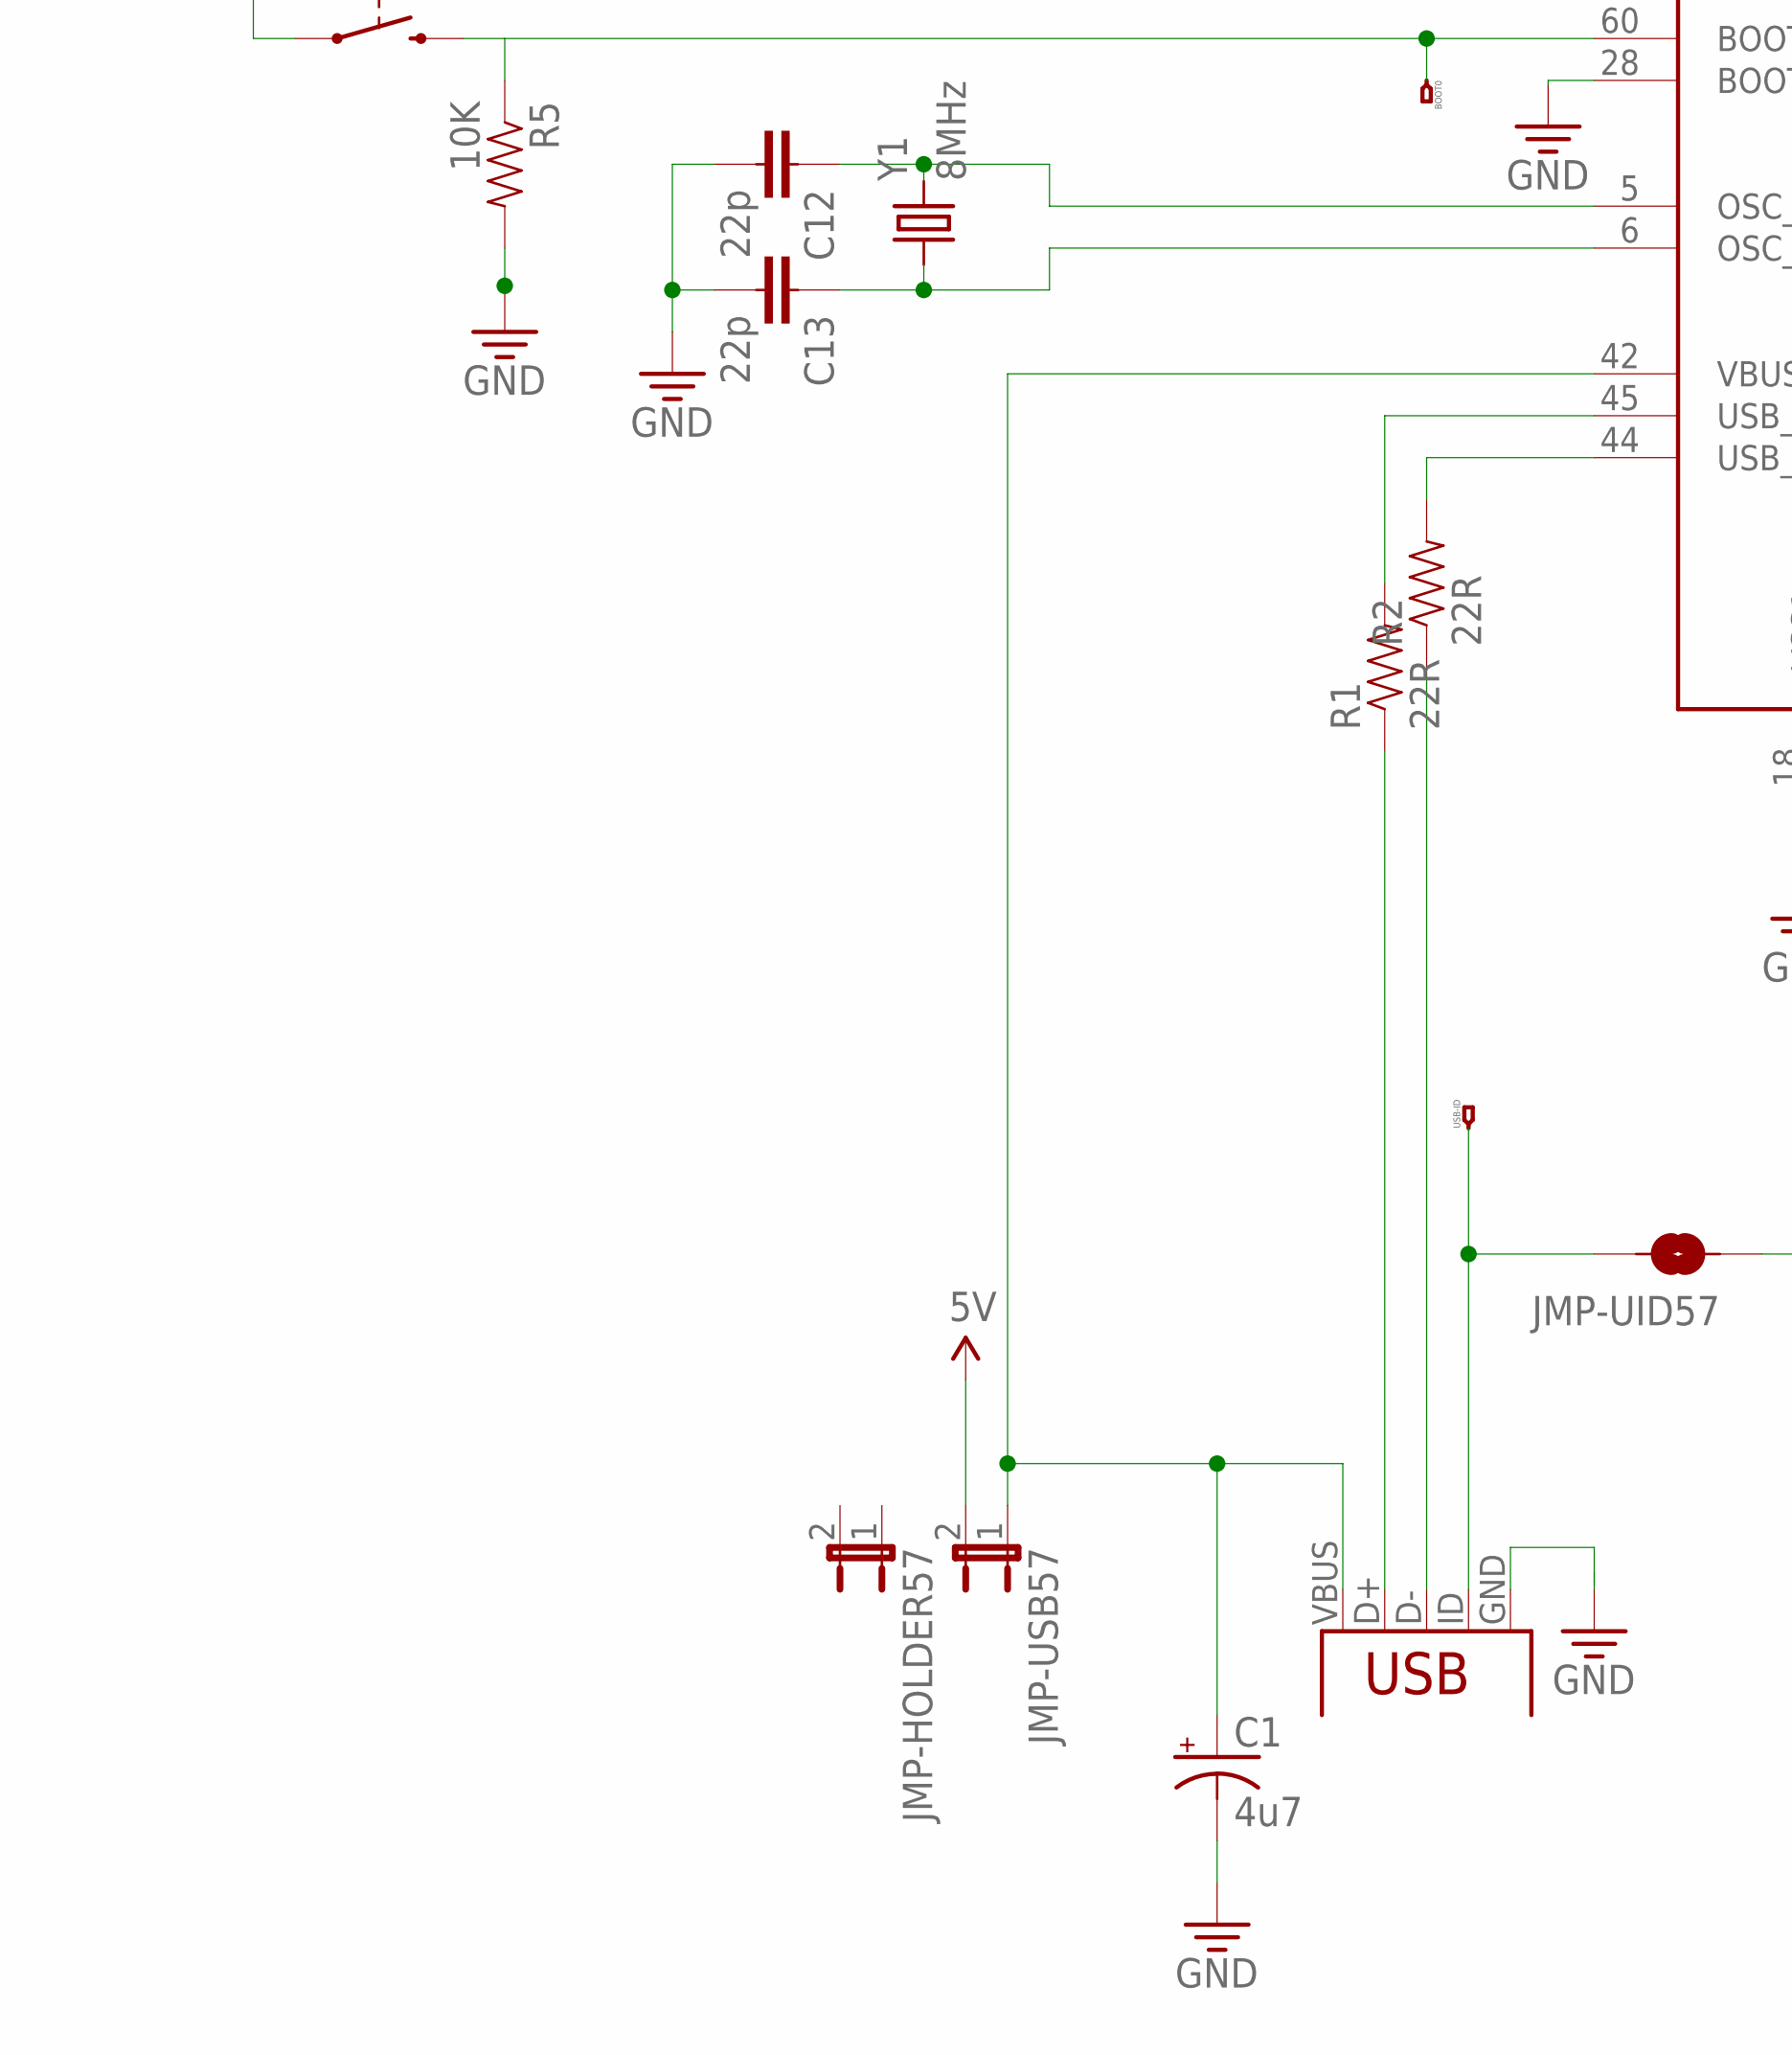
[picture p65: schematic F405Pill.sch, part in row 2, column 1]

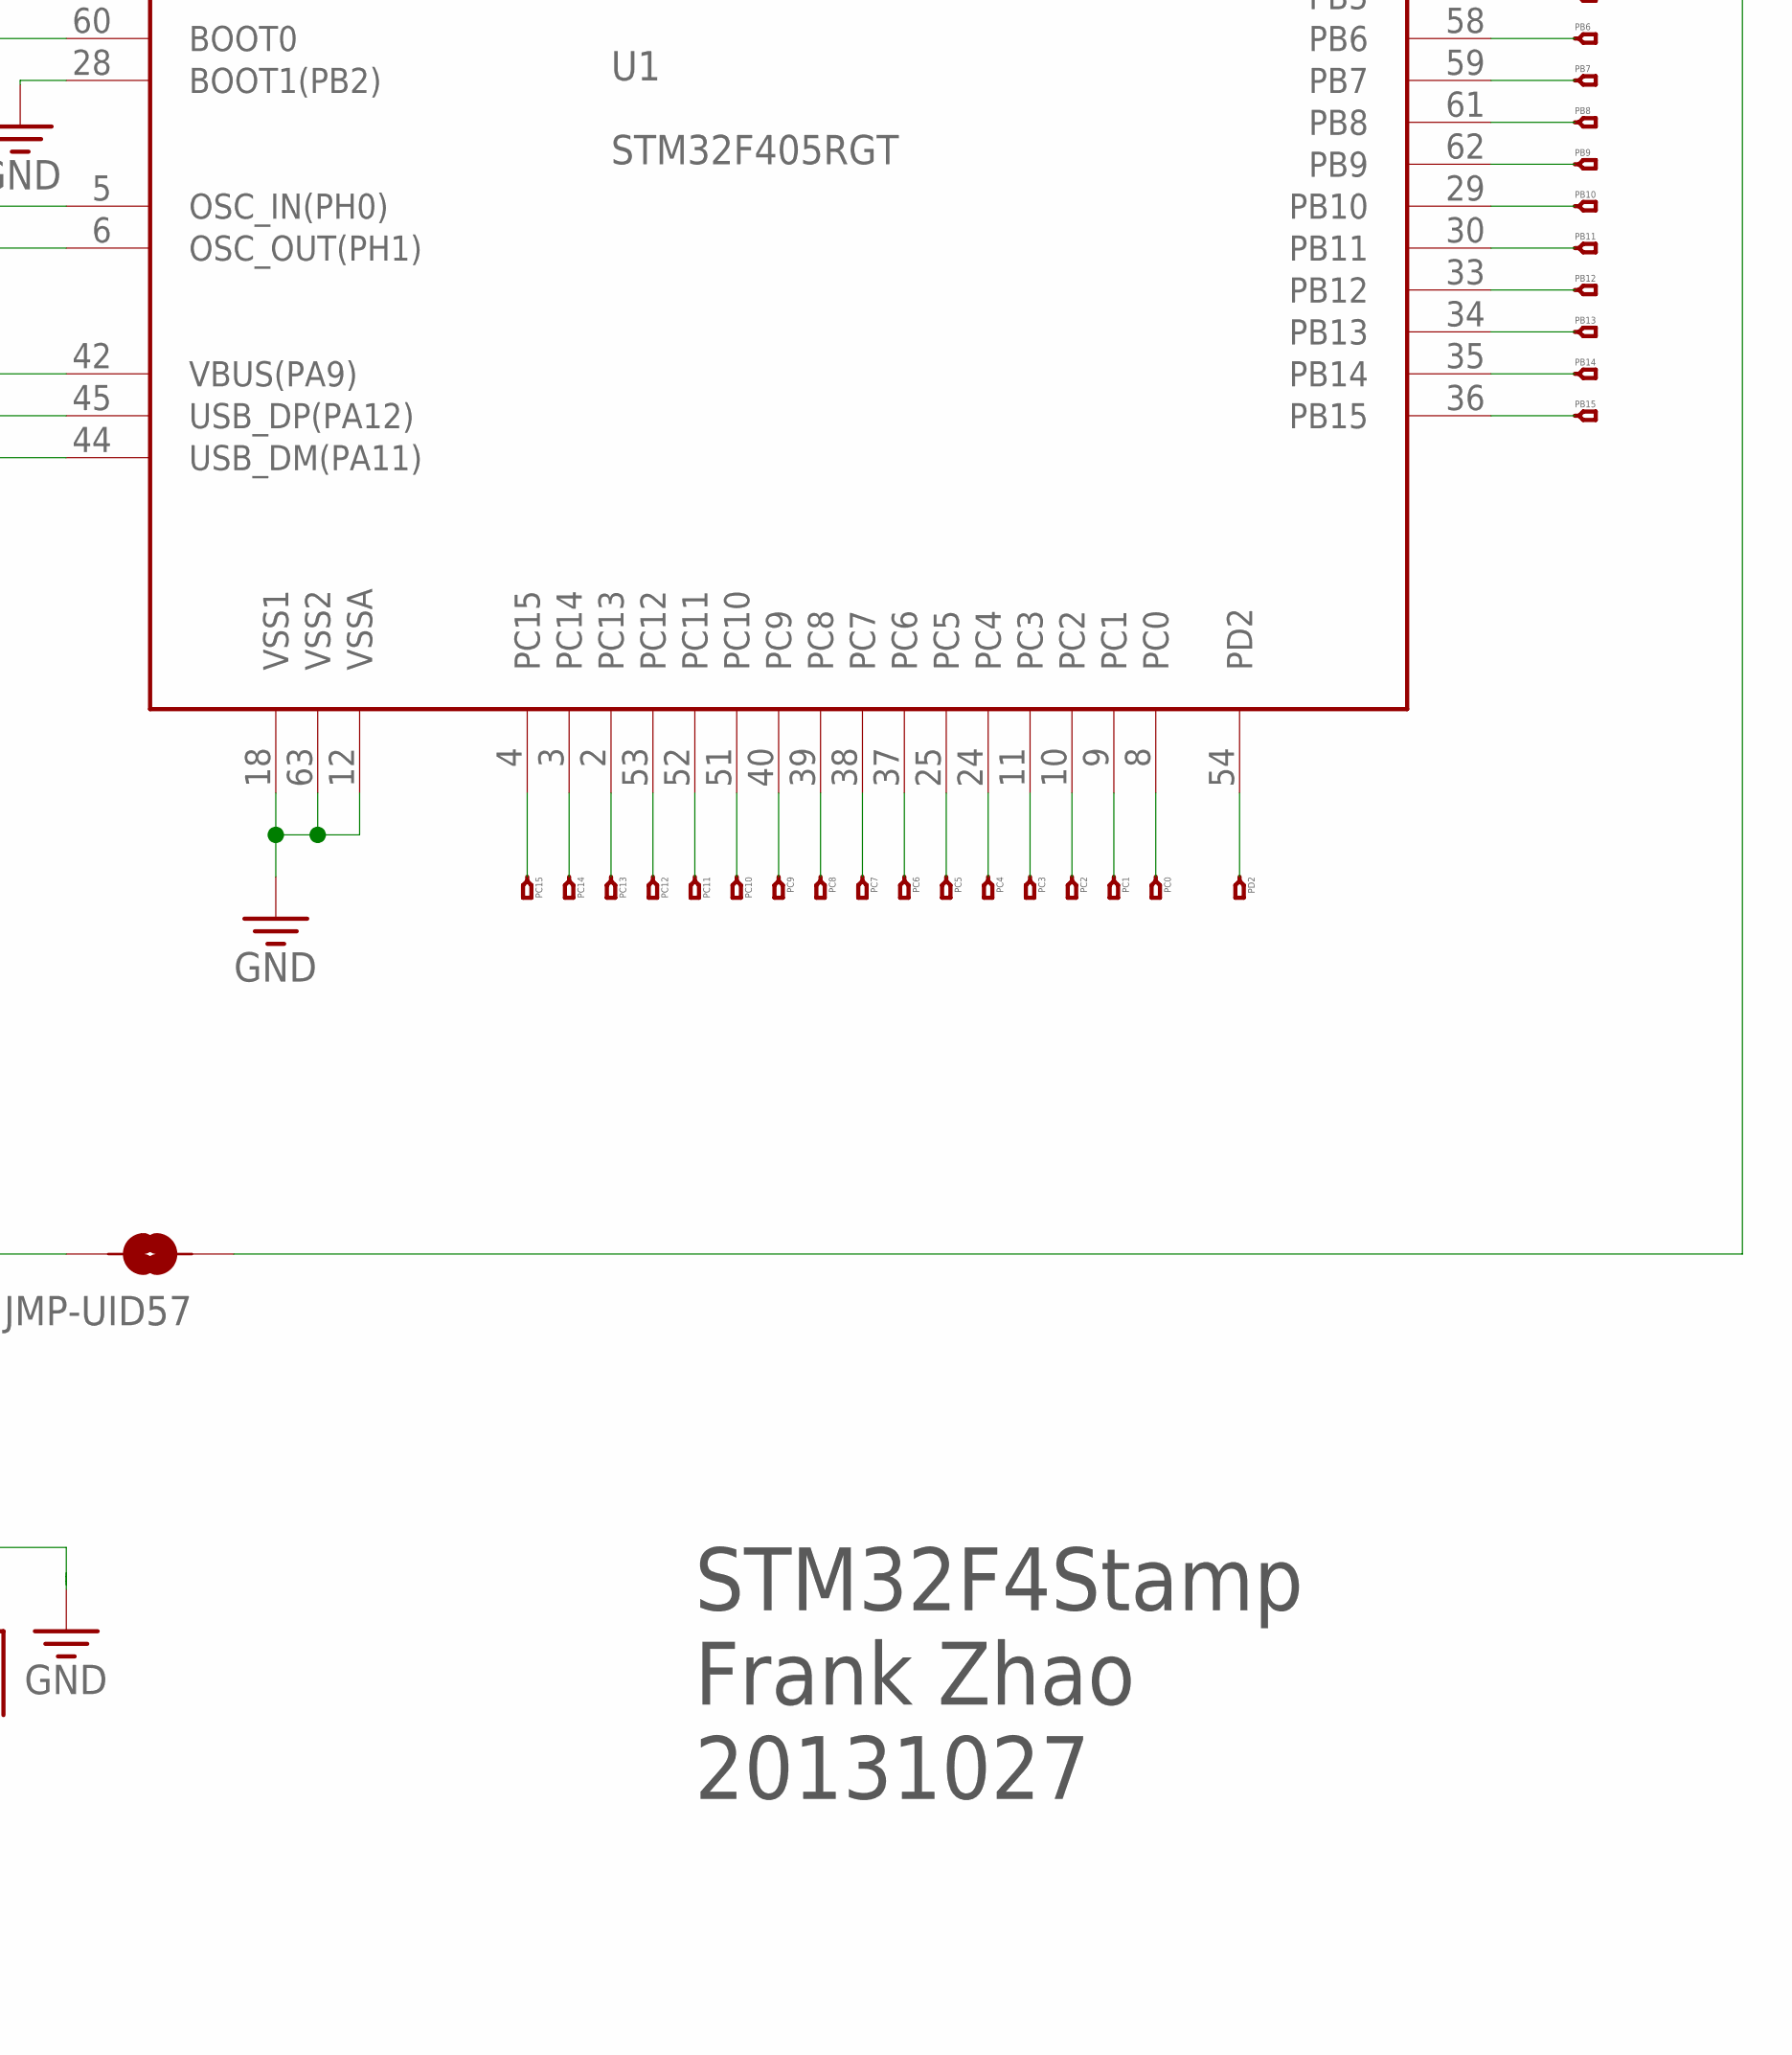
[picture p66: schematic F405Pill.sch, part in row 2, column 2]

Parts:
C1, C9, C10: 4u7; EIA3216-KIT
C2, C3, C4, C5, C6: 100n; 0603-CAP
C7, C8: 2u2; 0603-CAP
C11: 470p; 0603-CAP
C12, C13: 22p; 0603-CAP
IC1: VREG-3V3; SOT23-5
JMP-HOLDER57: JUMPER-2-PTH-2MM; 1X02_2MM_TH
JMP-UID57: SOLDERJUMPERNC; SJ_2S
JMP-USB57: JUMPER-2-PTH-2MM; 1X02_2MM_TH
JP2: 5V; 1X1-HEADER-HOLE
JP3, JP5, JP6, JP7: GND; 1X1-HEADER-HOLE
JP4: 3V3; 1X1-HEADER-HOLE
JP8: PB8; 1X1-HEADER-HOLE
JP9: PA10; 1X1-HEADER-HOLE
JP10: PA8; 1X1-HEADER-HOLE
JP11: PA13; 1X1-HEADER-HOLE
JP12: PC9; 1X1-HEADER-HOLE
JP13: PC15; 1X1-HEADER-HOLE
JP14: PC14; 1X1-HEADER-HOLE
JP15: PC13; 1X1-HEADER-HOLE
JP16: PC12; 1X1-HEADER-HOLE
JP17: PC11; 1X1-HEADER-HOLE
JP18: PC10; 1X1-HEADER-HOLE
JP19: PC8; 1X1-HEADER-HOLE
JP20: PC7; 1X1-HEADER-HOLE
JP21: PC6; 1X1-HEADER-HOLE
JP22: PC5; 1X1-HEADER-HOLE
JP23: PC4; 1X1-HEADER-HOLE
JP24: PC3; 1X1-HEADER-HOLE
JP25: PC2; 1X1-HEADER-HOLE
JP26: PC1; 1X1-HEADER-HOLE
JP27: PC0; 1X1-HEADER-HOLE
JP28: PD2; 1X1-HEADER-HOLE
JP29: PA0; 1X1-HEADER-HOLE
JP30: PA1; 1X1-HEADER-HOLE
JP31: PA2; 1X1-HEADER-HOLE
JP32: PA3; 1X1-HEADER-HOLE
JP33: PA4; 1X1-HEADER-HOLE
JP34: PA5; 1X1-HEADER-HOLE
JP35: PA6; 1X1-HEADER-HOLE
JP36: PA7; 1X1-HEADER-HOLE
JP37: PA14; 1X1-HEADER-HOLE
JP38: PA15; 1X1-HEADER-HOLE
JP39: PB0; 1X1-HEADER-HOLE
JP40: PB1; 1X1-HEADER-HOLE
JP41: PB3; 1X1-HEADER-HOLE
JP42: PB4; 1X1-HEADER-HOLE
JP43: PB5; 1X1-HEADER-HOLE
JP44: PB6; 1X1-HEADER-HOLE
JP45: PB7; 1X1-HEADER-HOLE
JP46: PB9; 1X1-HEADER-HOLE
JP47: PB10; 1X1-HEADER-HOLE
JP48: PB11; 1X1-HEADER-HOLE
JP49: PB12; 1X1-HEADER-HOLE
JP50: PB13; 1X1-HEADER-HOLE
JP51: PB14; 1X1-HEADER-HOLE
JP52: PB15; 1X1-HEADER-HOLE
JP53: VBAT; 1X1-HEADER-HOLE
JP54: !RST; 1X1-HEADER-HOLE
JP55: BOOT0; 1X1-HEADER-HOLE
JP56: USB-ID; 1X1-HEADER-HOLE
LED1: LED0603; LED-0603
R1, R2: 22R; 0603-RES
R3: 470R; 0603-RES
R4, R5: 10K; 0603-RES
SW1: !RST; SWITCH-TACT-B3U-1100P-B
SW2: BOOT; SWITCH-TACT-B3U-1100P-B
U1: STM32F405RGT; LQFP64
USB57: USB-MICROB-SMD
VP_0, VP_1, VP_2, VP_3, VP_4, VP_5, VP_6, VP_7, VP_8, VP_9, VP_10, VP_11, VP_12, VP_13, VP_14, VP_15, VP_16, VP_17, VP_18, VP_19, VP_20, VP_21, VP_22, VP_23, VP_24, VP_25, VP_26, VP_27: VPDEV0; VPAC0
Y1: 8MHz; CRYSTAL-SMD-5X3

Connections:
3.3V: C2.1, C3.1, C4.1, C5.1, C6.1, C10.A (+), IC1.5 (OUT), JP4.1, LED1.A, R4.2, SW2.1, U1.13 (VDDA), U1.19 (VDD1), U1.32 (VDD2), U1.48 (VDD3), U1.64 (VDD4)
5V: C9.A (+), IC1.1 (IN), IC1.3 (EN), JMP-USB57.2, JP2.1
GND: C1.C (-), C2.2, C3.2, C4.2, C5.2, C6.2, C7.2, C8.2, C9.C (-), C10.C (-), C11.1, C12.2, C13.2, IC1.2 (GND), JP3.1, JP5.1, JP6.1, JP7.1, R3.1, R5.2, SW1.2, SW1.BOSS, SW2.BOSS, U1.12 (VSSA), U1.18 (VSS1), U1.28 (BOOT1(PB2)), U1.63 (VSS2), USB57.GND, USB57.MT1, USB57.MT2, USB57.MT3, USB57.MT4, VP_0.VP, VP_1.VP, VP_2.VP, VP_3.VP, VP_4.VP, VP_5.VP, VP_6.VP, VP_7.VP, VP_8.VP, VP_9.VP, VP_10.VP, VP_11.VP, VP_12.VP, VP_13.VP, VP_14.VP, VP_15.VP, VP_16.VP, VP_17.VP, VP_18.VP, VP_19.VP, VP_20.VP, VP_21.VP, VP_22.VP, VP_23.VP, VP_24.VP, VP_25.VP, VP_26.VP, VP_27.VP
unnamed: R1.2, U1.45 (USB_DP(PA12))
unnamed: R2.2, U1.44 (USB_DM(PA11))
unnamed: C1.A (+), JMP-USB57.1, U1.42 (VBUS(PA9)), USB57.VBUS
unnamed: JP12.1, U1.40 (PC9)
unnamed: R1.1, USB57.D+
unnamed: R2.1, USB57.D-
unnamed: JP8.1, U1.61 (PB8)
unnamed: C11.2, IC1.4 (BP)
unnamed: JP10.1, U1.41 (PA8)
unnamed: JP11.1, U1.46 (PA13)
unnamed: C13.1, U1.6 (OSC_OUT(PH1)), Y1.1
unnamed: C7.1, U1.31 (VCAP_1)
unnamed: C8.1, U1.47 (VCAP_2)
unnamed: C12.1, U1.5 (OSC_IN(PH0)), Y1.3 (2)
unnamed: JP55.1, R5.1, SW2.2, U1.60 (BOOT0)
unnamed: JP54.1, R4.1, SW1.1, U1.7 (NRST)
unnamed: LED1.C, R3.2
unnamed: JMP-UID57.2, JP56.1, USB57.ID
unnamed: JMP-UID57.1, JP9.1, U1.43 (PA10)
unnamed: JP13.1, U1.4 (PC15)
unnamed: JP14.1, U1.3 (PC14)
unnamed: JP15.1, U1.2 (PC13)
unnamed: JP16.1, U1.53 (PC12)
unnamed: JP17.1, U1.52 (PC11)
unnamed: JP18.1, U1.51 (PC10)
unnamed: JP19.1, U1.39 (PC8)
unnamed: JP20.1, U1.38 (PC7)
unnamed: JP21.1, U1.37 (PC6)
unnamed: JP22.1, U1.25 (PC5)
unnamed: JP23.1, U1.24 (PC4)
unnamed: JP24.1, U1.11 (PC3)
unnamed: JP25.1, U1.10 (PC2)
unnamed: JP26.1, U1.9 (PC1)
unnamed: JP27.1, U1.8 (PC0)
unnamed: JP28.1, U1.54 (PD2)
unnamed: JP29.1, U1.14 (PA0)
unnamed: JP30.1, U1.15 (PA1)
unnamed: JP31.1, U1.16 (PA2)
unnamed: JP32.1, U1.17 (PA3)
unnamed: JP33.1, U1.20 (PA4)
unnamed: JP34.1, U1.21 (PA5)
unnamed: JP35.1, U1.22 (PA6)
unnamed: JP36.1, U1.23 (PA7)
unnamed: JP37.1, U1.49 (PA14)
unnamed: JP38.1, U1.50 (PA15)
unnamed: JP39.1, U1.26 (PB0)
unnamed: JP40.1, U1.27 (PB1)
unnamed: JP41.1, U1.55 (PB3)
unnamed: JP42.1, U1.56 (PB4)
unnamed: JP43.1, U1.57 (PB5)
unnamed: JP44.1, U1.58 (PB6)
unnamed: JP45.1, U1.59 (PB7)
unnamed: JP46.1, U1.62 (PB9)
unnamed: JP47.1, U1.29 (PB10)
unnamed: JP48.1, U1.30 (PB11)
unnamed: JP49.1, U1.33 (PB12)
unnamed: JP50.1, U1.34 (PB13)
unnamed: JP51.1, U1.35 (PB14)
unnamed: JP52.1, U1.36 (PB15)
unnamed: JP53.1, U1.1 (VBAT)

Notes on the sheet:
STM32F4Stamp Frank Zhao 20131027

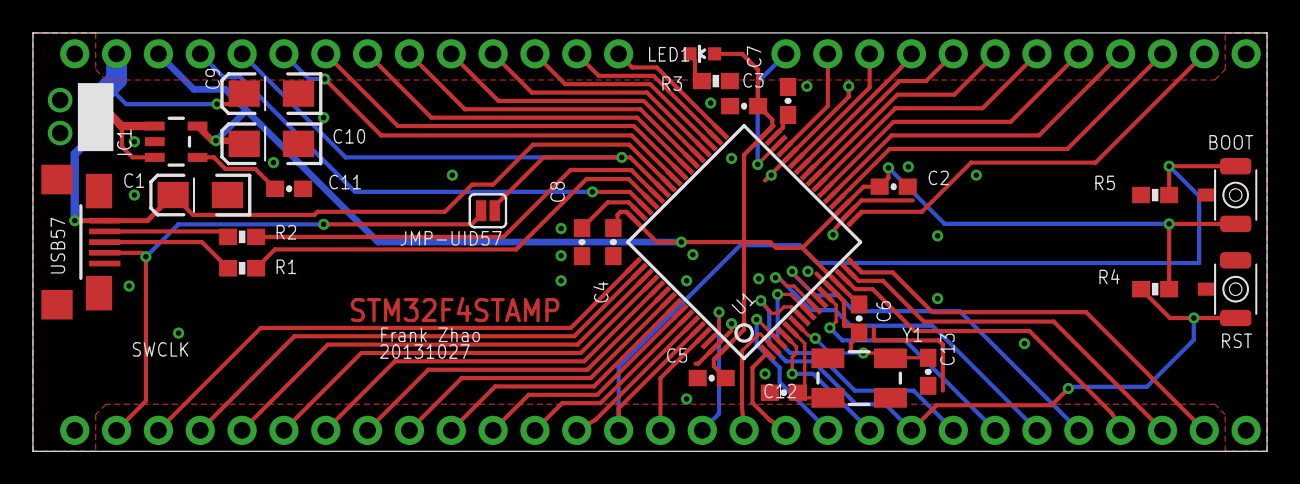
[picture p67: board F405Pill.brd from above]

Board: 2 copper layers, 74.9 x 25.4 mm, 111 parts (0 on the bottom side), 63 nets.
