rogerclarkmelbourne/STM32_Pill_Boards/Squonk42/EagleCAD/BluePillF4 Teardrops Panel.brd

## EAGLE design Squonk42/EagleCAD/BluePillF4 Teardrops Panel.brd (2019-04-03)

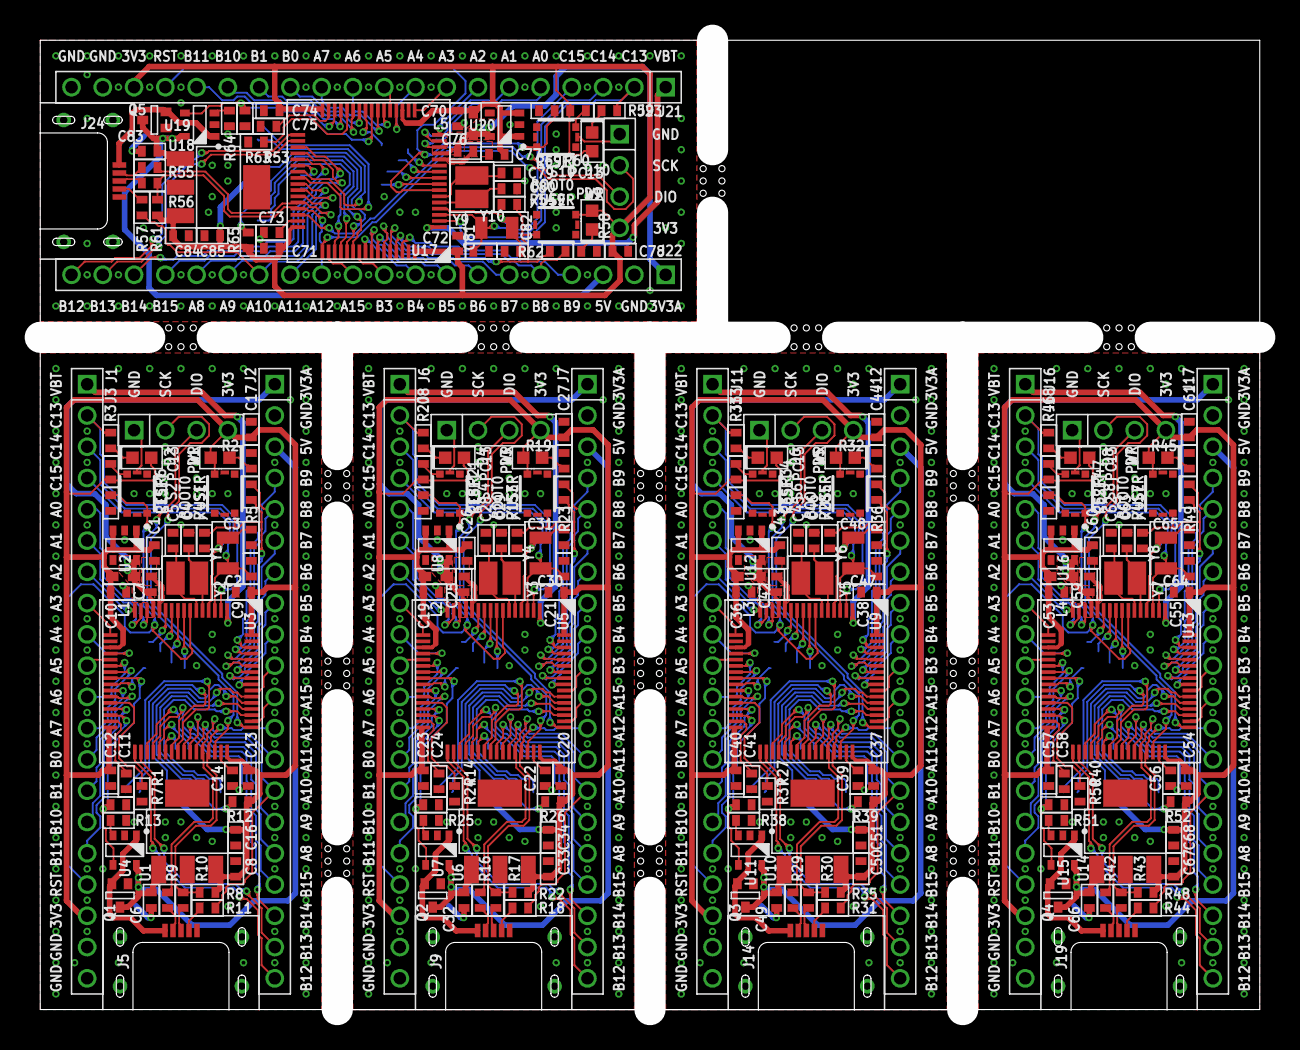
[picture p68: board BluePillF4 Teardrops Panel.brd from above]

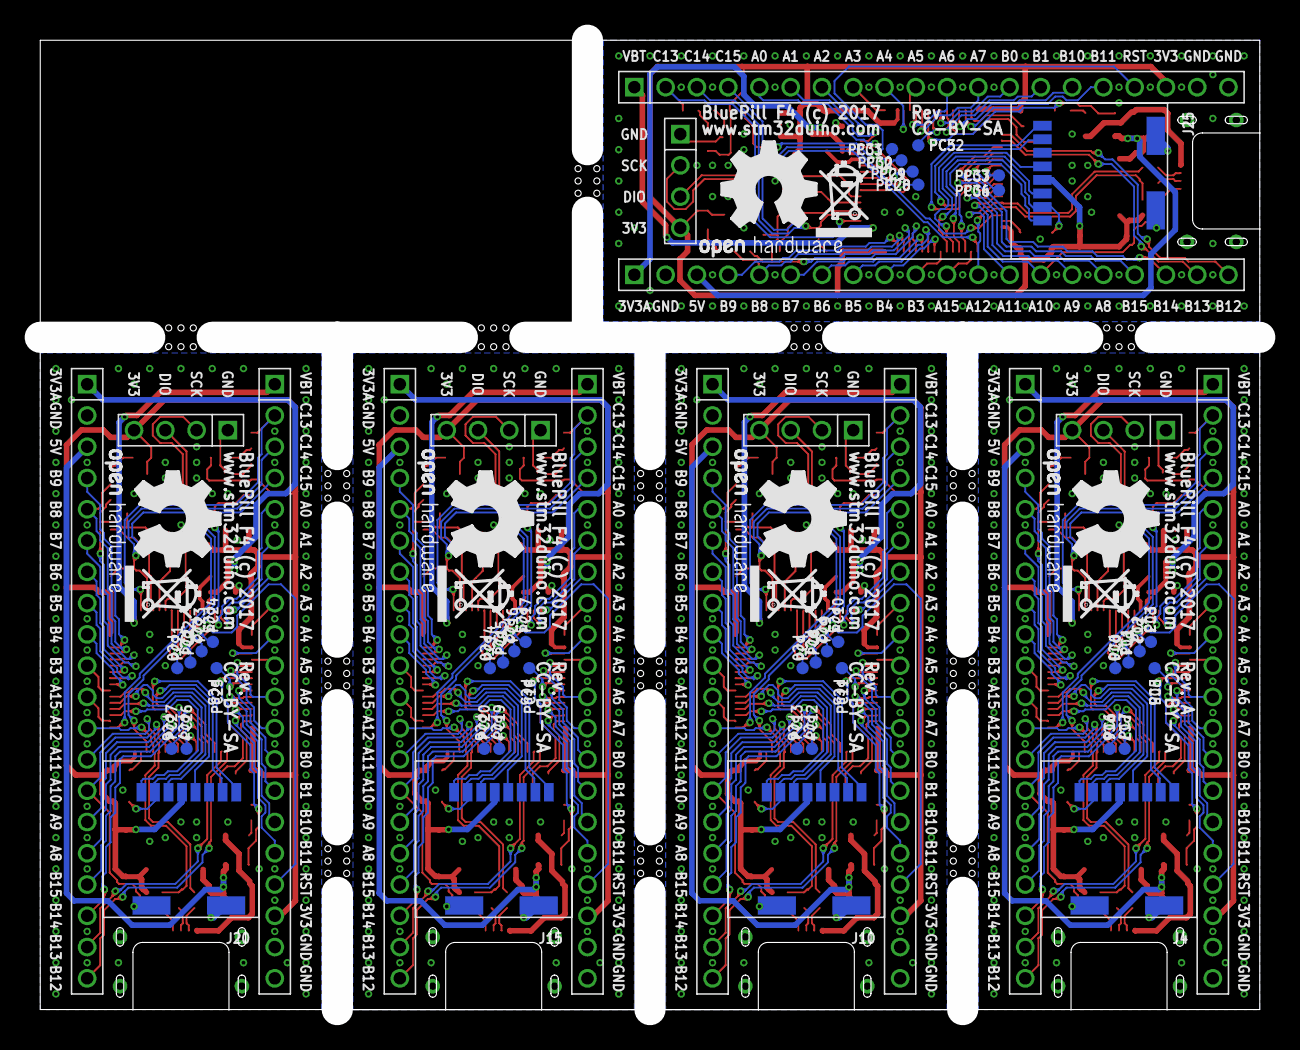
[picture p69: board BluePillF4 Teardrops Panel.brd from below]

Board: 2 copper layers, 99.1 x 78.7 mm, 283 parts (50 on the bottom side), 345 nets.

Parts:
C1, C26, C43, C60, C77: 10u; C0603
C2, C3, C30, C31, C47, C48, C64, C65, C81, C82: 6p8; C0603
C4, C5, C28, C29, C45, C46, C62, C63, C79, C80: 20p; C0603
C6, C8, C16, C32, C33, C34, C49, C50, C51, C66, C67, C68, C83, C84, C85: 4u7; C0603
C7, C9, C10, C12, C13, C15, C17, C18, C19, C20, C21, C23, C25, C27, C35, C36, C37, C38, C40, C42, C44, C52, C53, C54, C55, C57, C59, C61, C69, C70, C71, C72, C74, C76, C78: 100n; C0603
C11, C14, C22, C24, C39, C41, C56, C58, C73, C75: 2u2; C0603
D1, D3, D5, D7, D9: GREEN; LED0603
D2, D4, D6, D8, D10: RED; LED0603
DRILEGEND: DRILEGEND
J1, J2, J6, J7, J11, J12, J16, J17, J21, J22: MH20-1; MH20-1-0.1
J3, J8, J13, J18, J23: MH_RA4-1; MH_RA4-1-0.1
J4, J10, J15, J20, J25: MR07C-06200
J5, J9, J14, J19, J24: 47642-001; 47662-001
L1, L2, L3, L4, L5: FBMH1608HM471-T; FB0603
LOGO1: CC-BY-SA_LOGO
PC0, PC1, PC2, PC3, PC4, PC5, PC6, PC7, PC8, PC9, PC10, PC11, PC12, PC13, PC14, PC15, PC16, PC17, PC18, PC19, PC20, PC21, PC22, PC23, PC24, PC25, PC26, PC27, PC28, PC29, PC30, PC31, PC32, PC33, PC34: TEST_PAD
Q1, Q2, Q3, Q4, Q5: DMP2160UW-7; SOT323
R1, R4, R7, R12, R14, R15, R24, R26, R27, R28, R37, R39, R40, R41, R50, R52, R53, R54, R63, R65: 100k; R0603
R2, R3, R19, R20, R32, R33, R45, R46, R58, R59: 510R; R0603
R5, R23, R36, R49, R62: 0R; R0603
R6, R13, R21, R25, R34, R38, R47, R51, R60, R64: 10k; R0603
R8, R22, R35, R48, R61: 1k5; R0603
R9, R10, R16, R17, R29, R30, R42, R43, R55, R56: 22R; R0603
R11, R18, R31, R44, R57: 1k; R0603
S1, S2, S3, S4, S5, S6, S7, S8, S9, S10: SKSGACE010
U1, U6, U10, U14, U18: AP2114HA-3.3TRG1; SOT223
U2, U8, U12, U16, U20: AP2112K3.3-TRG1; SOT23-5
U3, U5, U9, U13, U17: STM32F405RGT6; LQFP64
U4, U7, U11, U15, U19: SY6280; SOT23-5
U$1, U$4, U$5, U$8, U$10: OPEN_HARDWARE_LOGO
U$2: A5L-LOC
U$3, U$6, U$7, U$9, U$11: RECYCLE_BIN_LOGO
Y1, Y4, Y6, Y8, Y10: FC-135; CRYSTAL_32X15
Y2, Y3, Y5, Y7, Y9: NX3225GD; CRYSTAL_32X25_2P

Connections:
+3V1: C19.2, C20.1, C21.2, C23.1, C26.1, C27.2, C33.1, C34.2, D3.2, D4.2, J6.18, J8.4, J10.P4, L2.1, R21.1, R22.1, R26.2, S3.3, U5.19, U5.32, U5.48, U5.64, U6.3, U8.1, U8.3
+3V2: C36.2, C37.1, C38.2, C40.1, C43.1, C44.2, C50.1, C51.2, D5.2, D6.2, J11.18, J13.4, J15.P4, L3.1, R34.1, R35.1, R39.2, S5.3, U9.19, U9.32, U9.48, U9.64, U10.3, U12.1, U12.3
+3V3: C1.1, C8.1, C9.2, C10.2, C12.1, C13.1, C16.2, C17.2, D1.2, D2.2, J1.18, J3.4, J4.P4, L1.1, R6.1, R8.1, R12.2, S1.3, U1.3, U2.1, U2.3, U3.19, U3.32, U3.48, U3.64
+3V3A: C7.2, J2.1, L1.2, U2.5, U3.13
+3V3A1: C25.2, J7.1, L2.2, U5.13, U8.5
+3V3A2: C42.2, J12.1, L3.2, U9.13, U12.5
+3V3A3: C59.2, J17.1, L4.2, U13.13, U16.5
+3V3A4: C76.2, J22.1, L5.2, U17.13, U20.5
+3V4: C53.2, C54.1, C55.2, C57.1, C60.1, C61.2, C67.1, C68.2, D7.2, D8.2, J16.18, J18.4, J20.P4, L4.1, R47.1, R48.1, R52.2, S7.3, U13.19, U13.32, U13.48, U13.64, U14.3, U16.1, U16.3
+3V5: C70.2, C71.1, C72.2, C74.1, C77.1, C78.2, C84.1, C85.2, D9.2, D10.2, J21.18, J23.4, J25.P4, L5.1, R60.1, R61.1, R65.2, S9.3, U17.19, U17.32, U17.48, U17.64, U18.3, U20.1, U20.3
+5V: C6.1, J2.3, Q1.3, U1.1, U4.5
+5V1: C32.1, J7.3, Q2.3, U6.1, U7.5
+5V2: C49.1, J12.3, Q3.3, U10.1, U11.5
+5V3: C66.1, J17.3, Q4.3, U14.1, U15.5
+5V4: C83.1, J22.3, Q5.3, U18.1, U19.5
AGND: C1.2, C7.1, U3.12
AGND1: C25.1, C26.2, U5.12
AGND2: C42.1, C43.2, U9.12
AGND3: C59.1, C60.2, U13.12
AGND4: C76.1, C77.2, U17.12
BOOT0: R4.1, R5.2, S1.2, U3.60
BOOT1: R15.1, R23.2, S3.2, U5.60
BOOT2: R28.1, R36.2, S5.2, U9.60
BOOT3: R41.1, R49.2, S7.2, U13.60
BOOT4: R54.1, R62.2, S9.2, U17.60
D1: D1.1, R2.2
D2: D2.1, R3.2
D3: D3.1, R19.2
D4: D4.1, R20.2
D5: D5.1, R32.2
D6: D6.1, R33.2
D7: D7.1, R45.2
D8: D8.1, R46.2
D9: D9.1, R58.2
D10: D10.1, R59.2
DM: J5.2, R9.1
DM1: J9.2, R16.1
DM2: J14.2, R29.1
DM3: J19.2, R42.1
DM4: J24.2, R55.1
DP: J5.3, R10.1
DP1: J9.3, R17.1
DP2: J14.3, R30.1
DP3: J19.3, R43.1
DP4: J24.3, R56.1
GND: C2.2, C3.2, C4.2, C5.2, C6.2, C8.2, C9.1, C10.1, C11.1, C12.2, C13.2, C14.1, C15.1, C16.1, C17.1, J1.19, J1.20, J2.2, J3.1, J4.G1, J4.G2, J4.P6, J5.5, J5.S$1, J5.S$2, J5.S$3, J5.S$4, Q1.1, R1.2, R2.1, R4.2, R7.2, R13.2, S1.5, S1.6, S2.5, S2.6, U1.2, U1.PAD, U2.2, U3.18, U3.63, U4.2
GND1: C18.1, C19.1, C20.2, C21.1, C22.1, C23.2, C24.1, C27.1, C28.2, C29.2, C30.2, C31.2, C32.2, C33.2, C34.1, J6.19, J6.20, J7.2, J8.1, J9.5, J9.S$1, J9.S$2, J9.S$3, J9.S$4, J10.G1, J10.G2, J10.P6, Q2.1, R14.2, R15.2, R19.1, R24.2, R25.2, S3.5, S3.6, S4.5, S4.6, U5.18, U5.63, U6.2, U6.PAD, U7.2, U8.2
GND2: C35.1, C36.1, C37.2, C38.1, C39.1, C40.2, C41.1, C44.1, C45.2, C46.2, C47.2, C48.2, C49.2, C50.2, C51.1, J11.19, J11.20, J12.2, J13.1, J14.5, J14.S$1, J14.S$2, J14.S$3, J14.S$4, J15.G1, J15.G2, J15.P6, Q3.1, R27.2, R28.2, R32.1, R37.2, R38.2, S5.5, S5.6, S6.5, S6.6, U9.18, U9.63, U10.2, U10.PAD, U11.2, U12.2
GND3: C52.1, C53.1, C54.2, C55.1, C56.1, C57.2, C58.1, C61.1, C62.2, C63.2, C64.2, C65.2, C66.2, C67.2, C68.1, J16.19, J16.20, J17.2, J18.1, J19.5, J19.S$1, J19.S$2, J19.S$3, J19.S$4, J20.G1, J20.G2, J20.P6, Q4.1, R40.2, R41.2, R45.1, R50.2, R51.2, S7.5, S7.6, S8.5, S8.6, U13.18, U13.63, U14.2, U14.PAD, U15.2, U16.2
GND4: C69.1, C70.1, C71.2, C72.1, C73.1, C74.2, C75.1, C78.1, C79.2, C80.2, C81.2, C82.2, C83.2, C84.2, C85.1, J21.19, J21.20, J22.2, J23.1, J24.5, J24.S$1, J24.S$2, J24.S$3, J24.S$4, J25.G1, J25.G2, J25.P6, Q5.1, R53.2, R54.2, R58.1, R63.2, R64.2, S9.5, S9.6, S10.5, S10.6, U17.18, U17.63, U18.2, U18.PAD, U19.2, U20.2
ID: J5.4, R11.1
ID1: J9.4, R18.1
ID2: J14.4, R31.1
ID3: J19.4, R44.1
ID4: J24.4, R57.1
ISET: R13.1, U4.3
ISET1: R25.1, U7.3
ISET2: R38.1, U11.3
ISET3: R51.1, U15.3
ISET4: R64.1, U19.3
NRST: C15.2, J1.17, S2.2, U3.7
NRST1: C18.2, J6.17, S4.2, U5.7
NRST2: C35.2, J11.17, S6.2, U9.7
NRST3: C52.2, J16.17, S8.2, U13.7
NRST4: C69.2, J21.17, S10.2, U17.7
OSCIN: C4.1, U3.5, Y2.2
OSCIN1: C29.1, U5.5, Y3.2
OSCIN2: C46.1, U9.5, Y5.2
OSCIN3: C63.1, U13.5, Y7.2
OSCIN4: C80.1, U17.5, Y9.2
OSCOUT: C5.1, U3.6, Y2.1
OSCOUT1: C28.1, U5.6, Y3.1
OSCOUT2: C45.1, U9.6, Y5.1
OSCOUT3: C62.1, U13.6, Y7.1
OSCOUT4: C79.1, U17.6, Y9.1
PA0: J1.5, U3.14
PA1: J1.6, U3.15
PA2: J1.7, U3.16
PA3: J1.8, U3.17
PA4: J1.9, U3.20
PA5: J1.10, U3.21
PA6: J1.11, U3.22
PA7: J1.12, U3.23
PA8: J2.16, U3.41
PA9: J2.15, U3.42
PA10: J2.14, R11.2, U3.43
PA11: J2.13, R9.2, U3.44
PA12: J2.12, R8.2, R10.2, U3.45
PA13: J3.3, U3.46
PA14: J3.2, U3.49
PA15: J2.11, U3.50
PA16: J6.5, U5.14
PA17: J6.6, U5.15
PA18: J6.7, U5.16
PA19: J6.8, U5.17
PA20: J6.9, U5.20
PA21: J6.10, U5.21
PA22: J6.11, U5.22
PA23: J6.12, U5.23
PA24: J8.3, U5.46
PA25: J7.12, R17.2, R22.2, U5.45
PA26: J7.13, R16.2, U5.44
PA27: J7.14, R18.2, U5.43
PA28: J7.15, U5.42
PA29: J7.16, U5.41
PA30: J7.11, U5.50
PA31: J8.2, U5.49
PA32: J11.5, U9.14
PA33: J11.6, U9.15
PA34: J11.7, U9.16
PA35: J11.8, U9.17
PA36: J11.9, U9.20
PA37: J11.10, U9.21
PA38: J11.11, U9.22
PA39: J11.12, U9.23
PA40: J13.3, U9.46
PA41: J12.12, R30.2, R35.2, U9.45
PA42: J12.13, R29.2, U9.44
PA43: J12.14, R31.2, U9.43
PA44: J12.15, U9.42
PA45: J12.16, U9.41
PA46: J12.11, U9.50
PA47: J13.2, U9.49
PA48: J16.5, U13.14
PA49: J16.6, U13.15
PA50: J16.7, U13.16
PA51: J16.8, U13.17
PA52: J16.9, U13.20
PA53: J16.10, U13.21
PA54: J16.11, U13.22
PA55: J16.12, U13.23
PA56: J18.3, U13.46
PA57: J17.12, R43.2, R48.2, U13.45
PA58: J17.13, R42.2, U13.44
PA59: J17.14, R44.2, U13.43
PA60: J17.15, U13.42
PA61: J17.16, U13.41
PA62: J17.11, U13.50
PA63: J18.2, U13.49
PA64: J21.5, U17.14
PA65: J21.6, U17.15
PA66: J21.7, U17.16
PA67: J21.8, U17.17
PA68: J21.9, U17.20
PA69: J21.10, U17.21
PA70: J21.11, U17.22
PA71: J21.12, U17.23
PA72: J23.3, U17.46
PA73: J22.12, R56.2, R61.2, U17.45
PA74: J22.13, R55.2, U17.44
PA75: J22.14, R57.2, U17.43
PA76: J22.15, U17.42
PA77: J22.16, U17.41
PA78: J22.11, U17.50
PA79: J23.2, U17.49
PB0: J1.13, U3.26
PB1: J1.14, U3.27
PB2: R1.1, U3.28
PB3: J2.10, U3.55
PB4: J2.9, U3.56
PB5: J2.8, U3.57
PB6: J2.7, U3.58
PB7: J2.6, U3.59
PB8: J2.5, R5.1, U3.61
PB9: J2.4, U3.62
PB10: J1.15, U3.29
PB11: J1.16, U3.30
PB12: J2.20, U3.33
PB13: J2.19, U3.34
PB14: J2.18, U3.35
PB15: J2.17, U3.36
PB16: J6.13, U5.26
PB17: J6.14, U5.27
PB18: R14.1, U5.28
PB19: J6.15, U5.29
PB20: J6.16, U5.30
PB21: J7.17, U5.36
PB22: J7.18, U5.35
PB23: J7.19, U5.34
PB24: J7.20, U5.33
PB25: J7.4, U5.62
PB26: J7.5, R23.1, U5.61
PB27: J7.6, U5.59
PB28: J7.7, U5.58
PB29: J7.8, U5.57
PB30: J7.9, U5.56
PB31: J7.10, U5.55
PB32: J11.13, U9.26
PB33: J11.14, U9.27
PB34: R27.1, U9.28
PB35: J11.15, U9.29
PB36: J11.16, U9.30
PB37: J12.17, U9.36
PB38: J12.18, U9.35
PB39: J12.19, U9.34
PB40: J12.20, U9.33
PB41: J12.4, U9.62
PB42: J12.5, R36.1, U9.61
PB43: J12.6, U9.59
PB44: J12.7, U9.58
PB45: J12.8, U9.57
PB46: J12.9, U9.56
PB47: J12.10, U9.55
PB48: J16.13, U13.26
PB49: J16.14, U13.27
PB50: R40.1, U13.28
PB51: J16.15, U13.29
PB52: J16.16, U13.30
PB53: J17.17, U13.36
PB54: J17.18, U13.35
PB55: J17.19, U13.34
PB56: J17.20, U13.33
PB57: J17.4, U13.62
PB58: J17.5, R49.1, U13.61
PB59: J17.6, U13.59
PB60: J17.7, U13.58
PB61: J17.8, U13.57
PB62: J17.9, U13.56
PB63: J17.10, U13.55
PB64: J21.13, U17.26
PB65: J21.14, U17.27
PB66: R53.1, U17.28
PB67: J21.15, U17.29
PB68: J21.16, U17.30
PB69: J22.17, U17.36
PB70: J22.18, U17.35
PB71: J22.19, U17.34
PB72: J22.20, U17.33
PB73: J22.4, U17.62
PB74: J22.5, R62.1, U17.61
PB75: J22.6, U17.59
PB76: J22.7, U17.58
PB77: J22.8, U17.57
PB78: J22.9, U17.56
PB79: J22.10, U17.55
PC0: PC0.1, U3.8
PC1: PC1.1, U3.9
PC2: PC2.1, U3.10
PC3: PC3.1, U3.11
PC4: J6.2, R20.1, U5.2
PC5: PC5.1, U3.25
PC6: PC6.1, U3.37
PC7: PC7.1, U3.38
PC8: C30.1, J6.3, U5.3, Y4.2
PC9: C31.1, J6.4, U5.4, Y4.1
PC10: PC4.1, U5.8
PC11: PC8.1, U5.9
PC12: PC9.1, U5.10
PC13: J1.2, R3.1, U3.2
PC14: C2.1, J1.3, U3.3, Y1.2
PC15: C3.1, J1.4, U3.4, Y1.1
PC16: PC10.1, U5.11
PC17: PC11.1, U5.25
PC18: PC12.1, U5.38
PC19: PC13.1, U5.37
PC20: J11.2, R33.1, U9.2
PC21: C47.1, J11.3, U9.3, Y6.2
PC22: C48.1, J11.4, U9.4, Y6.1
PC23: PC14.1, U9.8
PC24: PC15.1, U9.9
PC25: PC16.1, U9.10
PC26: PC17.1, U9.11
PC27: PC18.1, U9.25
PC28: PC19.1, U9.38
PC29: PC20.1, U9.37
PC30: J16.2, R46.1, U13.2
PC31: C64.1, J16.3, U13.3, Y8.2
PC32: C65.1, J16.4, U13.4, Y8.1
PC33: PC21.1, U13.8
PC34: PC22.1, U13.9
PC35: PC23.1, U13.10
PC36: PC24.1, U13.11
PC37: PC25.1, U13.25
PC38: PC26.1, U13.38
PC39: PC27.1, U13.37
PC40: J21.2, R59.1, U17.2
PC41: C81.1, J21.3, U17.3, Y10.2
PC42: C82.1, J21.4, U17.4, Y10.1
PC43: PC28.1, U17.8
PC44: PC29.1, U17.9
PC45: PC30.1, U17.10
PC46: PC31.1, U17.11
PC47: PC32.1, U17.25
PC48: PC33.1, U17.38
PC49: PC34.1, U17.37
R1: R21.2, S4.3
R2: R34.2, S6.3
R3: R47.2, S8.3
R4: R60.2, S10.3
R6: R6.2, S2.3
SDIO_CK: J4.P5, U3.53
SDIO_CK1: J10.P5, U5.53
SDIO_CK2: J15.P5, U9.53
SDIO_CK3: J20.P5, U13.53
SDIO_CK4: J25.P5, U17.53
SDIO_CMD: J4.P3, U3.54
SDIO_CMD1: J10.P3, U5.54
SDIO_CMD2: J15.P3, U9.54
SDIO_CMD3: J20.P3, U13.54
SDIO_CMD4: J25.P3, U17.54
SDIO_D0: J4.P7, U3.39
SDIO_D1: J4.P8, U3.40
SDIO_D2: J4.P1, U3.51
SDIO_D3: J4.P2, R12.1, U3.52
SDIO_D4: J10.P2, R26.1, U5.52
SDIO_D5: J10.P1, U5.51
SDIO_D6: J10.P8, U5.40
SDIO_D7: J10.P7, U5.39
SDIO_D8: J15.P2, R39.1, U9.52
SDIO_D9: J15.P1, U9.51
SDIO_D10: J15.P8, U9.40
SDIO_D11: J15.P7, U9.39
SDIO_D12: J20.P2, R52.1, U13.52
SDIO_D13: J20.P1, U13.51
SDIO_D14: J20.P8, U13.40
SDIO_D15: J20.P7, U13.39
SDIO_D16: J25.P2, R65.1, U17.52
SDIO_D17: J25.P1, U17.51
SDIO_D18: J25.P8, U17.40
SDIO_D19: J25.P7, U17.39
VBAT: J1.1, U3.1
VBAT1: J6.1, U5.1
VBAT2: J11.1, U9.1
VBAT3: J16.1, U13.1
VBAT4: J21.1, U17.1
VBUS: J5.1, Q1.2, U4.1
VBUS1: J9.1, Q2.2, U7.1
VBUS2: J14.1, Q3.2, U11.1
VBUS3: J19.1, Q4.2, U15.1
VBUS4: J24.1, Q5.2, U19.1
VBUS_EN: R7.1, U3.24, U4.4
VBUS_EN1: R24.1, U5.24, U7.4
VBUS_EN2: R37.1, U9.24, U11.4
VBUS_EN3: R50.1, U13.24, U15.4
VBUS_EN4: R63.1, U17.24, U19.4
VCAP_1: C11.2, U3.31
VCAP_2: C14.2, U3.47
VCAP_3: C24.2, U5.31
VCAP_4: C22.2, U5.47
VCAP_5: C41.2, U9.31
VCAP_6: C39.2, U9.47
VCAP_7: C58.2, U13.31
VCAP_8: C56.2, U13.47
VCAP_9: C75.2, U17.31
VCAP_10: C73.2, U17.47
