rogerclarkmelbourne/STM32_Pill_Boards/(commit log)

2017-09-29 Initial commit of incomplete work!
    [F405Pill.brd, F405Pill.kicad_pcb, F405Pill.sch, F411Pill.kicad_pcb, F411Pill.sch]
2017-09-30 Abandoned this project as uneconomic, but commited file all my incomplete work in case its of value to anyone else
    [F405Pill.kicad_pcb, F405Pill_V2.kicad_pcb, F405Pill_V2.sch, F411Pill.kicad_pcb]
2017-10-19 removed unnecessary USB pullup resistor from STM32F4STAMP
    [F405Pill.sch]
2017-10-19 Renamed F405Pill to STM32F4Stamp
    [F405Pill.brd, F405Pill.kicad_pcb, F405Pill.sch]
2017-10-19 Added STM32F4Stamp
    [F405Pill.brd, F405Pill.kicad_pcb, F405Pill.sch]
2017-10-19 Removed my attemps at F411 and F405 Pill
    [F405Pill_V2.kicad_pcb, F405Pill_V2.sch, F411Pill.kicad_pcb, F411Pill.sch]
2017-10-19 Added latest F4Pill by Racemanic
    [BluepillF405-B.Cu.gbl, BluepillF405-B.Mask.gbs, BluepillF405-B.Paste.gbp, BluepillF405-B.SilkS.gbo, BluepillF405-Edge.Cuts.gm1, BluepillF405-F.Cu.gtl, BluepillF405-F.Mask.gts, BluepillF405-F.Paste.gtp]
2017-11-28 Added board by Squonk42
    [BluePillF4.kicad_pcb, BluePillF4.sch]
2017-11-29 Integrated changes from @racemaniac for fixing the edge layer issue Removed Ref/Value for U3 (STM32) on PCB top Fixed Top & Bottom GND zones minnimum width to 6 mils Added some missing GND tracks due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
    [BluePillF4.kicad_pcb]
2017-12-08 Remove FET between VBus and +5V and replace with Schottky diode
    [BluePillF4.kicad_pcb, BluePillF4.sch]
2017-12-08 Revert back to commit 7277910...
    [BluePillF4.kicad_pcb, BluePillF4.sch]
2017-12-17 Powered AP2112 from +5V, not from +3.3V Added ferrite bead between GND and AGND Replaced 32kHz crystal by smaller FC-12M Adjusted solder mask clearance to 0 Made VBAT trace thinner Fixed MOSFET direc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
    [BluePillF4.kicad_pcb, BluePillF4.sch]
2017-12-20 Modified 3D model for microUSB connector to BSC U02-BFD3111B0-009
    [BluePillF4.kicad_pcb, BluePillF4.sch]
2017-12-23 Removed R12 pull-up resistoron SDIO_D3 Added R12 resistor to connect VBUS and PA9 for VBUS_SENSE (USB Host) feature Added C18 parallel decoupling capacitor on SDCard connector Added C19 parallel deco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
    [BluePillF4.kicad_pcb, BluePillF4.sch]
2017-12-26 Added RGB LED Added pull-down resistor on SDIO_D3 for SDCard detect feature
    [BluePillF4.kicad_pcb, BluePillF4.sch]
2017-12-27 Updated BOM (was in .gitignore) Added PDF files for schematic and layout Added component fields
    [BluePillF4.csv, BluePillF4.kicad_pcb, BluePillF4.sch]
2017-12-27 Corrected some BOM PARTNO for capacitors, added PARTNO for some resistors
    [BluePillF4.csv, BluePillF4.sch]
2017-12-28 Added inductor on SDIO_VDD to prevent transcient upon hot SDCard insertion
    [BluePillF4.csv, BluePillF4.kicad_pcb, BluePillF4.sch]
2017-12-30 Cleanup Tracks and Vias
    [BluePillF4.kicad_pcb, BluePillF4.sch]
2018-01-01 Gerber files checked with gerbView Removed unnecessary labels in schematic Corrected pads for FC-2M crystal
    [BluePillF4.kicad_pcb, BluePillF4.sch]
2018-01-02 Added FreeCAD source 3D files for original 3D models Removed unused 3D models Made 3D models relative to project directory Improved 3D model for microUSB connector
    [1616 RGB LED Anode.fcstd, 1616 RGB LED Assembly.fcstd, 1616 RGB LED Blue.fcstd, 1616 RGB LED Body.fcstd, 1616 RGB LED Cathode.fcstd, 1616 RGB LED Green.fcstd, 1616 RGB LED Lens.fcstd, 1616 RGB LED Pad.fcstd]
2018-01-13 Added LiPo battery charger circuit (option) Put AGND on the analog LDO instead of GND Improved the analog power supply filter Aligned the pads for the PC1-PC7 pins with a 1.27 mm pitch. Now PC0 is us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
    [BluePillF4-1.sch, BluePillF4-2.sch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]
2018-01-14 Fixed silkscreen on PC7 pad
    [BluePillF4-B.Mask.gbr, BluePillF4-B.Paste.gbr, BluePillF4-B.SilkS.gbr, BluePillF4-Bottom.gbr, BluePillF4-Edge.Cuts.gbr, BluePillF4-F.Mask.gbr, BluePillF4-F.Paste.gbr, BluePillF4-F.SilkS.gbr]
2018-01-21 Lengthen 0603 resitor and capacitor pads by 5 mils for easier hand soldering Removed 3D model for R8 as it is not mounted for STM32F405 Added Aliexepress column in BOM
    [BluePillF4-B.Mask.gbr, BluePillF4-B.Paste.gbr, BluePillF4-B.SilkS.gbr, BluePillF4-Bottom.gbr, BluePillF4-Edge.Cuts.gbr, BluePillF4-F.Mask.gbr, BluePillF4-F.Paste.gbr, BluePillF4-F.SilkS.gbr]
2018-01-29 Replaced the MicroSD Card connector with a Molex 47309-2651 Added voltage sense resistor divider Cleaned up traces
    [BluePillF4-1.sch, BluePillF4-2.sch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]
2018-02-02 Corrected truncated measurement values for trace width and clearance
    [BluePillF4-B.Mask.gbr, BluePillF4-B.Paste.gbr, BluePillF4-B.SilkS.gbr, BluePillF4-Bottom.gbr, BluePillF4-Edge.Cuts.gbr, BluePillF4-F.Mask.gbr, BluePillF4-F.Paste.gbr, BluePillF4-F.SilkS.gbr]
2018-02-03 Applied suggested modifications by @victor_pv http://www.stm32duino.com/viewtopic.php?f=19&t=2633&p=40846#p40846
    [BluePillF4-B.Mask.gbr, BluePillF4-B.Paste.gbr, BluePillF4-B.SilkS.gbr, BluePillF4-Bottom.gbr, BluePillF4-Edge.Cuts.gbr, BluePillF4-F.Mask.gbr, BluePillF4-F.Paste.gbr, BluePillF4-F.SilkS.gbr]
2018-02-03 Changed zone min. width and clearance to 6 mils Changed Micro USB footprint for pads to be farther from PCB edge
    [BluePillF4-B.Mask.gbr, BluePillF4-B.Paste.gbr, BluePillF4-B.SilkS.gbr, BluePillF4-Bottom.gbr, BluePillF4-Edge.Cuts.gbr, BluePillF4-F.Mask.gbr, BluePillF4-F.Paste.gbr, BluePillF4-F.SilkS.gbr]
2018-02-03 Put dial vias close to each other for power traces
    [BluePillF4-B.Mask.gbr, BluePillF4-B.Paste.gbr, BluePillF4-B.SilkS.gbr, BluePillF4-Bottom.gbr, BluePillF4-Edge.Cuts.gbr, BluePillF4-F.Mask.gbr, BluePillF4-F.Paste.gbr, BluePillF4-F.SilkS.gbr]
2018-02-04 Centered value fields in the component silkscreen outline to generate assembly drawings
    [BluePillF4-B.Mask.gbr, BluePillF4-B.Paste.gbr, BluePillF4-B.SilkS.gbr, BluePillF4-Bottom.gbr, BluePillF4-Edge.Cuts.gbr, BluePillF4-F.Mask.gbr, BluePillF4-F.Paste.gbr, BluePillF4-F.SilkS.gbr]
2018-02-04 Fixed some errors flagged by BayArea DFM, plus another one
    [BluePillF4-B.Mask.gbr, BluePillF4-B.Paste.gbr, BluePillF4-B.SilkS.gbr, BluePillF4-Bottom.gbr, BluePillF4-Edge.Cuts.gbr, BluePillF4-F.Mask.gbr, BluePillF4-F.Paste.gbr, BluePillF4-F.SilkS.gbr]
2018-09-01 Modified 3D model paths for Kicad v5
    [BluePillF4.kicad_pcb]
2018-09-01 Modified schematics and project files for Kicad v5
    [BluePillF4.sch]
2019-04-03 added EagleCAD version
    [1616 RGB LED Anode.fcstd, 1616 RGB LED Assembly.fcstd, 1616 RGB LED Blue.fcstd, 1616 RGB LED Body.fcstd, 1616 RGB LED Cathode.fcstd, 1616 RGB LED Green.fcstd, 1616 RGB LED Lens.fcstd, 1616 RGB LED Pad.fcstd]
