rogerclarkmelbourne/STM32_Pill_Boards/(notices)

Notices in the files:
Squonk42/KiCAD/BluePillF4-1.sch:
© 2017-2018 www.stm32duino.com, All rights reserved.
Squonk42/EagleCAD/BluePillF4 Teardrops Panel.brd:
BluePill F4 (c) 2017
Squonk42/EagleCAD/BluePillF4.brd:
(c) 2017-2018
Squonk42/KiCAD/BluePillF4.kicad_pcb:
© 2017-2018, All rights reserved.
parts and their libraries:
BluePillF4: See creativecommons.org/licenses/by-sa/4.0/ for details.
BluePillF4: See creativecommons.org/licenses/by-sa/3.0/ for details.
